StefanD2/Diplomarbeit_Hovercraft/README.md

# Diplomarbeit_Hovercraft
Diplomarbiet der HTBLuVA St. Pölten, Abteilung Elektrotechnik

## Schüler
* Stefan Deimel
* Philipp Eilmsteiner
* Julia Stöger
