StefanD2/Diplomarbeit_Hovercraft/Doku/Textparts/zusammenfassung.tex

\selectlanguage{naustrian}
\begin{abstract}
Das Ziel unserer Diplomarbeit ist es, aus einem Schlauchboot ein funktionstüchtiges elektrisches Luftkissenboot zu bauen, welches
sich sowohl am Land als auch über Wasser fortbewegen kann.\\
Mit einem von einem Elektromotor angetriebenen Propeller wird ein nach unten gerichteter Luftstrom erzeugt, auf welchem das Boot schwebt. Der zweite Propeller zeigt nach hinten und ist somit für den Vortrieb verantwortlich. Um das Boot lenkbar zu machen, sind drei servo-gesteuerte Fahnen zum Umlenken des Luftstroms am Heck montiert.\\
Der Fahrer ist in der Lage, das Luftkissenboot mit einem Lenker und zwei Daumengashebel zu steuern.
\end{abstract}
