StefanD2/Diplomarbeit_Hovercraft/Doku/Textparts/Kostenrechnung.tex

\section{Konstruktion}
\begin{table}[H]
    \centering
    \begin{tabular}{|l|r|}
        \hline
        \textbf{Beschreibung} & \textbf{Kosten}\\\hline
        diverse Kleinteile & 60\euro\\
        Fahrradlenker & 21\euro\\
        Holzlatten \&\ Staffel & 21\euro\\
        Holzschrauben & 15\euro\\
        Lochband & 14\euro\\
        metrische Schrauben \&\ Muttern & 60\euro\\
        Pappelsperrholz & 80\euro\\
        Pattex Kraftkleber & 18\euro\\
        PETG Filament & 22\euro\\
        Propeller & 276\euro\\
        Teichfolie & 22\euro\\
        Winkelverbinder & 50\euro\\
        \acs{xps} & 74\euro\\        
        \hline
        Zwischensumme & 733\euro\\\hline
    \end{tabular}
    \caption{Kostenrechnung -- Konstruktion}
\end{table}

\section{Leistungselektronik}
\begin{table}[H]
    \centering
    \begin{tabular}{|l|r|}
        \hline
        \textbf{Beschreibung} & \textbf{Kosten}\\\hline
        Akkus & 1\,672\euro\\
        Buck-Converter & 47\euro\\
        Hauptrelais & 162\euro\\
        Kupferschiene & 62\euro\\
        Ladegerät \&\ Schaltnetzteil & 520\euro\\
        Motoren & 2\,100\euro\\
        Motorregler \&\ Jeti-Box & 1\,079\euro\\
        Schmelzsicherungen & 15\euro\\
        Servos & 135\euro\\
        \hline
        Zwischensumme & 5\,792\euro\\\hline
    \end{tabular}
    \caption{Kostenrechnung -- Leistungselektronik}
\end{table}

\section{Boardelektronik}
\begin{table}[H]
    \centering
    \begin{tabular}{|l|r|}
        \hline
        \textbf{Beschreibung} & \textbf{Kosten}\\\hline
        4-poliges Kabel 100m & 30\euro\\
        Adafruit Servo-Modul & 13\euro\\
        Arduino-Nanos & 20\euro\\
        CAN-bus Module & 33\euro\\
        Daumengashebel & 28\euro\\
        diverse Kleinteile & 200\euro\\
        diverse Steckverbinder & 200\euro\\
        GPS-Modul & 13\euro\\
        Nextion-Display & 60\euro\\
        Not-Aus--Schalter & 68\euro\\        
        \hline
        Zwischensumme & 665\euro\\\hline
    \end{tabular}
    \caption{Kostenrechnung -- Leistungselektronik}
\end{table}

\section{Gesamtkosten}
\begin{table}[H]
    \centering
    \begin{tabular}{|l|r|}
        \hline
        \textbf{Beschreibung} & \textbf{Kosten}\\\hline
        Konstruktion & 733\euro\\
        Leistungselektronik & 5\,897\euro\\
        Boardelektronik & 665\euro\\
        \hline
        \textbf{Summe} & \textbf{7\,190\euro}\\\hline
    \end{tabular}
    \caption{Kostenrechnung -- Gesamtkosten}
\end{table}

\textbf{Anmerkung:}\\
Die hohen Gesamtkosten entstanden durch die hohe benötigte Motorleistung, welche den Preis der Motoren, der Motorregler und der Akkus begründet. Deshalb konnte diese Diplomarbeit nur durch die finanzielle Unterstützung unserer Sponsoren verwirklicht werden.
