StefanD2/Diplomarbeit_Hovercraft/Doku/Textparts/literatur.tex

%% start of file literatur.tex

%% Literaturverzeichnis:
\begin{Literatur}

    \bibitem[1]{YoutubeVideo}{\url{https://youtu.be/fBdnjvSfNkg}\\ Abgerufen am 17.3.2021} 
    \bibitem[2]{Inventor}{\url{https://www.autodesk.com/products/inventor/overview?term=1-YEAR&support=null}\\ Abgerufen am 16.3.2020} 
    \bibitem[3]{PlatformIO}{\url{https://platformio.org/platformio-ide}\\ Abgerufen am 19.3.2020} 
    \bibitem[4]{AnleitungJetiBox}{\url{http://www.jetimodel.com/en/show-file/47}\\ Abgerufen am 25.3.2020}
    \bibitem[5]{AnleitungMasterSpin}{\url{http://www.jetimodel.com/de/show-file/125}\\ Abgerufen am 25.03.2021}
    \bibitem[6]{ArduinoBibliothekCANBus}{\url{https://github.com/autowp/arduino-mcp2515}\\ Abgerufen am 31.03.2021}
    \bibitem[7]{ArduinoBibliothekServoPWM}{\url{https://github.com/adafruit/Adafruit-PWM-Servo-Driver-Library}\\ Abgerufen am 31.03.2021}
    \bibitem[8]{ArduinoBibliothekADS1115}{\url{https://github.com/adafruit/Adafruit_ADS1X15}\\ Abgerufen am 31.03.2021}
    \bibitem[9]{ArduinoBibliothekNextion}{\url{https://github.com/itead/ITEADLIB_Arduino_Nextion}\\ Abgerufen am 31.03.2021}
    \bibitem[10]{ArduinoBibliothekGPS}{\url{https://github.com/mikalhart/TinyGPSPlus}\\ Abgerufen am 31.03.2021}
    \bibitem[11]{JetiTelemtry}{\url{http://www.jetimodel.com/en/show-file/935/}\\ Abgerufen am 01.04.2021}
\end{Literatur}

%% end of file literatur.tex
