StefanD2/Diplomarbeit_Hovercraft/Doku/Textparts/danksagungen.tex

%% start of file danksagungen.tex

%% Danksagungen:
\begin{Danksagung}
    \responsible{Stefan Deimel, Philipp Eilmsteiner, Julia Stöger}
An dieser Stelle möchten wir uns bei all jenen bedanken, die uns bei unserer Diplomarbeit tatkräftig unterstützt und motiviert haben. \\

Zuerst bedanken wir uns recht herzlich bei Herrn Dipl.-Ing. Helge Frank, der uns während dieser Arbeit mit seinem Fachwissen unterstützt und weitergeholfen hat. 
Durch sein besonderes Interesse an dem Projekt gelang es ihm, sein Wissen sehr gut an uns zu übermitteln. \\

Weiters möchten wir uns bei Herrn Fachlehrer Meiseneder und bei Herrn Fachlehrer Binder für die großartige Unterstützung bei fehlendem Werkzeug und Fragen 
rund um das Thema Elektronik bedanken. Außerdem wollen wir auch allen anderen \\ Lehrerinnen und Lehrer danken, die uns mit ihrem Wissen weitergeholfen haben. \\

Spezieller Dank gilt auch unseren Familien, die uns stets motiviert haben und mental zur Seite gestanden sind. \\

Dank gebührt auch Herrn Ing. Andreas Bergen für seine tatkräftige Unterstützung und Ideen zu unserer Diplomarbeit. \\

Für die sehr gute Zusammenarbeit und die finanzielle Unterstützung bedanken wir uns bei all unseren Sponsoren: Schrack for Students, Schmied \&\ Fellmann, Kustec, EMC und Gottwald.\\
\end{Danksagung}
\newpage

%% end of file danksagungen.tex
