StefanD2/Diplomarbeit_Hovercraft/Doku/Textparts/abkuerzungen.tex

%% start of file abkuerzungen.tex

% Abkuerzungsverzeichnis
\addchap{
	\iflanguage{english}{Acronyms}{Abkürzungsverzeichnis}}
\begin{acronym}[ACRONYM]
%\acro{tikz}[TikZ]{\TikZ{} ist kein Zeichenprogramm}
\acro{spi}[SPI]{Serial Peripheral Interface}
\acro{i2c}[I$^2$C]{Inter-Integrated Circuit}
\acro{xps}[XPS]{Extrudiertes Polystyrol}
\acro{can}[CAN]{Controller Area Network}
\end{acronym}\newpage

%% end of file abkuerzungen.tex
