StefanD2/Diplomarbeit_Hovercraft/Doku/Textparts/Deimel/Leistungselektronik/Leistungselektronik.tex

\section{Schaltplan}
\begin{figure}[H]
    \input{Schaltplan.tex}
    \caption{Schaltplan Leistungselektronik\label{fig:schaltLeistung}}
\end{figure}
Für die Verbindung zwischen Board- und Leistungselektronik siehe \autoref{fig:SchaltplanBoardelektronik}.
Um die Lesbarkeit des Planes möglichst gut zu erhalten, wurde sowohl bei den PWM- als auch bei den Serial-Leitungen der beiden Motorregler auf das Einzeichnen separater +5V sowie GND Leitungen verzichtet und stattdessen mithilfe von doppelten Linien darauf aufmerksam gemacht.

\clearpage
\section{Verkabelung}
Da wir mit beiden Motoren einen Strom von 400A haben, verwenden wir Kupferschienen zur Verteilung dieses Stromes.\\
Die Akkus gehen jeweils mit beiden Anschlüssen über einen 10mm\textsuperscript{2}-Draht auf eine Kupferschiene. Die Motorregler sind ebenfalls mit jeweils zwei 10mm\textsuperscript{2}-Drähten angeschlossen, um bei diesen hohen Strömen möglichst wenig Spannungsabfall zu haben.\\
Das Hauptrelais ist über die Schmelzsicherungen direkt mit den Kupferschienen verschraubt.
\begin{figure}[H]
    
    \caption{Verkabelung Kupferschienen}
\end{figure}

\clearpage
