StefanD2/Diplomarbeit_Hovercraft/Doku/Textparts/Eilmsteiner/Boardelektronik/Platinen.tex

\clearpage
\section{Steuerungsplatinen}
\subsection{Schaltplan -- Übersicht}
\vspace{-0.2cm}
\begin{figure}[H]
    \centering
    \input{Uebersicht.tex}
    \caption{Schaltplan Boardelektronik\label{fig:SchaltplanBoardelektronik}}
\end{figure}
\vspace{-0.5cm}
{\small
Auf die Versorgung der LM35-Temperatursensoren, sowie der beiden Daumengase und dem Lenkpotenziometer mit +5V und GND wurde aus Platzgründen im obigen Plan verzichtet und stattdessen mit doppelten Linien aufmerksam gemacht. 
Siehe zudem \autoref{fig:schaltLeistung} für die Verbindung des Planes zur Leistungselektronik.
}

\newpage
\subsection{Motorregleransteuerung\label{sec:Motorregleransteuerung}}
\subsubsection{Aufgaben \& verwendete Bauteile}
Diese Platinen wandeln die entsprechenden vom CAN-Bus übertragenen Daten mithilfe ihres 16-bit Timers (Timer1 des ATMEGA328p) in ein für unseren Motorregler verständliches PWM-Muster um.
Gleichzeitig übermitteln sie die von den Motorreglern übertragenen Telemetriedaten an den Controller des Lenkers.

\begin{minipage}{8.5cm}
    \begin{tikzpicture}
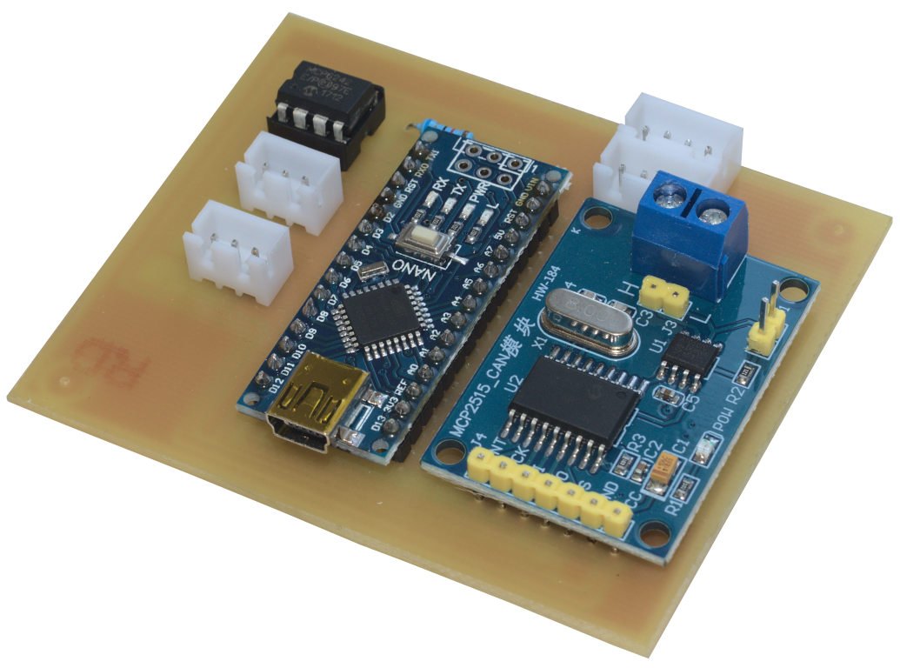
[picture p20: Doku/Fotos/Regler_Platine.png]
        \node[anchor=south west,inner sep=0] (image) at (0,0) {};
        \begin{scope}[x={(image.south east)},y={(image.north west)}]
            \draw[red,ultra thick,rounded corners,rotate around={-23:(0.68,0.68)}] (0.62,0.67) rectangle (0.8,0.9);
            \draw[blue,ultra thick,rounded corners,rotate around={-20:(0.3,0.68)}] (0.2,0.53) rectangle (0.35,0.7);
            \draw[orange,ultra thick,rounded corners,rotate around={-20:(0.35,0.78)}] (0.26,0.66) rectangle (0.41,0.8);
        \end{scope}
    \end{tikzpicture}
    \captionof{figure}{Platine zur Regleransteuerung}
\end{minipage}
\begin{minipage}{7cm}
    \textcolor{red}{CAN-Bus Anschlüsse}\\
    \textcolor{orange}{Serielle Verbindung zum Regler}\\
    \textcolor{blue}{PWM-Ausgang}\\

\end{minipage}

\subsubsection{Anmerkung:}
Durch die Verwendung der seriellen Schnittstelle des Arduinos muss zur Programmierung der Operationsverstärker entfernt werden.
\newpage

\subsubsection{Schaltplan}
\begin{figure}[h]
    \centering
        
    \caption{Schaltplan der Regler-Platine\label{fig:plat:regler}}
\end{figure}

\newpage

\subsubsection{PCB-Layout}
\begin{figure}[h]
    \centering
        
    \caption{PCB-Layout der Regler-Platine}
\end{figure}

\newpage
\subsubsection{Programmcode}
\lstinputlisting{../Programmierung/Regler_Controller/src/main.cpp}
\newpage
\subsection{Lenker\label{sec:Lenkerplatine}}
\subsubsection{Aufgaben \& verwendete Bauteile}
Neben seiner Hauptaufgabe, nämlich dem Einlesen und der Übertragung der beiden Daumengas- sowie Lenkerstellungen, ist dieser Mikrocontroller weiters für die Darstellung der von den verschiedenen Komponenten erhaltenen Telemetriedaten auf dem Bildschirm verantwortlich.
Dazu zählen neben den Informationen über die beiden Motoren vor allem auch die Temperaturen aller verbauten Akkus sowie die per GPS-Modul ermittelte derzeitige Geschwindigkeit.

\begin{minipage}{8.5cm}
    \begin{tikzpicture}
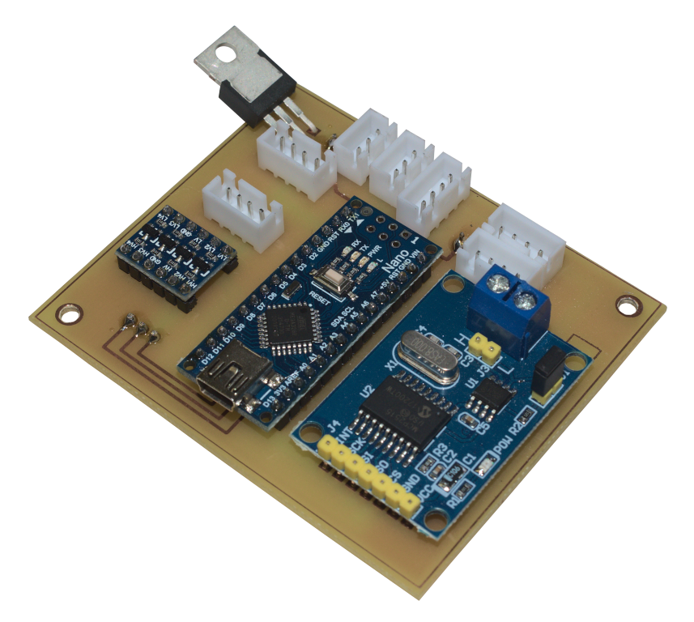
[picture p21: Doku/Fotos/Regler_Lenker.png]
        \node[anchor=south west,inner sep=0] (image) at (0,0) {};
        \begin{scope}[x={(image.south east)},y={(image.north west)}]
            \draw[red,ultra thick,rounded corners,rotate around={-30:(0.77,0.47)}] (0.6,0.47) rectangle (0.77,0.62);
            \draw[blue,ultra thick,rounded corners,rotate around={-30:(0.4,0.58)}] (0.25,0.58) rectangle (0.4,0.68);
            \draw[orange,ultra thick,rounded corners,rotate around={-30:(0.47,0.67)}] (0.33,0.67) rectangle (0.47,0.76);
            \draw[Green,ultra thick,rounded corners,rotate around={-34:(0.57,0.67)}] (0.45,0.67) rectangle (0.57,0.8);
            \draw[violet,ultra thick,rounded corners,rotate around={-34:(0.62,0.60)}] (0.54,0.60) rectangle (0.62,0.75);
        \end{scope}
    \end{tikzpicture}
    \captionof{figure}{Platine des Lenkers}
\end{minipage}
\begin{minipage}{7cm}
    \textcolor{red}{CAN-Bus Anschlüsse}\\
    \textcolor{blue}{Serielle Verbindung zum GPS-Modul}\\
    \textcolor{orange}{Serielle Verbindung zum Bildschirm}\\
    \textcolor{Green}{Daumengas Anschlüsse}\\
    \textcolor{violet}{Anschluss Lenkerpotenziometer}\\

\end{minipage}

\vspace{0.5cm}
\begin{minipage}{7.5cm}
    \centering
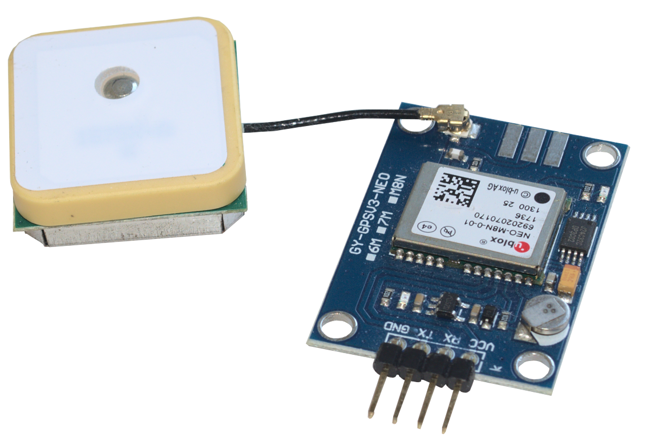
[picture p22: Doku/Fotos/GPS_Modul_2.png]
    
    \captionof{figure}{NEO-8M GPS-Modul}
\end{minipage}
\hspace{0.1cm}
\begin{minipage}{7.5cm}
    \centering
    
    \captionof{figure}{Daumengas}
\end{minipage}

\newpage

\subsubsection{Schaltplan}
\begin{figure}[h]
    \centering
        
    \caption{Schaltplan der Lenker-Platine\label{fig:plat:lenker}}
\end{figure}

\newpage

\subsubsection{PCB-Layout}
\begin{figure}[h]
    \centering
        
    \caption{PCB-Layout der Lenker-Platine}
\end{figure}

\newpage
\subsubsection{Programmcode}
\lstinputlisting{../Programmierung/Lenker_Controller/src/main.cpp}

\newpage

\subsection{Fahnenansteuerung \&\ Akkutemperaturen\label{sec:Servoplatine}}
\subsubsection{Fahnenansteuerung}
Die Ansteuerung der Servos erfolgt ebenfalls mit einem per CAN-Bus angeschlossenen Arduino. Um die für die Steuerung der drei Servos benötigten PWM-Signale, unabhängig von den durch den Arduino bereitgestellten Timer und den damit verbundenen GPIOs, zu erzeugen 
(Anbindung des CAN-Bus Moduls über SPI benötigt beispielsweise diese Pins und Timer), wurde dafür auf ein externes Board zurückgegriffen.

\begin{minipage}{8.5cm}
    \begin{tikzpicture}
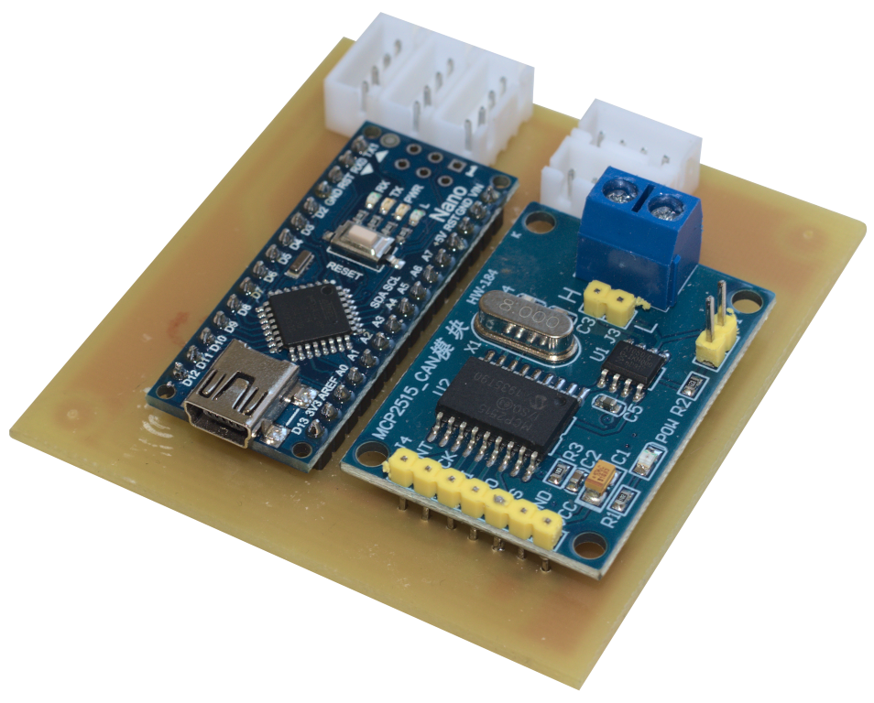
[picture p23: Doku/Fotos/Regler_Servos.png]
        \node[anchor=south west,inner sep=0] (image) at (0,0) {};
        \begin{scope}[x={(image.south east)},y={(image.north west)}]
            \draw[red,ultra thick,rounded corners,rotate around={-23:(0.64,0.68)}] (0.58,0.67) rectangle (0.78,0.9);
            \draw[blue,ultra thick,rounded corners,rotate around={-20:(0.5,0.9)}] (0.37,0.76) rectangle (0.63,0.99);
        \end{scope}
    \end{tikzpicture}
    \captionof{figure}{Platine zur Regleransteuerung}
\end{minipage}
\begin{minipage}{7cm}
    \textcolor{red}{CAN-Bus Anschlüsse}\\
    \textcolor{blue}{I2C Anschlüsse}\\
    
\end{minipage}\\

Konkret handelt es sich um das \textbf{16-Channel 12-bit PWM/Servo Driver Module} von Adafruit, welcher mittels I2C mit dem Mikrocontroller kommuniziert.\\
\begin{figure}[h]
    \centering
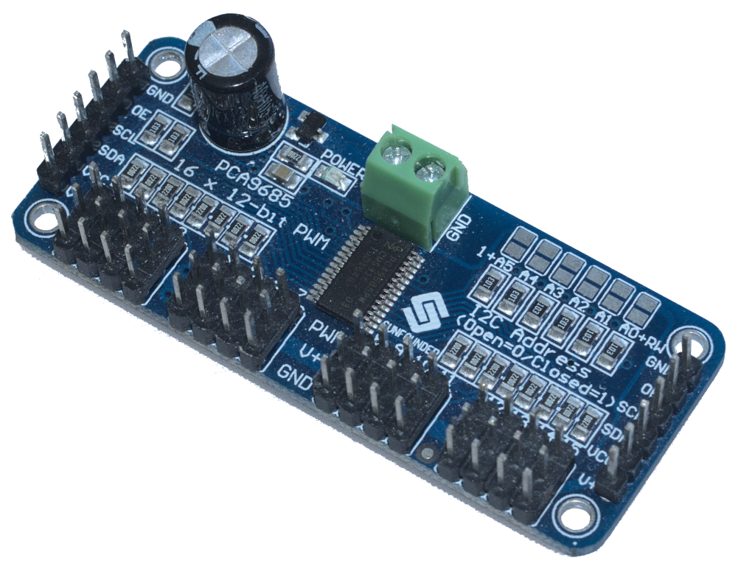
[picture p24: Doku/Fotos/Servo_Controller.png]
    
    \caption{Adafruit 16-Channel Servo Driver}
\end{figure}

\newpage
\subsubsection{Schaltplan}
\begin{figure}[h]
    \centering
        
    \caption{Schaltplan der Servoansteuerungs-Platine\label{fig:plat:servo}}
\end{figure}

\newpage
\subsubsection{PCB-Layout}
\begin{figure}[h]
    \centering
        
    \caption{PCB-Layout der Servoansteuerungs-Platine}
\end{figure}

\newpage
\subsubsection{Programmcode}
\lstinputlisting{../Programmierung/Servo_ADC_Controller/src/main.cpp}
\newpage

\subsubsection{Akkutemperaturen}
Die zweite Aufgabe dieses Controllers ist es, die Temperaturen aller acht im Boot verbauten Akkus zu überwachen, und diese zur Darstellung an den Controller des Lenkers zu übermitteln.
Dies geschieht mithilfe zweier (je einer pro Seite), ebenfalls über I2C verbundenen, \textbf{ADS1115} Analog-Digital-Wandler, welche wiederum von Adafruit stammen.\\
Zur Temperaturmessung selbst kommt je ein \textbf{LM35} Temperatursensor pro Akku zum Einsatz.\\

\begin{minipage}{8cm}
    \centering
    
    \captionof{figure}{ADS1115 Modul}    
\end{minipage}
\begin{minipage}{8cm}
    \centering
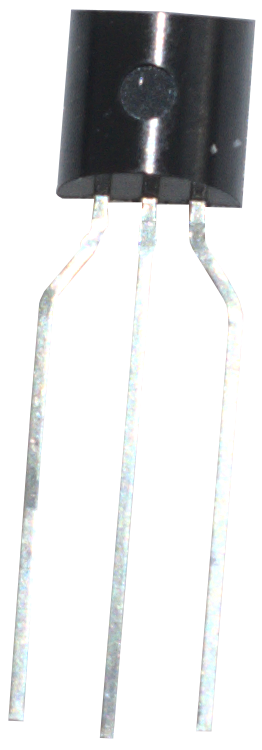
[picture p25: Doku/Fotos/LM35.png]
    
    \captionof{figure}{LM35}
\end{minipage}\\
\vspace{0.5cm}

\subsection{ADC-Platinen}
Um den Anschluss der Temperatursensoren an diesem ADC zu vereinfachen, wurde folgende Platine entworfen:\\ 
\begin{minipage}{9cm}
    \begin{tikzpicture}
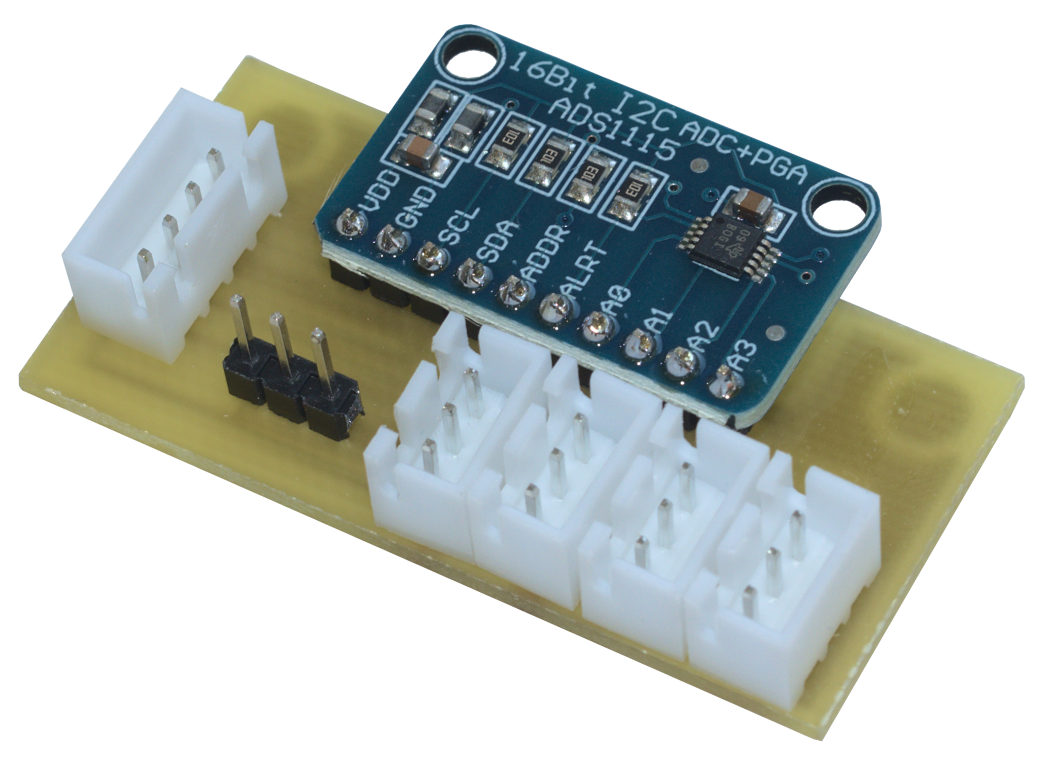
[picture p26: Doku/Fotos/ADC_Platine.png]
        \node[anchor=south west,inner sep=0] (image) at (0,0) {};
        \begin{scope}[x={(image.south east)},y={(image.north west)}]
            \draw[red,ultra thick,rounded corners,rotate around={-23:(0.78,0.0)}] (0.25,0.0) rectangle (0.78,0.4);
            \draw[blue,ultra thick,rounded corners,,rotate around={-30:(0.00,0.59)}] (0.00,0.59) rectangle (0.20,0.99);
            \draw[Green,ultra thick,rounded corners,,rotate around={-27:(0.3,0.4)}] (0.15,0.4) rectangle (0.34,0.57);
        \end{scope}
    \end{tikzpicture}
    \captionof{figure}{Platine Temperatursensoren}
\end{minipage}
\begin{minipage}{7cm}
    \textcolor{red}{Analogeingänge}\\
    \textcolor{blue}{I2C Anschluss}\\
    \textcolor{Green}{I2C Adressen-Jumper}\\
\end{minipage}\\

\newpage
\subsubsection{Schaltplan}
\begin{figure}[h]
    \centering
        
    \caption{Schaltplan der Temperatursensoren-Platine\label{fig:plat:temp}}
\end{figure}

\newpage

\subsubsection{PCB-Layout}
\begin{figure}[h]
    \centering
        
    \caption{PCB-Layout der Temperatursensoren-Platine}
\end{figure}

\newpage
\subsection{Precharge \& Relaisansteuerung\label{sec:precharge}}
Da sowohl die Motorregler als auch die Buck-Converter einen, bedingt durch die darin verbauten sehr großen Kondensatoren, sehr großen Einschaltstrom haben, 
müssen diese über einen Leistungswiderstand vorgeladen werden, bevor sie permanent mit Spannung versorgt werden können.\\
\begin{figure}[h]
    \centering
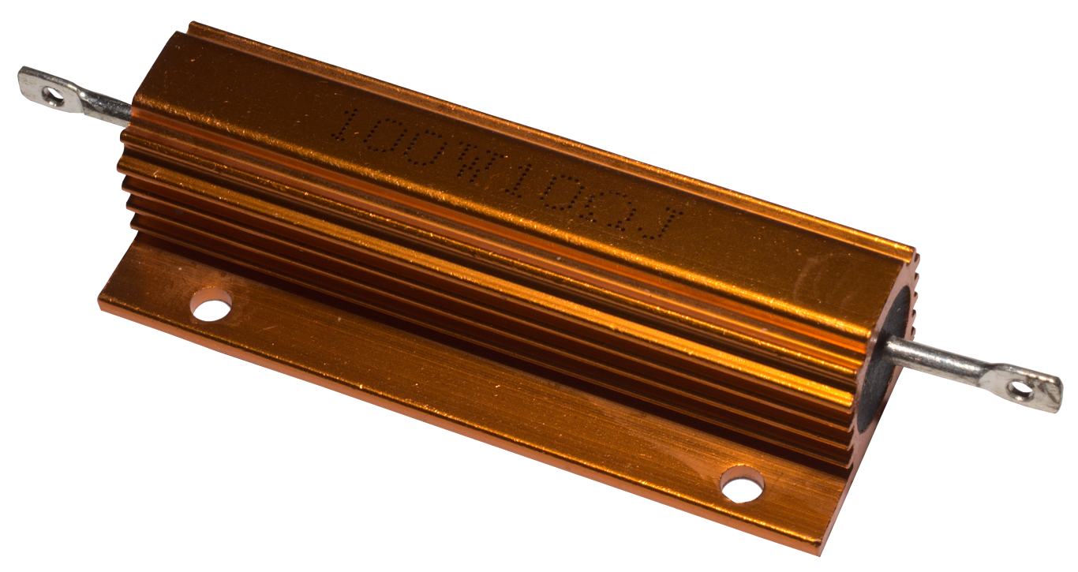
[picture p27: Doku/Fotos/Leistungswiderstand.png]
    
    \caption{Zur Vorladung verwendeter Leistungswiderstand}
\end{figure}

Um diese Umschaltung so einfach wie möglich zu gestalten, wurde dies mithilfe einer im Folgenden genauer erläuterten Platine realisiert. 

\begin{minipage}{9cm}
    \begin{tikzpicture}
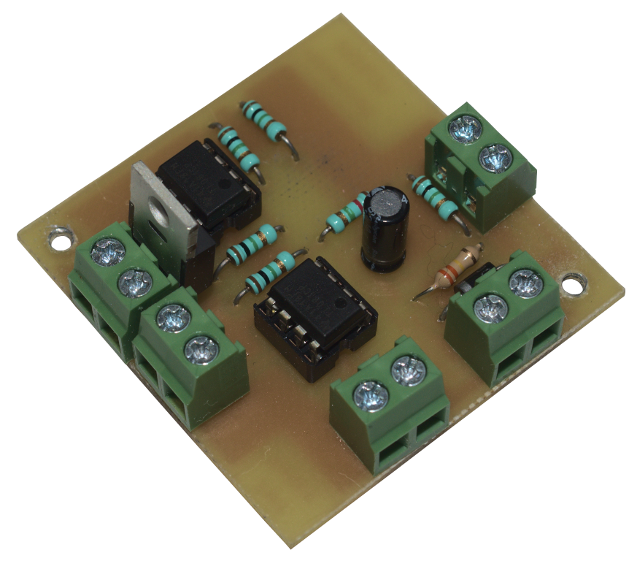
[picture p28: Doku/Fotos/Platine_Relaischaltung.png]
        \node[anchor=south west,inner sep=0] (image) at (0,0) {};
        \begin{scope}[x={(image.south east)},y={(image.north west)}]
            \draw[red,ultra thick,rounded corners,rotate around={30:(0.58,0.11)}] (0.58,0.11) rectangle (0.79,0.35);
            \draw[blue,ultra thick,rounded corners,rotate around={30:(0.77,0.28)}] (0.77,0.28) rectangle (0.97,0.51);
            \draw[orange,ultra thick,rounded corners,rotate around={37:(0.29,0.21)}] (0.29,0.21) rectangle (0.46,0.42);
            \draw[Green,ultra thick,rounded corners,rotate around={37:(0.16,0.38)}] (0.16,0.38) rectangle (0.34,0.55);
            \draw[violet,ultra thick,rounded corners,rotate around={40:(0.78,0.56)}] (0.78,0.56) rectangle (0.93,0.81);
        \end{scope}
    \end{tikzpicture}
    \captionof{figure}{Platine zur Relaisansteuerung}
\end{minipage}
\begin{minipage}{7.5cm}
    \textcolor{Green}{Hauptrelaisspule (A- \& GND) (J6)}\\
    \textcolor{blue}{Micro-Switches im Ladedeckel (J1)}\\
    \textcolor{orange}{Buck-Converter (nicht verwendet) (J2)}\\
    \textcolor{violet}{+30 V von geschalteter Relaisseite (J7)}\\
    \textcolor{red}{Konstante +30 V (J8)}\\
\end{minipage}\\

\textbf{Anmerkung:}\\
Die Relais der Buck-Converter werden nicht mehr, wie ursprünglich gedacht, über eine separate Zeitkonstante angesteuert, sondern verwenden nun den selben MOSFET wie das Hauptrelais. 

\newpage
\subsubsection{Funktionsweise}
Durch das Zusammenschalten der Akkus über den bereits zuvor gezeigten $10\,\mathrm{\Omega}$ Leistungswiderstand beginnen sich sowohl die Kondensatoren beider Motorregler und aller vier Buck-Converter, sowie jener des sich auf der Platine befindlichen RC-Gliedes aufzuladen.\\
Erreicht dieser eine bestimmte Schwellspannung, wird das Hauptrelais mithilfe eines MOSFETs durch den Operationsverstärker der Komperatorschaltung aktiviert.\\
Dies führt zu einer Selbsthaltung des Relais, welche nur durch Betätigung des Not-Aus--Schalters oder das Öffnen einer der beiden Mikroschalter unterbrochen werden kann.\\
Der genaue Anschluss an die Leistungselektronik kann \autoref{fig:schaltLeistung} entnommen werden.
\subsubsection{Schaltplan}
\begin{figure}[h]
    \centering
    
    \caption{Schaltplan der Platine zur Relaisansteuerung\label{fig:plat:relais}}
\end{figure}
\textbf{Anmerkung:}\\
Der OPV \textbf{U2} und die damit verbunde Klemme \textbf{J2} werden aufgrund einer nachträglichen Änderung im Schaltplan nicht mehr benötigt.
\newpage
\subsubsection{PCB-Layout}
\begin{figure}[h]
    \centering
    
    \caption{PCB-Layout der Platine zur Relaisansteuerung}
\end{figure}
\newpage

\subsection{Platzierung am Boot}
Die Abbildungen \ref{fig:Platinen:Aufbau_Rechts} \& \ref{fig:Platinen:Aufbau_Links} zeigen die Positionen aller verbauten Platinen am Boot.\\

\begin{minipage}{\textwidth}
    \centering
    \begin{tikzpicture}
        \node[anchor=south west,inner sep=0] (image) at (0,0) {};
        \begin{scope}[x={(image.south east)},y={(image.north west)}]
            \draw[blue,thick,->]  (0.66,0.85) -- (0.29,0.85) node [at start, above] {Temperatursensoren rechts} -- (0.22,0.40);
            \draw[black,thick,->]  (0.66,0.75) -- (0.29,0.75) node [at start, above] {Relaisansteuerung} -- (0.27,0.60);
            \draw[red,thick,->]  (0.66,0.65) -- (0.29,0.65) node [at start, above] {Regler-hinten Platine}  -- (0.27,0.51);
            \draw[black,thick,->]  (0.66,0.55) -- (0.5,0.55) node [at start, above] {Regler-unten Platine} -- (0.47,0.19);
            \draw[Green,thick,->]  (0.54,0.45) -- (0.78,0.45) node [midway, above] {Lenker Platine} -- (0.89,0.14);
        \end{scope}
    \end{tikzpicture}
    \captionof{figure}{Platinen auf der rechten Seite des Bootes}
    \label{fig:Platinen:Aufbau_Rechts}
\end{minipage}

\begin{minipage}{\textwidth}
    \centering
    \begin{tikzpicture}
        \node[anchor=south west,inner sep=0] (image) at (0,0) {};
        \begin{scope}[x={(image.south east)},y={(image.north west)}]
            \draw[red,thick,->]  (0.22,0.75) -- (0.5,0.75) node [midway, above] {Servo-ADC Platine}  -- (0.6,0.61);
            \draw[blue,thick,->]  (0.22,0.85) -- (0.5,0.85) node [midway, above] {Servo-Controller}  -- (0.61,0.81);
            \draw[black,thick,->]  (0.22,0.65) -- (0.49,0.65) node [near start, above] {Temperatursensoren links}  -- (0.545,0.42);
        \end{scope}
    \end{tikzpicture}
    \captionof{figure}{Platinen auf der linken Seite des Bootes}
    \label{fig:Platinen:Aufbau_Links}
\end{minipage}

\newpage
