StefanD2/Diplomarbeit_Hovercraft/Doku/Textparts/Deimel/Zeit/Zeit_Deimel.tex

14.02.2020 & 8 & Konstruktion in Inventor\\\hline
15.02.2020 & 4 & Konstruktion in Inventor\\\hline
28.02.2020 & 1 & Besprechung mit Betreungslehrer\\\hline
12.03.2020 & 1 & Besprechung mit Betreungslehrer\\\hline
13.03.2020 & 4 & Erstes Zusammenbauen des Hovercrafts\\\hline
14.05.2020 & 5 & Akkukabel gebaut, Motorregler \&\ Motorstecker montiert\\\hline
23.05.2020 & 5 & Propeller montiert, erste Tests am Hovercraft\\\hline
06.06.2020 & 7 & Jeti-Protokoll decodiert für Arduino\\\hline
18.06.2020 & 1 & Besprechung mit Betreuungslehrer, Bestellung vorbereitet\\\hline
27.07.2020 & 1 & Verbesserung der Konstruktion in Inventor\\\hline
29.07.2020 & 1 & Besprechung auf Teams, Festlegung von Meilensteinen\\\hline
03.08.2020 & 8 & Propeller zusammengebaut\\\hline
04.08.2020 & 3 & Tests am Hovercraft\\\hline
10.08.2020 & 8 & Bodenplatte/XPS gefertigt\\\hline
11.08.2020 & 7 & Bodenplatte/XPS + Holz gefertigt\\\hline
14.08.2020 & 5 & Motor montiert + Tests\\\hline
25.08.2020 & 7 & Transport des Luftkissenbootes in die Schule, Treffen mit SchrackForStudents\\\hline
17.09.2020 & 2 & Bestellliste für Elektronik erstellt, Bauteile ausgewählt\\\hline
20.09.2020 & 2 & Bestellliste für Elektronik erstellt, Bauteile ausgewählt\\\hline
25.09.2020 & 2 & Teichfolie geklebt\\\hline
21.10.2020 & 6 & Konstruktion in Inventor -- Aufbau hinten\\\hline
22.10.2020 & 2 & Konstruktion in Inventor -- Aufbau hinten, Fahnen + Halterung\\\hline
23.10.2020 & 1 & Logos von Kustec abgeholt\\\hline
23.10.2020 & 2 & Besprechung auf Teams, Obi-Einkauf \&\ nächste Schritte geplant\\\hline
24.10.2020 & 2 & Obi-Einkauf\\\hline
26.10.2020 & 1,5 & Programmierung JetiBox-Decode für Arduino verbessert (Buffer hinzugefügt)\\\hline
29.10.2020 & 6 & Verbesserung der Konstruktion in Inventor\\\hline
30.10.2020 & 6,5 & Verbesserung der Konstruktion in Inventor\\\hline
09.11.2020 & 4 & Konstruktion hinten am Boot befestigt\\\hline
10.11.2020 & 3 & Verstärkung des hinteren Aufbaues \\\hline
10.11.2020 & 1 & Besprechung mit Betreuungslehrer (Lenkung, derzeitiger Fortschritt)\\\hline
17.11.2020 & 2 & Test der Fahnensteuerung mit Servos\\\hline
21.11.2020 & 2 & Besprechung Teams: Elektronik und Lenkung, nächste Bestellung geplant\\\hline
21.11.2020 & 0,5 & Bauteile ausgewählt\\\hline
21.11.2020 & 1 & Lenkungsentwurf in Inventor gezeichnet\\\hline
25.11.2020 & 6 & hinteres Gitter montiert, Teichfolie geklebt\\\hline
28.11.2020 & 1 & RS-Bauteile ausgewählt\\\hline
29.11.2020 & 2 & Lenker in Inventor konstruiert\\\hline
30.11.2020 & 1 & Verbindungsteile für Lenkerstange in Inventor konstruiert\\\hline
16.12.2020 & 4 & Erste Versuche mit der fertigen Konstruktion\\\hline
15.12.2020 & 3 & Lasercutten\\\hline
27.12.2020 & 2 & Lasercutten und Inventor-Dateien vorbereitet\\\hline
28.12.2020 & 10,5 & Servos montiert, Lenkung getestet, CAN-Bus getestet\\\hline
28.12.2020 & 3 & Kupferschiene geschnitten (Gewinde), Schrauben zugeschnitten\\\hline
29.12.2020 & 7 & Kupferschienen und Bucks montiert\\\hline
01.01.2021 & 1 & M5 Schrauben geschnitten\\\hline
02.01.2021 & 12 & Kupferschiene und Temperatursensoren verkabelt, Reglerplatine gezeichnet\\\hline
03.01.2021 & 11 & Servos verkabelt, Lenkung moniert\\\hline
19.01.2021 & 5 & Platinen hergestellt, geätzt, gebohrt\\\hline
25.01.2021 & 8 & Taster, Not-Aus-Schalter montiert, HMI getestet, Balancer-Kabel gelötet\\\hline
26.01.2021 & 5 & weitere Platinen hergestellt, geätzt, gebohrt\\\hline
29.01.2021 & 9 & Platinen gebohrt, gelötet und im Hovercraft verbaut, Stecker an Kabel gelötet\\\hline
30.01.2021 & 11 & Erste Einschaltversuche durchgeführt\\\hline
02.02.2021 & 8 & Display getestet, Einschaltverzögerungsplatine getestet\\\hline
02.02.2021 & 1 & Proteus Platine Zeitverzögerung umgezeichnet\\\hline
07.02.2021 & 3 & Inventor-Modell in einzelnen Bauteile zerlegt, Doku weitergeschrieben\\\hline
13.02.2021 & 6 & Halbleiterrelais eingebaut - Defekt festgestellt, Platine gelötet, Zeichnungen in Inventor erstellt\\\hline
15.02.2021 & 4 & Boden geklebt\\\hline
16.02.2021 & 4 & Lochband fertiggestellt, Leiste fertiggestellt, fotografiert\\\hline
17.02.2021 & 11 & neues hinteres Gitter montiert,  Halbleiterrelais getestet - defekt\\\hline
02.03.2021 & 4 & Doku Konstruktion weitergeschrieben\\\hline
01.03.2021 & 5 & Strommessung am unteren Motor\\\hline
04.03.2021 & 4 & Probefahrt\\\hline
16.03.2021 & 5 & Doku weitergeschrieben\\\hline
17.03.2021 & 2 & Doku durchgelesen und verbessert\\\hline
18.03.2021 & 3 & Doku finalisiert\\\hline
