StefanD2/Diplomarbeit_Hovercraft/Doku/Textparts/Eilmsteiner/Leistungselektronik/Leistungselektronik.tex

\section{Motoren}
\begin{figure}[h]
    \centering
    
    \caption{Hacker A200 Elektromotor}
\end{figure}
\todo[]{Text und Bilder zu Motoren einfügen}
\newpage
\section{Motorregler}
Die Ansteuerung der Motoren übernimmt der dafür empfohlene \textbf{MasterSpin 220 Pro OPTO}.
\begin{figure}[h]
    \centering
    
    \caption{MasterSPIN 220 Pro OPTO}
\end{figure}
\subsection*{Parametrierung durch JetiBox}
Um den Regler auf unsere Bedürfnisse parametrieren zu können, wurde eine sogenannte "JetiBox" verwendet.
\begin{figure}[h]
    \centering
    
    \caption{Jetibox}
\end{figure}
\newpage
Um in das Konfigurationsmenü des Reglers zu gelangen, muss die JetiBox am kürzeren der beiden 3-poligen Kabeln des MasterSpin 220 PRO OPTO angeschlossenen werden (Jenes mit dem roten Stecker), 
während man das PWM-Kabel (länger \& schwarzer Stecker) abgeschlossen hat.\\

Konkret wurden folgende Einstellungen getroffen:\\
\begin{table}[h]
\centering
\begin{threeparttable}
    
    \begin{tabular}{|l|l|}
    \hline
     Menüpunkt & getroffene Einstellung \\\hline
     Temp. Protection & $90\,^\circ\,\textrm{C}$\\
     Brake & Hard 70/100/0,5s\\
     Operation Mode & Fast Response\\
     Autorotation & OFF\\
     Timing & $22^\circ$\\
     Frequency & 8 kHz\\
     Acceleration & 0-100\% 5,0 s\\
     Accumulator Type & Li-Ion/Pol/Fe\\
     Number of Cells & Li-XX 14\\
     Li-XX Cut OFF & V Per Cell 3.2\\
     Off Voltage Set & 44,75 V\\
     Cut OFF & Slow Down\\
     Initial Point & AUTO\\
     END Point & 2.05 ms / 2.15 ms \tnote{1}\\
     AutoInc.END Poin & OFF(FIX)\\
     Throttle Curve & Linear\\
     Rotation & Left \tnote{2}\\
     Start-up Power & Auto\\
     Setting th. R/C & OFF\\\hline
    \end{tabular}
    \begin{tablenotes}\footnotesize 
        \item[1] 2.15 ms zur Begrenzung der Motorleistung auf \\$\approx 90\%$
        \item[2] Abhängig von der Verkabelung des Motors 
        \end{tablenotes}
    \end{threeparttable}
    \caption{Durch JetiBox am Regler konfigurierte Parameter}
\end{table}

\newpage

\section{Hauptrelais}
Mit diesem Relais wird die Spannungsversorgung des gesamten Luftkissenbootes kontrolliert. Bedingt durch die Tatsache, dass das gewählte Ladegerät nur maximal 8S-Lipo Akkus laden kann und wir durch die Serienschaltung 2er 7S Akkus auf insgesamt 14S sind, 
wurde es zwischen den beiden Parallelschaltungen von jeweils 4 Akkus platziert. 
\begin{figure}[h]
    \centering
    
    \caption{TE Connectivity EV200 Kfz-Relais}
\end{figure}

\newpage
\section{Buck-Converter}
Die Versorgung der Bootelektronik und der Servos übernehmen Buck-Converter, von welchen jeweils einer für ein Servo und einer für die gesamte restliche Elektronilk verbaut sind.
\begin{figure}[h]
    \centering
    
    \caption{Buck Converter}
\end{figure}

Wichtig war bei der Auswahl dieser, auf die maximale Eingangsspannung von mindestens $60\,\mathrm{V}$ zu achten. Sehr viele der angebotenen Buck-Converter sind auf $40\,\mathrm{V}$ begrenzt und können daher nicht verwendet werden.
Auch ein Mindeststrom von $6\,\mathrm{A}$ sekundärseitig ist aufgrund des hohen Leistungsbedarfes der Servos von nöten. 
\newpage

\section{Akkus \label{sec:Akkus}}
Nach gründlicher Überlegung, welche Form von Energiespeicher für unser Boot die Beste wäre, fiel die Wahl auf die TopFuel LiPo 35C Power-X 7500mAh 7S.
Ursprüngliche Pläne den Akku selbst aus 18650-Zellen zusammenzubauen wurden verworfen, da er dadurch bei gleicher speicherbarer Energiemenge, deutlich schwerer und auch größer ausgefallen wäre.
\begin{figure}[h]
    \centering
    
    \caption{TopFuel Power-X 7500mAh 7S}
\end{figure}

Auf jeder Seite des Bootes sind, versteckt im hinteren Aufbau, jeweils vier von diesen Akkus verbaut. Mit einer Kapazität von $7500\,\textrm{mAh}$ und einer Nominalspannung von $25.9\,\mathrm{V}$ pro Akku ergibt sich somit eine Gesamtkapazität von zirka $1.55\,\mathrm{kWh}$.

\newpage
