StefanD2/Diplomarbeit_Hovercraft/Doku/diplomarbeit.tex

%% diplomarbeit.tex
%% Copyright 2015 Simon M. Laube
%
% This work may be distributed and/or modified under the
% conditions of the LaTeX Project Public License, either version 1.3
% of this license or (at your option) any later version.
% The latest version of this license is in
%   http://www.latex-project.org/lppl.txt
% and version 1.3 or later is part of all distributions of LaTeX
% version 2005/12/01 or later. 
%
% This work has the LPPL maintenance status `author maintained'.
% 
% The Current Maintainer of this work is S. M. Laube
%
% This work consists of the files listed in ./Help/files.txt
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
\usepackage[europeanresistors, europeaninductors, european, siunitx]{circuitikz}
% Nuetzliche TikZ Libraries
\usetikzlibrary{arrows,automata,positioning}
\usetikzlibrary{math}
\usetikzlibrary{fit}
% Mathematikpakete!
\usepackage{amsmath,amssymb}							
%\usepackage{mathtools}	
% PDF Einbindung (zB Datenblaetter)
\usepackage{pdfpages}
% Source Code Einbindung, Setup siehe:
% http://en.wikibooks.org/wiki/LaTeX/Source_Code_Listings									
\usepackage{listings,scrhack} %scrhack vermeidet Umschaltung auf KOMA Floats..

\usepackage{verbatim}
\usepackage{textcomp}
			
\usepackage{eurosym}
\usepackage{lscape}
% Diplomarbeitsspezifisches Package etdipa
\usepackage{etdipa}

%% Abkuerzungsverzeichnis
\usepackage[]{acronym}

%% Todos 
% --------------------------------------------------------------------------- TODONOTE PACKAGE ---------------------------------------------------------------------------%
%\usepackage[]{todonotes}

%% Ganttdiagramme
\usepackage{pgfgantt}

\usepackage{keyval}
\usepackage{caption}

%% Subfigures
\usepackage[lofdepth]{subfig}

%% HTL-Package (für HTL-Grün)
\usepackage{htlstp}

\usepackage{import}

\usepackage{array}
\usepackage{ragged2e}
\usepackage{csvsimple}

\usepackage{wasysym}
%\usepackage{afterpage}

%\usepackage{pdflscape}
\usepackage{lscape}

\usepackage{setspace}\usepackage{threeparttable}
\usepackage{graphbox} %loads graphicx package
\usepackage[most]{tcolorbox}
\usepackage{multirow}

\usepackage{longtable}

\usepackage{nameref}
\usepackage{arrayjob}
% folowing  must be in this order
\usepackage{varioref}
\usepackage[colorlinks=true,
			linkcolor=black,
			citecolor=green,
			bookmarks=true,
			urlcolor=blue,
			bookmarksopen=true]{hyperref}
\usepackage{cleveref}

\RedeclareSectionCommand[beforeskip=0pt]{chapter}

%------------------ DELETE THIS, JUST FOR SPEED -------------------%
% \pdfcompresslevel=0 
% \pdfobjcompresslevel=0
%------------------------------------------------------------------%

%%=== MY COMMANDS ====%%

\newcolumntype{M}[1]{>{\centering\arraybackslash}m{#1}}

\newcommand{\includeSkizze}[4]{
  \begin{figure}[H]
    \centering
    \resizebox{.95\textheight}{!}{
    
    }
    \caption{Zeichnung #2\label{#3}}
  \end{figure}
}

%%==== Definitionen fuer die Diplomarbeit ============%%
\dokumenttyp{DIPLOMARBEIT}
\title{Hovercraft}
\author{Stefan Deimel \and Philipp Eilmsteiner \and Julia Katharina Stöger}
\date{\today}
\place{St. P\"olten}
\schuljahr{2020/21}
\professor{Dipl.-Ing. Helge Frank}
\dipacolor{htlgruen}
%%====================================================%%

\lstset {
    language=C++,
    breaklines=true,
    postbreak=\mbox{\textcolor{red}{$\hookrightarrow$}\space},
    basicstyle=\scriptsize\ttfamily,
    keywordstyle=\color{red!60!blue}\ttfamily,
    stringstyle=\color{red}\ttfamily,
    commentstyle=\color{green!50!black}\ttfamily,
    numbers=left, numbersep=5pt,
    showspaces=false,
    showstringspaces=false,
    emph={
        uint16_t, uint32_t, size_t, string, std, override, private, public, class, int, double, float, char, long, bool, void, protected, virtual, static, volatile, __cplusplus, extern, ISR, true, false, this, namespace, if, else, for, while, return, sizeof, new, delete, unsigned, struct, typedef, nullptr, const 
    },emphstyle={\color{blue}\ttfamily},
    columns=fullflexible,keepspaces,
    literate=%
    {Ö}{{\"O}}1
    {Ä}{{\"A}}1
    {Ü}{{\"U}}1
    {ß}{{\ss}}1
    {ü}{{\"u}}1
    {ä}{{\"a}}1
    {ö}{{\"o}}1
    {~}{{\textasciitilde}}1
    {\# if}{{{{{\textcolor{red!60!blue}{\#if}}}}}}1
    {\# ifdef}{{{{{\textcolor{red!60!blue}{\#ifdef}}}}}}1
    {\# ifndef}{{{{{\textcolor{red!60!blue}{\#ifndef}}}}}}1,
}

%% ----------------- define für Leerseiten bei Doppelseitigem-Druck --------------- %%
% 1 akitv, nicht 1 inaktiv
%\def\emptyprintpages{1}
\def\emptyprintpages{0}

\def\blankpage{
      \clearpage
      \thispagestyle{empty}
      \addtocounter{page}{-1}
      \null
      \clearpage}

\begin{document}

\frontmatter

%%================ Titelseite ==========================%%
\maketitle
% Verantwortliche/Verfasser
\responsible{Stefan Deimel, Philipp Eilmsteiner, Julia Stöger}
%%======================================================%%

\if\emptyprintpages1
\blankpage
\fi

%%================ Eidesstattliche Erklaerung ==========%%
\begin{Eid}%Unterschrift der Diplomanden hinzufuegen!
\unterschrift{Stefan Deimel}
\unterschrift{Philipp Eilmsteiner}
\unterschrift{Julia Stöger}
\end{Eid}\newpage
%%======================================================%%
\def\chapterpagestyle{headings} 
\responsible{Stefan Deimel, Philipp Eilmsteiner, Julia Stöger}
\if\emptyprintpages1
\blankpage
\fi
\chapter*{Gendererklärung}
Aus Gründen der besseren Lesbarkeit wird in dieser Diplomarbeit die Sprachform des generischen Maskulinums angewendet. Es wird an dieser Stelle darauf hingewiesen, dass die ausschließliche Verwendung der männlichen Form geschlechtsunabhängig verstanden werden soll.
\newpage
\if\emptyprintpages1
\blankpage
\fi

%%================ Diplomandenvorstellung ==============%%
\input{Textparts/diplomanden.tex}
%%======================================================%%
\responsible{Stefan Deimel}
\if\emptyprintpages1
\blankpage
\fi

%%================ Danksagungen ========================%%
\input{Textparts/danksagungen.tex}
%%======================================================%%
\if\emptyprintpages1
\blankpage
\fi
%% Kurzfassungen
\includepdf[pages={1-2}, scale=1]{Kurzfassungen/De.pdf}
\includepdf[pages={1-2}, scale=1]{Kurzfassungen/En.pdf}

%%================ Abstract /Zusammenfass. =============%%
\input{Textparts/abstract.tex}
\input{Textparts/zusammenfassung.tex}
%%======================================================%%

%%================ Inhaltsverzeichnis ==================%%
\def\chapterpagestyle{headings} 
\responsible{Stefan Deimel, Philipp Eilmsteiner, Julia Stöger}
\if\emptyprintpages1
\blankpage
\fi
\tableofcontents
%%======================================================%%

\if\emptyprintpages1
\blankpage
\fi
%Ab hier Hauptteil
\mainmatter
\chapter{Themenvorstellung}
\subimport{Textparts/Stoeger/Einfuehrung/}{Einfuehrung.tex}

\if\emptyprintpages1
\blankpage
\fi
\chapter{Funktionsprinzip}
\responsible{Julia Stöger}
\subimport{Textparts/Stoeger/Einfuehrung/}{Funktionsprinzip.tex}

\if\emptyprintpages1
\blankpage
\fi
\chapter{Erster Prototyp}
\responsible{Stefan Deimel}
\subimport{Textparts/Deimel/ErsterPrototyp/}{ErsterPrototyp.tex}

\if\emptyprintpages1
\blankpage
\fi
\chapter{Konstruktion}
\responsible{Stefan Deimel}
\subimport{Textparts/Deimel/Konstruktion/}{Konstruktion.tex}

\if\emptyprintpages1
\blankpage
\fi
\chapter{Leistungselektronik}
\responsible{Philipp Eilmsteiner}
\subimport{Textparts/Eilmsteiner/Leistungselektronik}{LE_Motoren.tex}
\responsible{Stefan Deimel}
\subimport{Textparts/Deimel/Leistungselektronik}{Leistungselektronik.tex}
\responsible{Philipp Eilmsteiner}
\subimport{Textparts/Eilmsteiner/Leistungselektronik}{LE_Relais_Bucks_Akkus.tex}
\responsible{Julia Stöger}
\subimport{Textparts/Stoeger/Batteriemanagement/}{Batteriemanagement.tex}
\responsible{Philipp Eilmsteiner}
\subimport{Textparts/Eilmsteiner/Leistungselektronik}{Leistungselektronik_Stueckliste.tex}

\if\emptyprintpages1
\blankpage
\fi
\chapter{Boardelektronik\label{sec:Boardelektronik}}
\responsible{Philipp Eilmsteiner}
\subimport{Textparts/Eilmsteiner/Boardelektronik}{Einfuehrung.tex}
\subimport{Textparts/Eilmsteiner/Boardelektronik}{Installation_Software.tex}
\subimport{Textparts/Eilmsteiner/Boardelektronik}{Platinen.tex}
\subimport{Textparts/Eilmsteiner/Boardelektronik}{HMI.tex}
\subimport{Textparts/Eilmsteiner/Boardelektronik/}{Boardelektronik_Stueckliste.tex}

\chapter{Sicherheitskonzept}
\responsible{Julia Stöger}
\subimport{Textparts/Stoeger/Sicherheitskonzept}{Sicherheitskonzept.tex}

\if\emptyprintpages1
\blankpage
\fi
\chapter{Kostenrechnung}
\responsible{Stefan Deimel, Julia Stöger}
\subimport{Textparts/}{Kostenrechnung.tex}

\chapter{Anleitungen}
\section{Betriebsanleitung}
\responsible{Julia Stöger}
\subimport{Textparts/Stoeger/Anleitung/}{Anleitung.tex}
\subimport{Textparts/Stoeger/Anleitung/}{Anleitung_Laden.tex}

\chapter{Besprechungsprotokolle \&\ Meilensteine}
\responsible{Julia Stöger}
\section{Besprechungsprotokolle}
\subimport{Textparts/Stoeger/Meilensteine/}{Besprechungsprotokoll.tex}
\section{Meilensteine}
\subimport{Textparts/Stoeger/Meilensteine/}{Meilensteine.tex}

\chapter{Zeitaufzeichnung}
\responsible{Stefan Deimel}
\subimport{Textparts/Deimel/Zeit/}{Zeit.tex}

\chapter{Anhang}
\responsible{Philipp Eilmsteiner}
\subimport{Textparts/Eilmsteiner/Anhang/}{arduino_bibliotheken.tex}
\subimport{Textparts/Eilmsteiner/Anhang/}{Datenblaetter.tex}

\clearpage
\appendix
%\def\chapterpagestyle{empty} 

\responsible{Stefan Deimel, Philipp Eilmsteiner, Julia Stöger}
\if\emptyprintpages1
\blankpage
\fi
%%================ Abkuerzungsverzeichnis ==============%%
\input{Textparts/abkuerzungen.tex}
%%======================================================%%

\if\emptyprintpages1
\blankpage
\fi
%%================ Abbildungsverzeichnis ===============%%
\setcounter{lofdepth}{2}
\dipalistoffigures
%%======================================================%%

%%================ Tabellenverzeichnis  ================%%
\setcounter{lotdepth}{2}
\dipalistoftables
%%======================================================%%

\if\emptyprintpages1
\blankpage
\fi
%%================ Literaturverzeichnis ================%%
\newpage
\input{Textparts/literatur.tex}

%%======================================================%%
\end{document}
