StefanD2/Diplomarbeit_Hovercraft/Doku/Textparts/Eilmsteiner/Boardelektronik/HMI.tex

\section{Bildschirm}
Bei dem verwendeten Bildschirm handelt es sich um einen 5 Zoll großen Touchscreen aus dem Hause Nextion.
Dieser bietet den großen Vorteil, die graphische Darstellung bequem über das verfügbare Gratis-Tool (\textbf{Nextion Editor}) designen zu können, während der Arduino den Bildschirm nur mit den nötigen Daten über eine serielle Verbindung versorgen muss. 

\begin{figure}[h]
    \centering
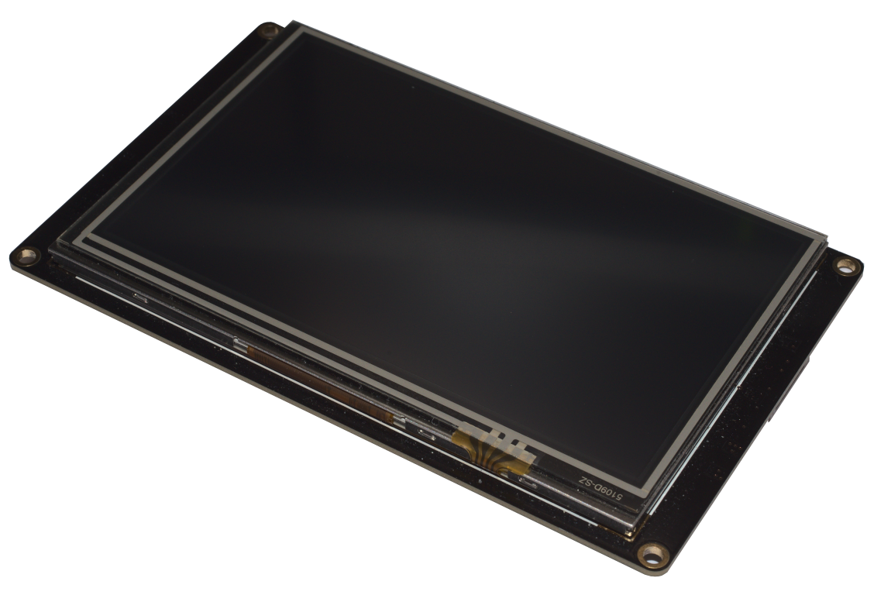
[picture p39: Doku/Fotos/Nextion_Display.png]
    
    \caption{Nextion-Display}
\end{figure}

\newpage
\subsection{Installation des Nextion-Editors}
\href{https://nextion.tech/nextion-editor/}{Nextion Editor Webseite}\\
Das Programm kann entweder per heruntergeladener \textit{.exe}-Datei installiert werden oder nach dem Entpacken der ebenfalls vorhandenen \textit{zip}-Datei direkt ausgeführt werden.
\begin{figure}[h]
    \centering
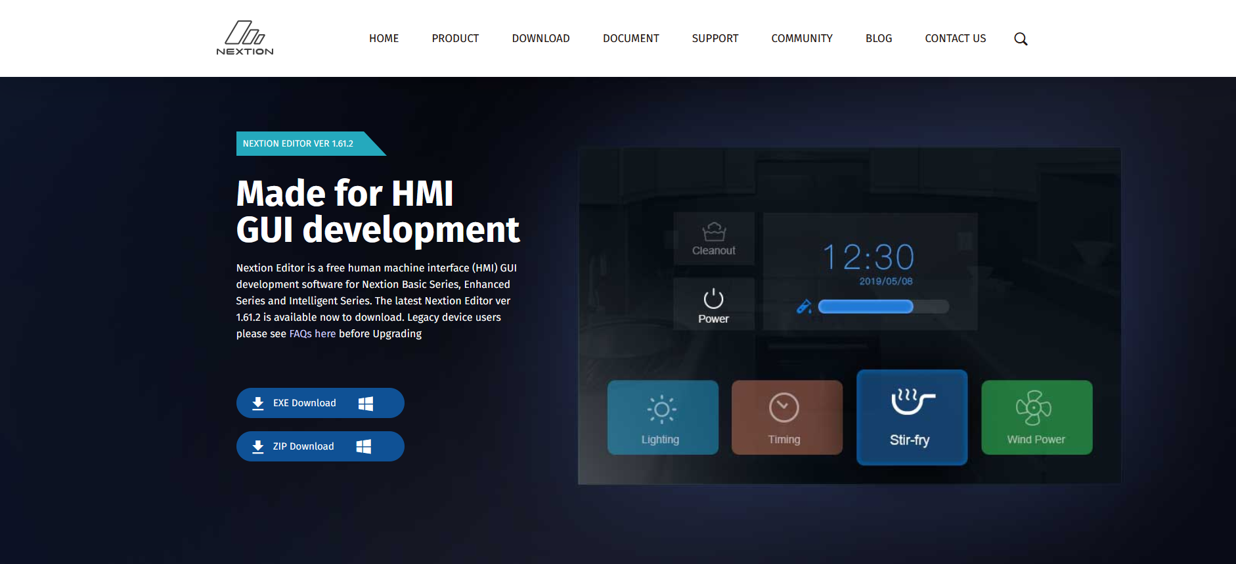
[picture p40: Doku/Textparts/Eilmsteiner/Boardelektronik/bilder/Nextion_Webseite.png]
    
    \caption{Webseite des Nextion Editors}
\end{figure}

\newpage
\subsection{Auswahl des richtigen Bildschirmes}
\begin{figure}[h]
    \centering
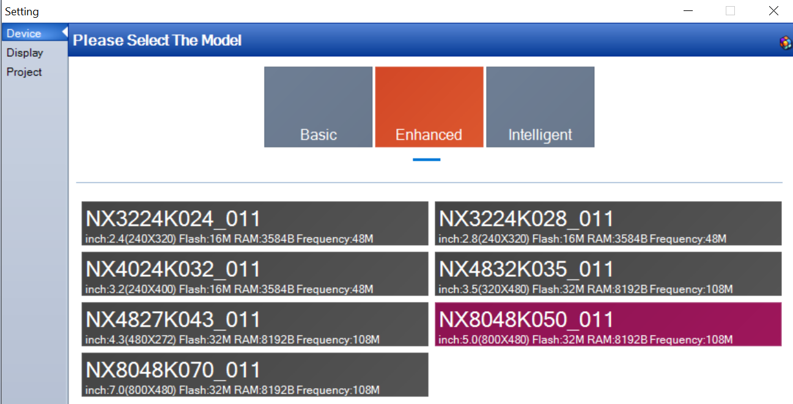
[picture p41: Doku/Textparts/Eilmsteiner/Boardelektronik/bilder/nextion_editor/Settings_Device.png]
    
    \caption{Auswahl des richtigen Bildschirmes im Nextion Editor}
\end{figure}

\begin{figure}[h]
    \centering
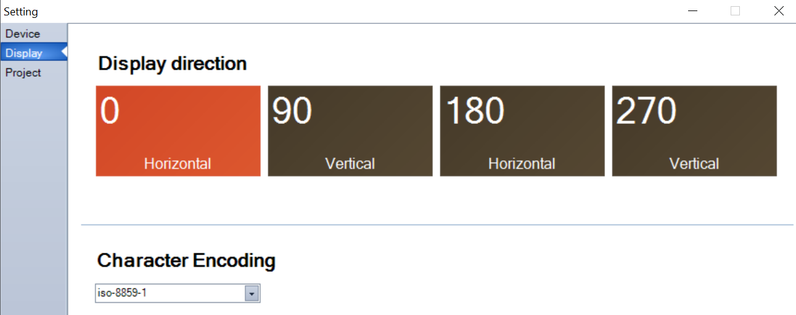
[picture p42: Doku/Textparts/Eilmsteiner/Boardelektronik/bilder/nextion_editor/Settings_Display.png]
    
    \caption{Auswahl der richtigen Bildschirmausrichtung im Nextion Editor}
\end{figure}

\newpage
\subsection{Entworfene Oberfläche}
\subsubsection{Hauptseite}
Diese Seite zeigt die Telemetriedaten der beiden Regler, sowie die derzeitige vom GPS berechnete Geschwindigkeit an.
\begin{figure}[h]
    \centering
    %\includegraphics[width=\textwidth]{bilder/nextion_editor/main_screen.png}
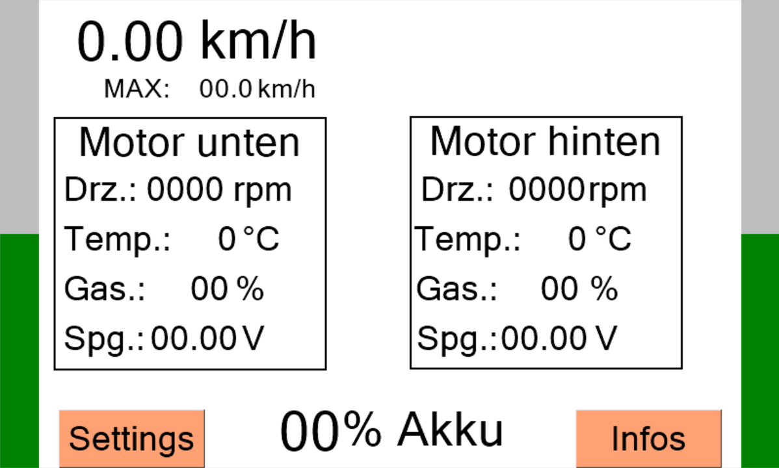
[picture p43: Doku/Textparts/Eilmsteiner/Boardelektronik/bilder/nextion_editor/main_screen.png]
    \tcbox{}
    \caption{Hauptseite der Bedienoberfläche}
\end{figure}
\newpage

\subsubsection{Einstellungen}
Während man mit dem ersten Slider auf dieser Seite den Nullpunkt der Lenkung einstellen kann, 
dienen die beiden unteren Schieberegler zur Begrenzung der maximal verfügbaren Leistung der beiden Motoren.
\begin{figure}[h]
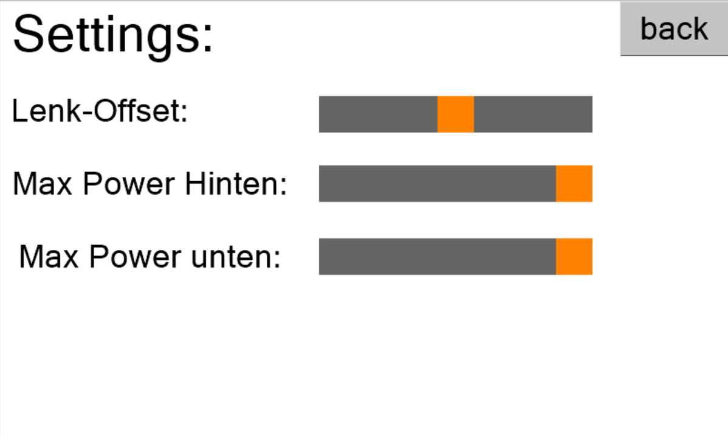
[picture p44: Doku/Textparts/Eilmsteiner/Boardelektronik/bilder/nextion_editor/settings_screen.png]
    \tcbox{}
    \caption{Einstellungsseite der Bedienoberfläche}
\end{figure}
\newpage

\subsubsection{Informationen}
Diese Seite zeigt sowohl die Akkutemperaturen als auch einige wichtige Informationen über das GPS-Modul an.
\begin{figure}[h]
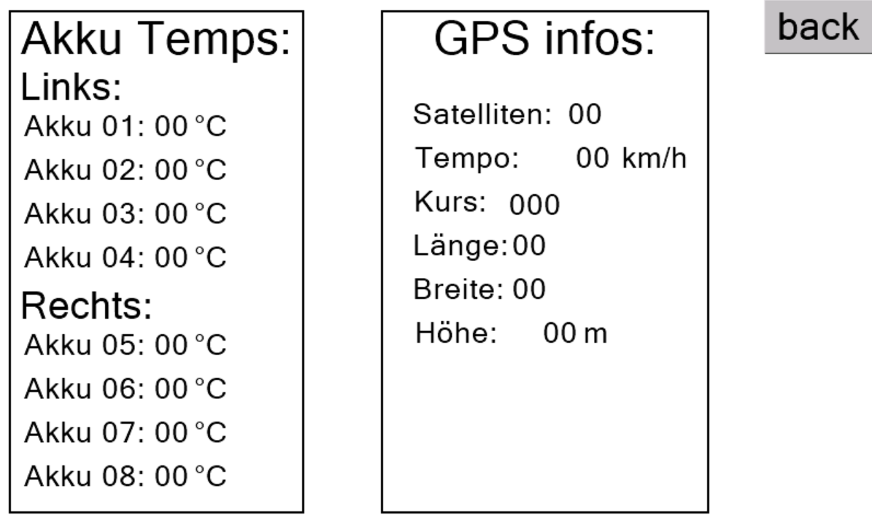
[picture p45: Doku/Textparts/Eilmsteiner/Boardelektronik/bilder/nextion_editor/infos_screen.png]
    \tcbox{}
    \caption{Infoseite der Bedienoberfläche}
\end{figure}
\newpage
