StefanD2/Diplomarbeit_Hovercraft/Doku/Textparts/Stoeger/Meilensteine/Besprechungsprotokoll.tex

\begin{tabular}[h]{|M{.25\textwidth}|M{.16\textwidth}|c|M{.37\textwidth}|}
    \hline
    \textbf{Anwesende Schüler} & \textbf{Anwesender Betreuer} & \textbf{Datum}  & \textbf{Inhalt} \\
    \hline
    Deimel, Eilmsteiner, Stöger & Prof. Frank & 28.02.2020 & Organisation der Diplomarbeit \\
    \hline
    Deimel, Eilmsteiner, Stöger & Prof. Frank & 12.03.2020 & Besprechung betreffend Sponsoring \\
    \hline
    Deimel, Eilmsteiner, Stöger & Prof. Frank & 18.06.2020 & Besprechung der Leistungselektronik \\
    \hline
    Deimel, Eilmsteiner, Stöger & Prof. Frank & 29.07.2020 & Festlegung der Meilensteine \\
    \hline
    Deimel, Eilmsteiner, Stöger & Prof. Frank & 23.10.2020 & Planung der Konstruktion \\
    \hline
    Deimel, Eilmsteiner, Stöger & Prof. Frank & 10.11.2020 & Planung der Lenkung \\
    \hline 
    Deimel, Eilmsteiner, Stöger & Prof. Frank & 21.11.2020 & Planung der Elektronik \\
    \hline
\end{tabular}
