StefanD2/Diplomarbeit_Hovercraft/Doku/Textparts/Stoeger/Einfuehrung/Einfuehrung.tex

\section{Ausgangslage}
Inspiriert von einem YouTube-Video\textsuperscript{\cite{YoutubeVideo}} soll ein voll funktionstüchtiges Luftkissenboot entwickelt werden, das in der Lage ist, eine erwachsene Person einige Minuten lang zu befördern. Als Antriebe sollen zwei Elektromotoren eingesetzt werden. Der Aufbau ist als Leichtbaukonstruktion über einem Schlauchboot zu realisieren.

\section{Zielsetzung}
Das Ziel der Diplomarbeit ist es, ein Schlauchboot zu einem Luftkissenboot umzubauen. Das Hovercraft soll mit zwei 10\,kW Elektromotoren mit dazugehörigen Propellern konstruiert werden.\\
Das fertige Luftkissenboot soll in der Lage sein, eine erwachsene Person über Land sowie über Wasser zu transportieren.

\section{Individuelle Themenstellung}
\begin{itemize}
    \item \textbf{Stefan Deimel:}
    \begin{itemize}
      \item Konstruktion
      \item Motorregelung
    \end{itemize}
    \item \textbf{Philipp Eilmsteiner:}
    \begin{itemize}
      \item Steuerelektronik
      \item HMI
    \end{itemize}
    \item \textbf{Julia Stöger:}
    \begin{itemize}
      \item Sicherheitskonzept
      \item Ladeelektronik
    \end{itemize}
\end{itemize}
