StefanD2/Diplomarbeit_Hovercraft/Umschlag_Vorlage.docx

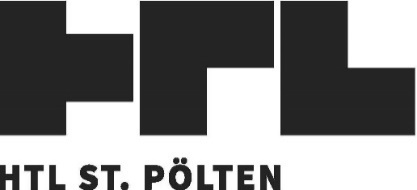
[picture p46: figure]

DIPLOMARBEIT

Elektrotechnik

Stefan Deimel

Philipp Eilmsteiner

Julia Stöger

Vorname Nachname

HOVERCRAFT

5BHET 2020/21
