StefanD2/Diplomarbeit_Hovercraft/Doku/Fotos/Bodenschutz.jpg

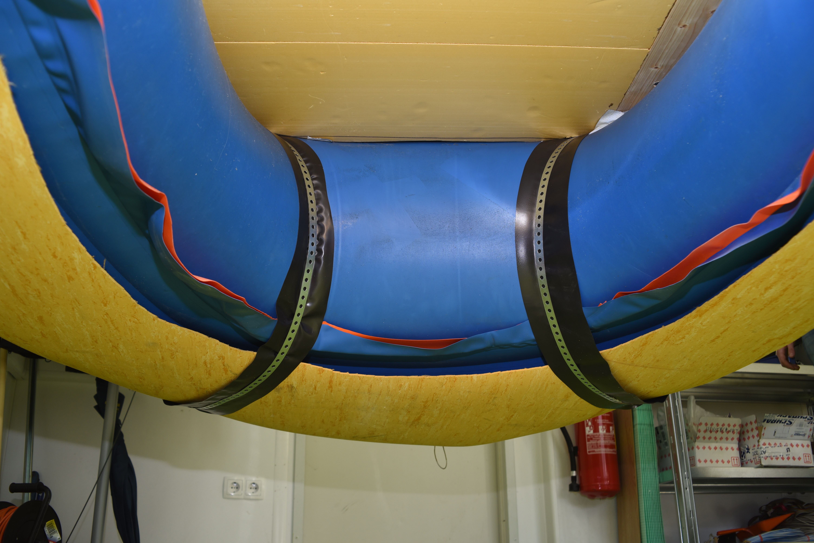
Doku/Fotos/Bodenschutz.jpg
