StefanD2/Diplomarbeit_Hovercraft/Doku/Fotos/Konstruktion/gesamt_1.png

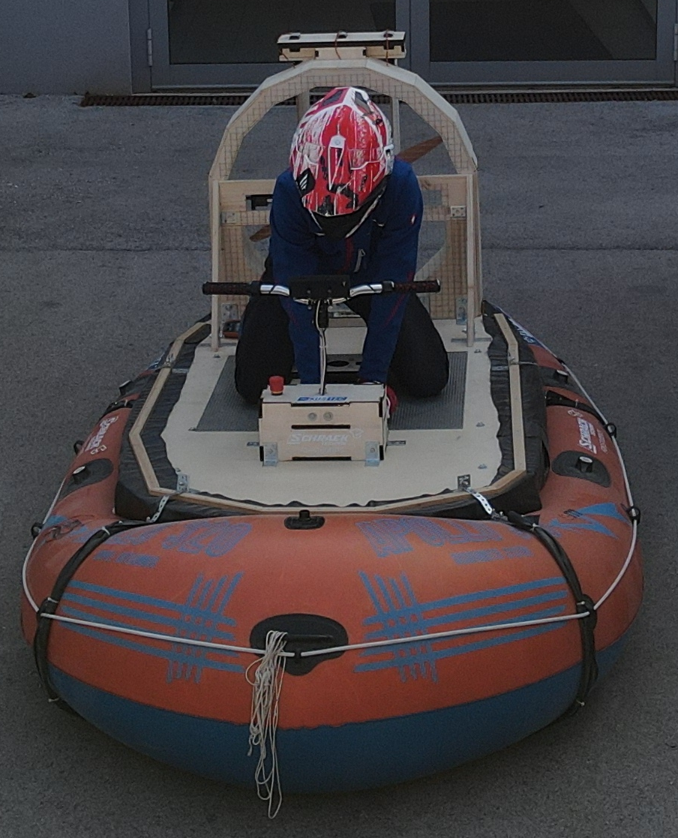
Doku/Fotos/Konstruktion/gesamt_1.png
