StefanD2/Diplomarbeit_Hovercraft/Doku/Fotos/Konstruktion/gesamt_2.png

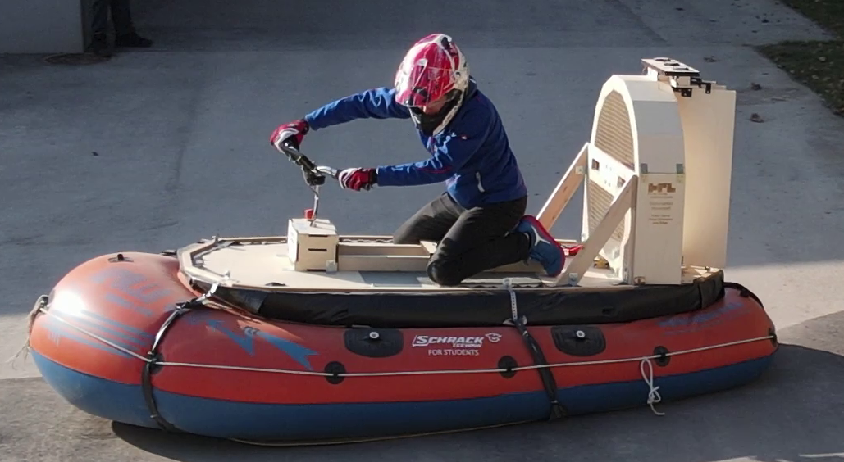
Doku/Fotos/Konstruktion/gesamt_2.png
