StefanD2/Diplomarbeit_Hovercraft/Doku/Fotos/MasterSpin.png

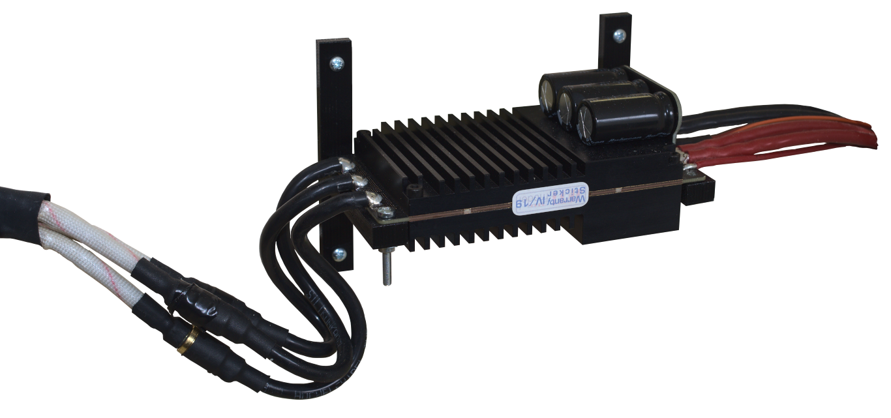
Doku/Fotos/MasterSpin.png
