StefanD2/Diplomarbeit_Hovercraft/Doku/Fotos/SSR.png

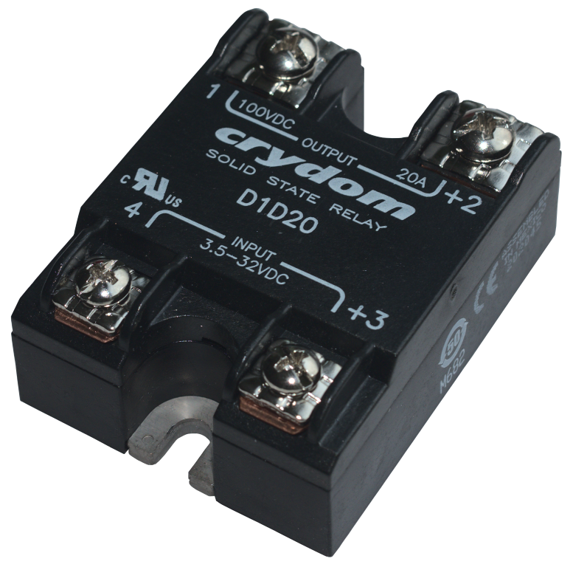
Doku/Fotos/SSR.png
