StefanD2/Diplomarbeit_Hovercraft/Doku/Images/Julia_Stoeger_Bild.jpg

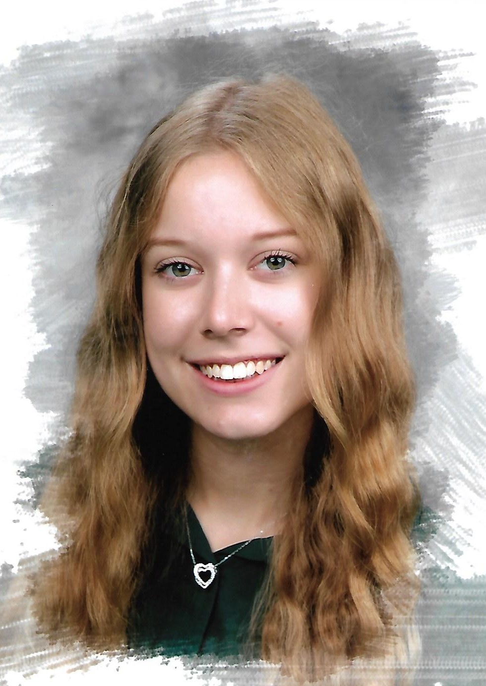
Doku/Images/Julia_Stoeger_Bild.jpg
