StefanD2/Diplomarbeit_Hovercraft/Inventor/Bodenplatte/png/Bodenplatte_Praesentation_Hauptansicht.png

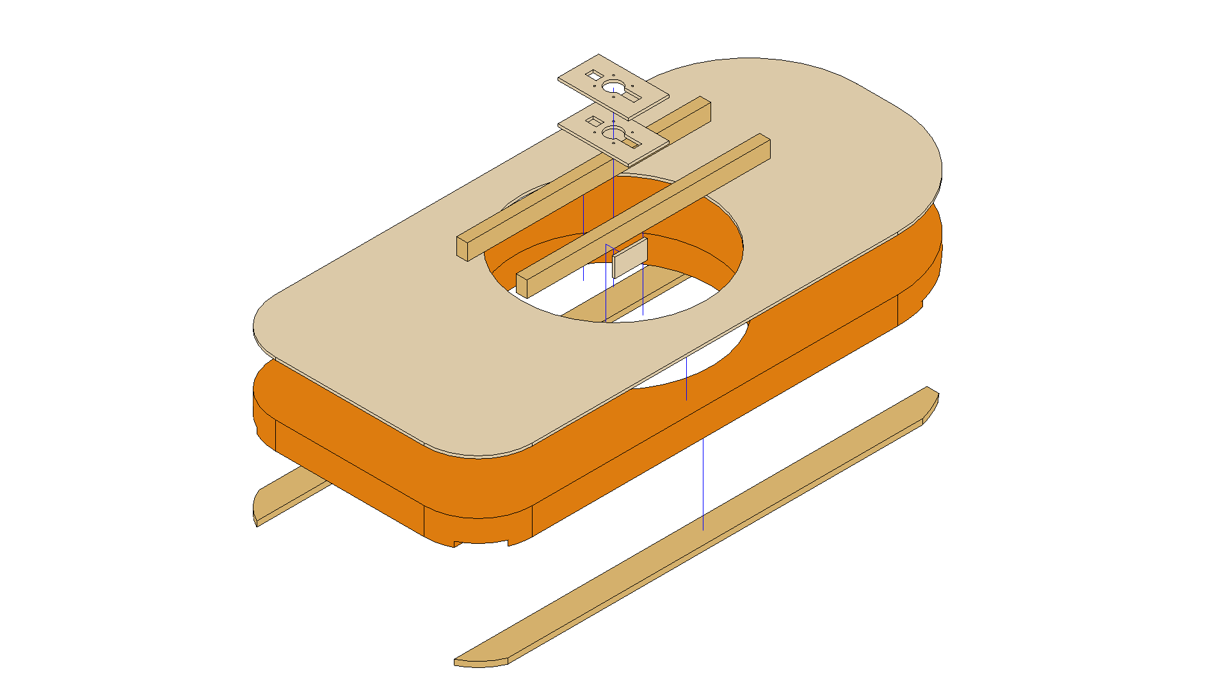
Inventor/Bodenplatte/png/Bodenplatte_Praesentation_Hauptansicht.png
