StefanD2/Diplomarbeit_Hovercraft/Inventor/Bodenplatte/png/Bodenplatte_Praesentation_SeitlichUnten.png

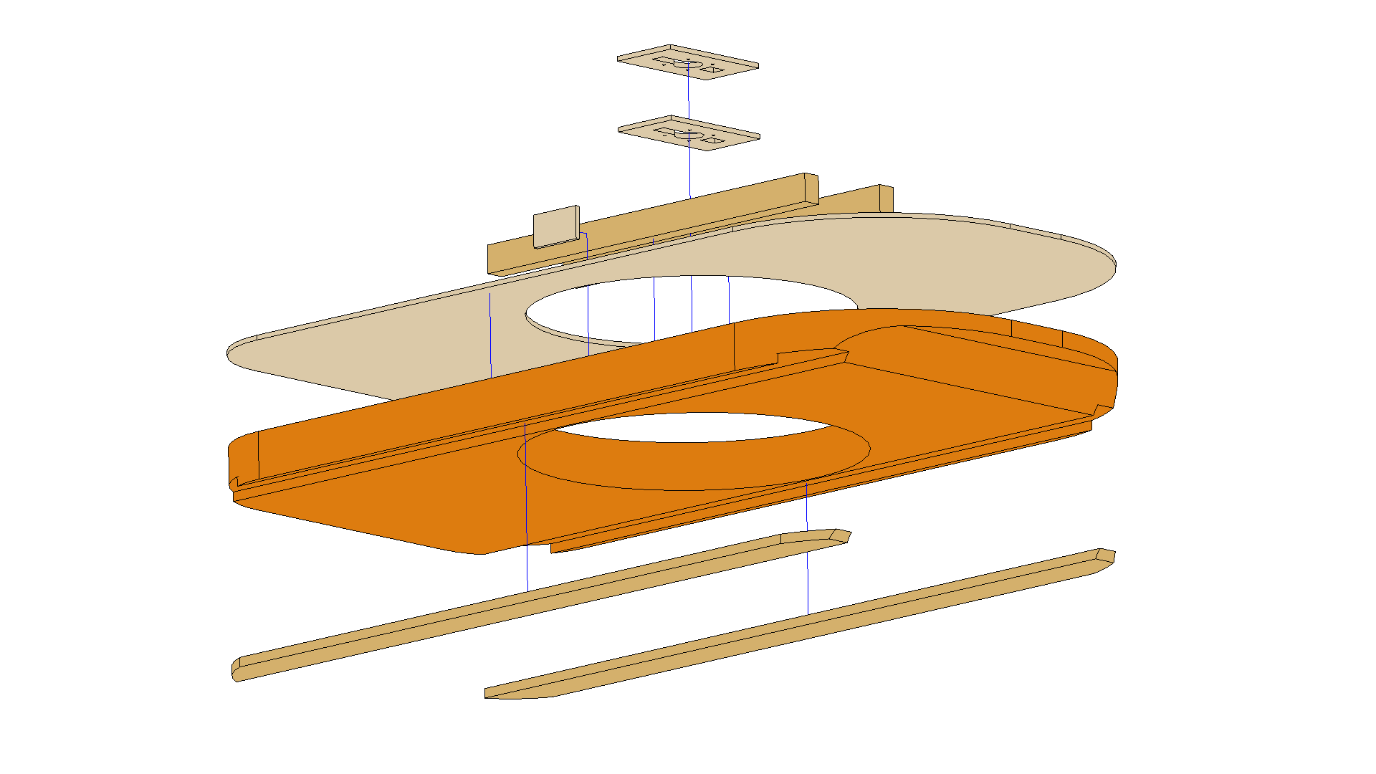
Inventor/Bodenplatte/png/Bodenplatte_Praesentation_SeitlichUnten.png
