StefanD2/Diplomarbeit_Hovercraft/Inventor/Bodenplatte/png/Bodenplatte_seitlich.png

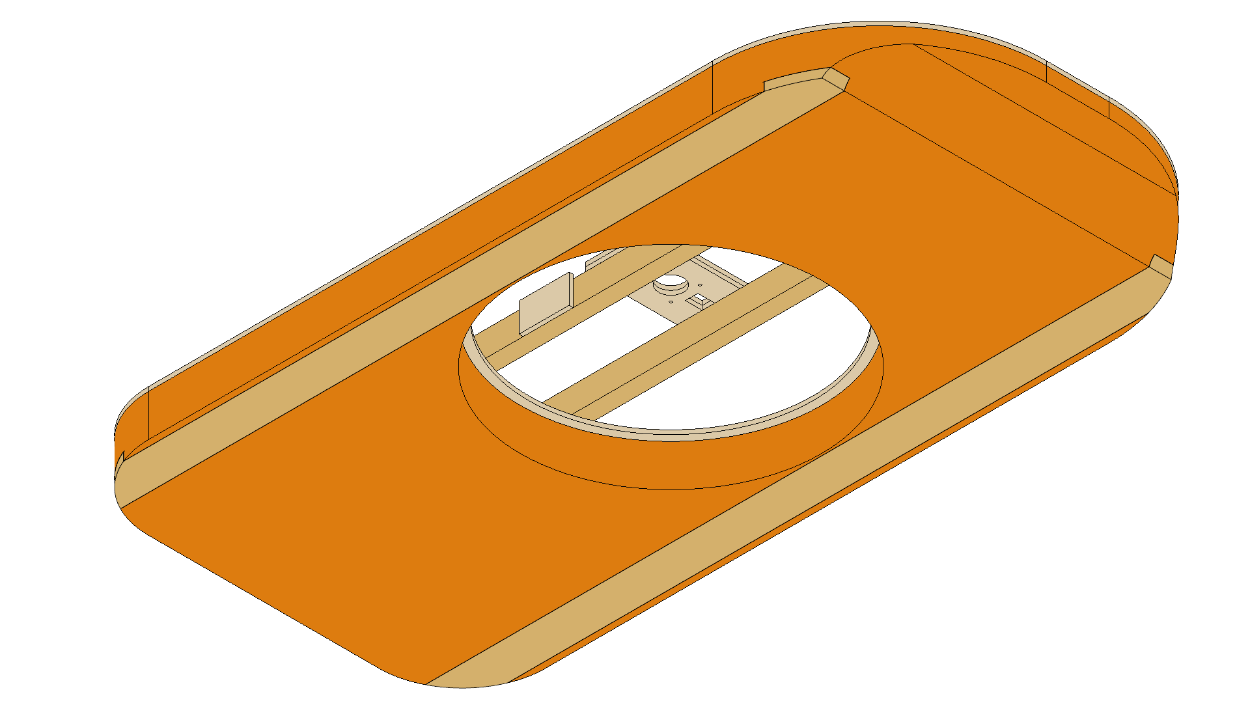
Inventor/Bodenplatte/png/Bodenplatte_seitlich.png
