StefanD2/Diplomarbeit_Hovercraft/Inventor/Bodenplatte/png/Bodenplatte_unten.png

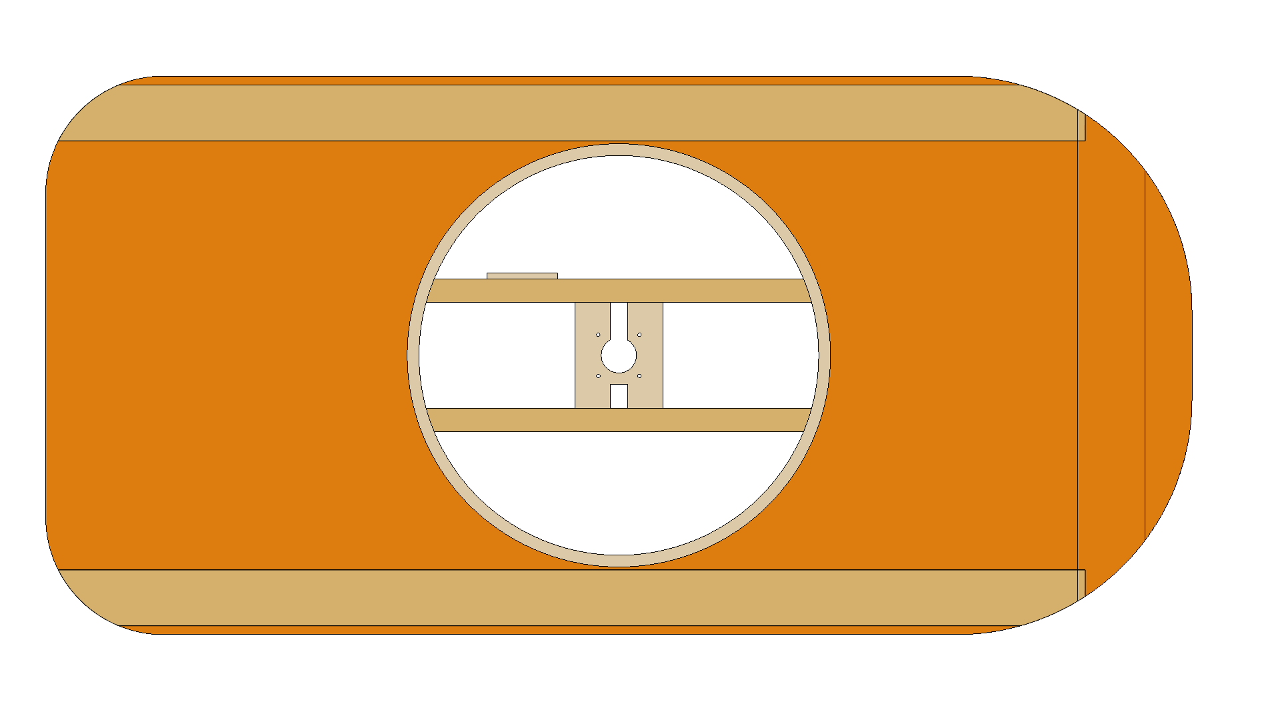
Inventor/Bodenplatte/png/Bodenplatte_unten.png
