StefanD2/Diplomarbeit_Hovercraft/Inventor/Bodenplatte/png/BodenplatteAnsichtUnten.png

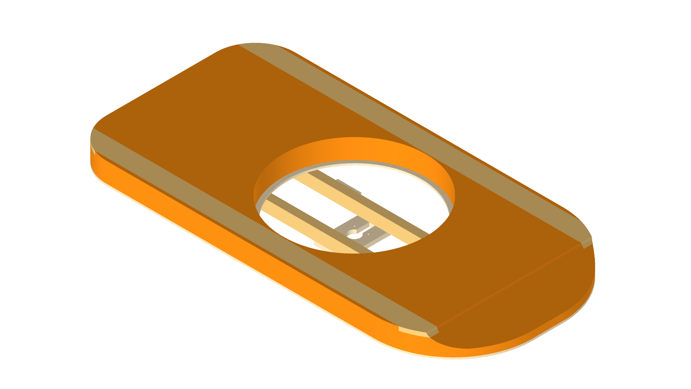
Inventor/Bodenplatte/png/BodenplatteAnsichtUnten.png
