StefanD2/Diplomarbeit_Hovercraft/Inventor/Bodenplatte/png/BodenplatteHauptansicht.png

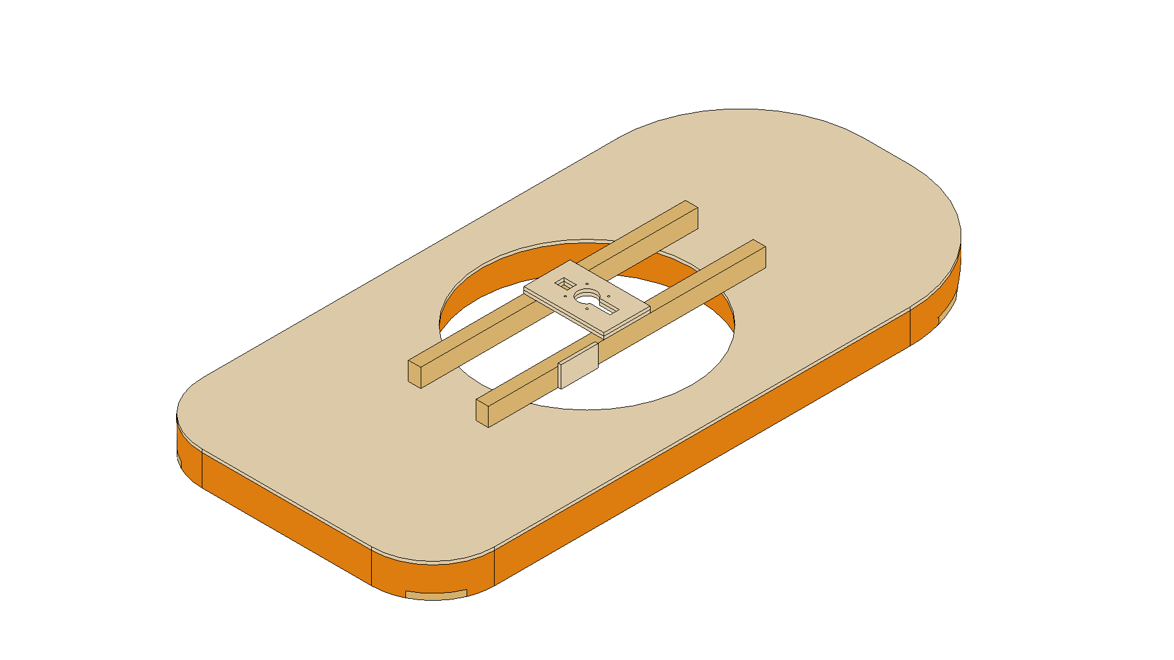
Inventor/Bodenplatte/png/BodenplatteHauptansicht.png
