StefanD2/Diplomarbeit_Hovercraft/Inventor/Bodenplatte/png/Einzelteile/40x60Staffel.png

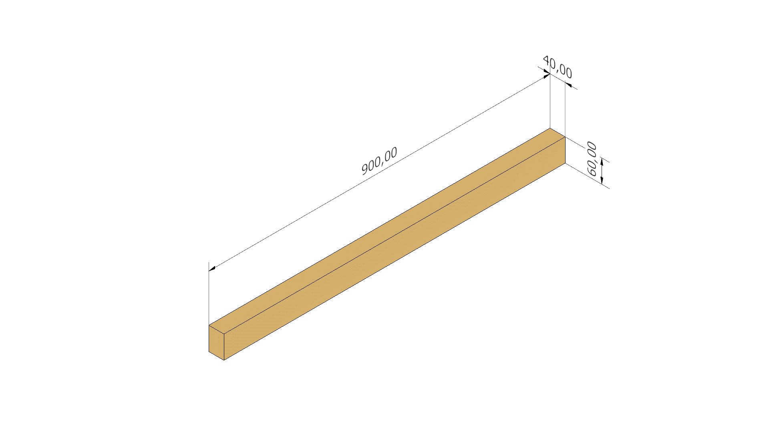
Inventor/Bodenplatte/png/Einzelteile/40x60Staffel.png
