StefanD2/Diplomarbeit_Hovercraft/Inventor/Bodenplatte/png/Einzelteile/Bodenplatte-Holz.png

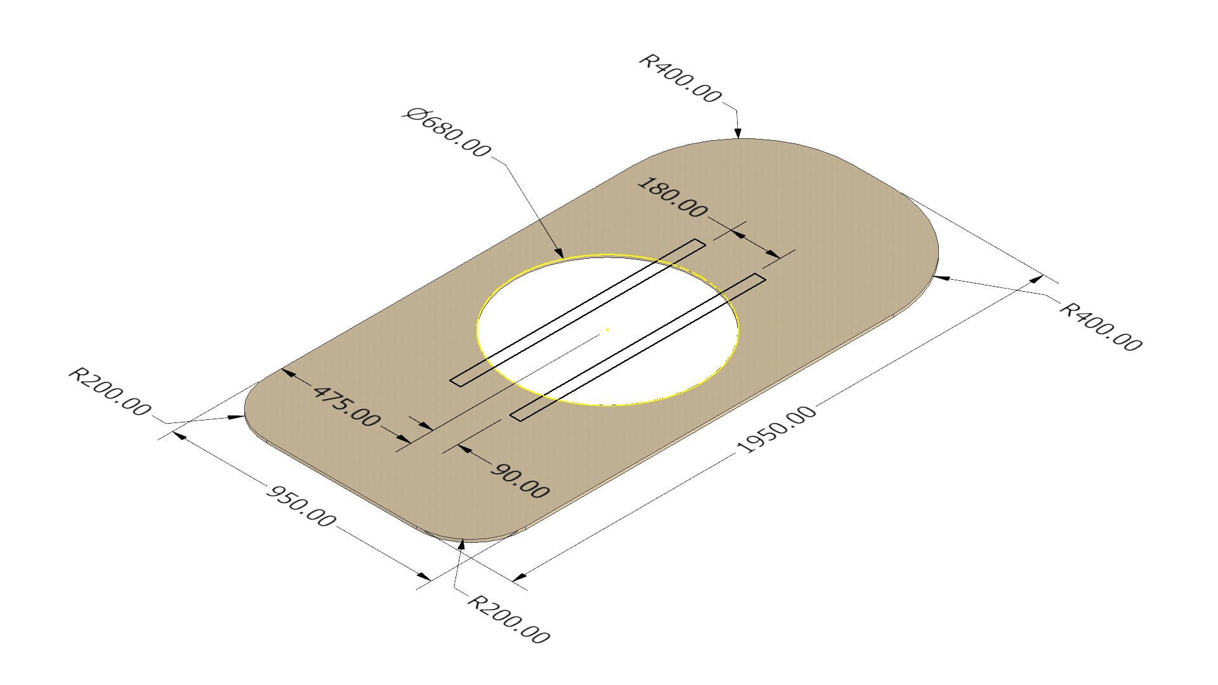
Inventor/Bodenplatte/png/Einzelteile/Bodenplatte-Holz.png
