StefanD2/Diplomarbeit_Hovercraft/Inventor/Bodenplatte/png/Einzelteile/HolzLatteLinks.png

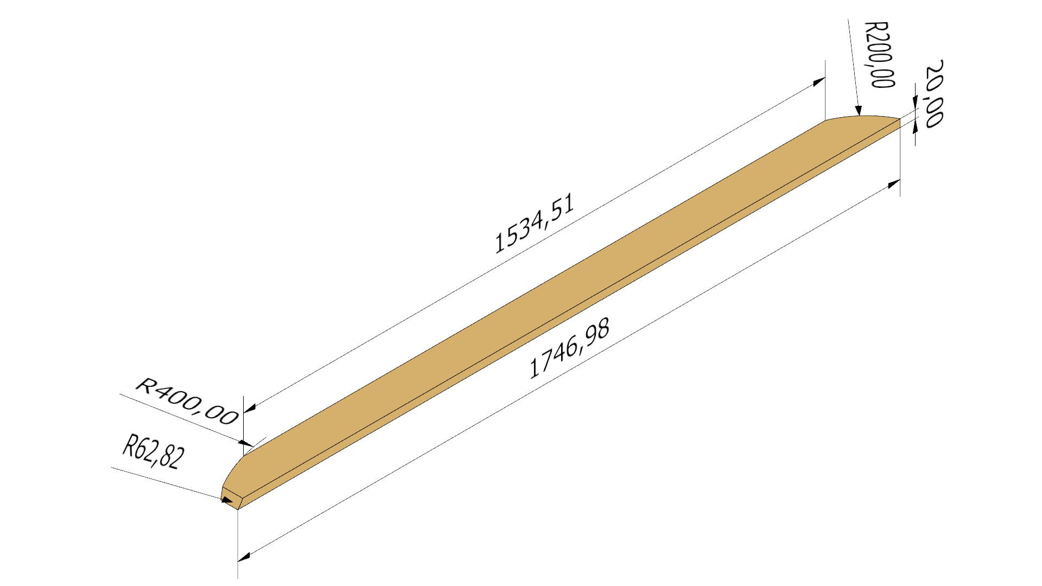
Inventor/Bodenplatte/png/Einzelteile/HolzLatteLinks.png
