StefanD2/Diplomarbeit_Hovercraft/Inventor/Bodenplatte/png/Einzelteile/HolzPlatterechts.png

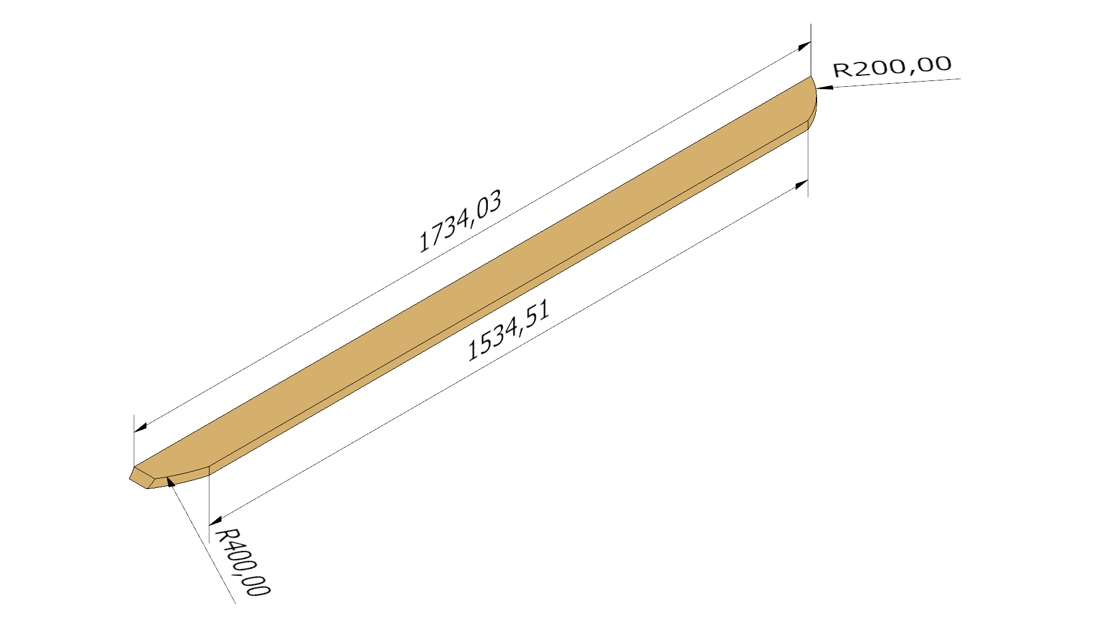
Inventor/Bodenplatte/png/Einzelteile/HolzPlatterechts.png
