StefanD2/Diplomarbeit_Hovercraft/Inventor/Bodenplatte/png/Einzelteile/MotorHalterung.png

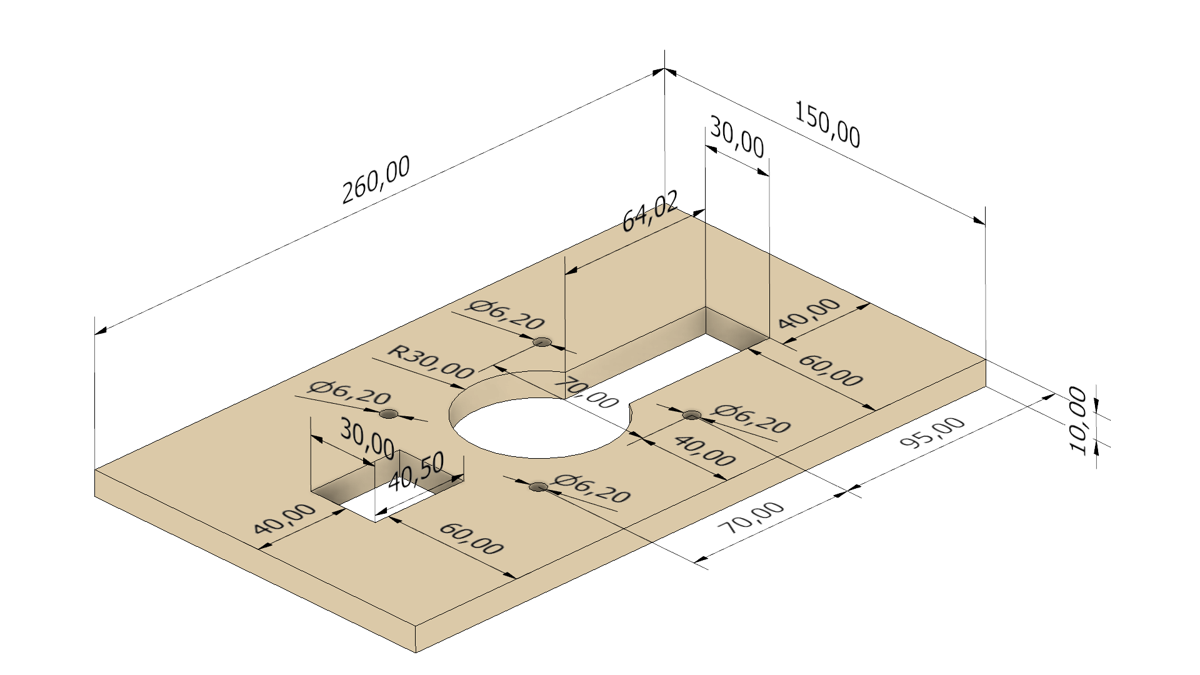
Inventor/Bodenplatte/png/Einzelteile/MotorHalterung.png
