StefanD2/Diplomarbeit_Hovercraft/Inventor/Bodenplatte/png/Einzelteile/XPS_1.png

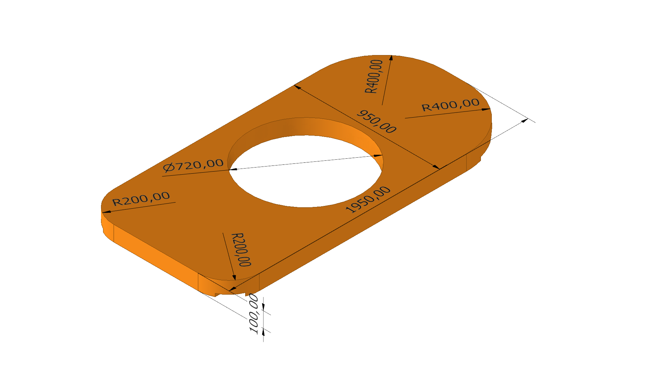
Inventor/Bodenplatte/png/Einzelteile/XPS_1.png
