StefanD2/Diplomarbeit_Hovercraft/Inventor/Bodenplatte/png/Einzelteile/XPS_2.png

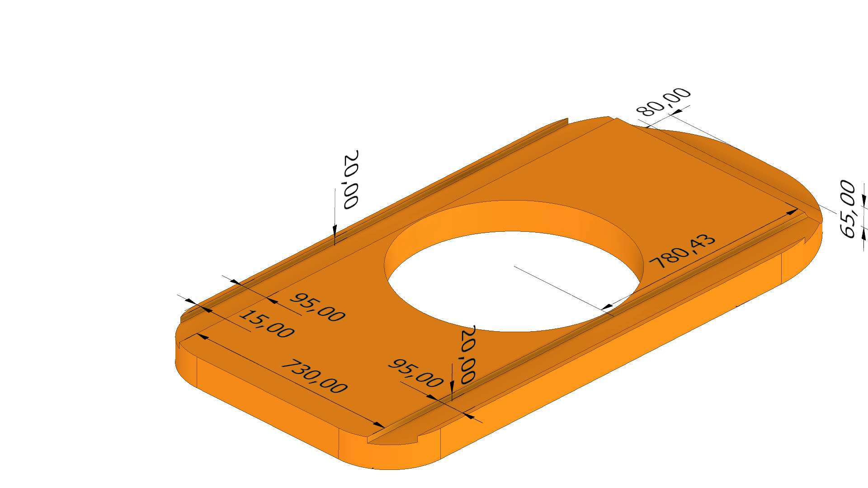
Inventor/Bodenplatte/png/Einzelteile/XPS_2.png
