StefanD2/Diplomarbeit_Hovercraft/Inventor/Lenker/png/Lenkung_Display.png

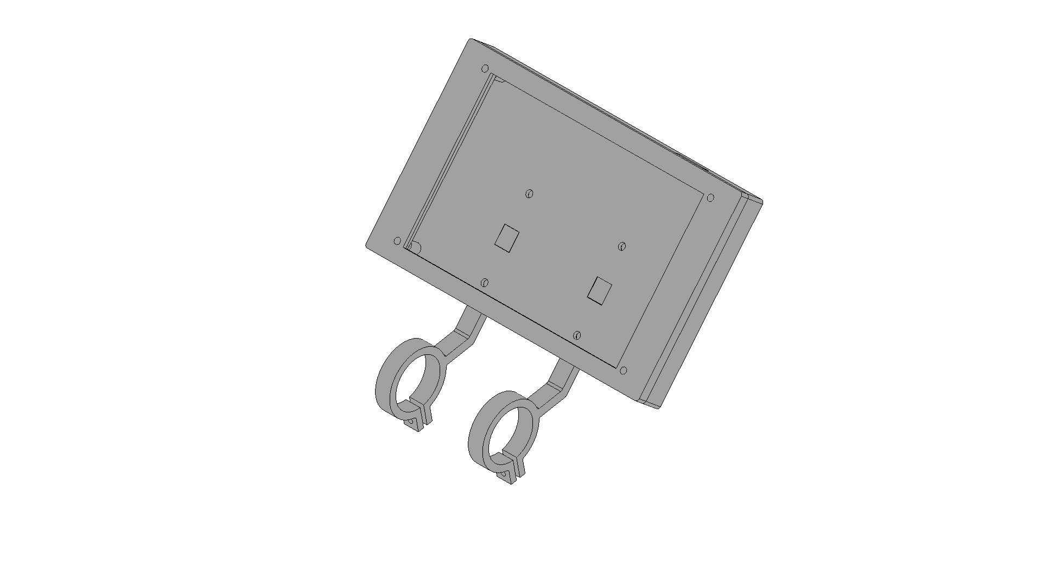
Inventor/Lenker/png/Lenkung_Display.png
