StefanD2/Diplomarbeit_Hovercraft/Inventor/Lenker/png/Lenkung_Hauptansicht.png

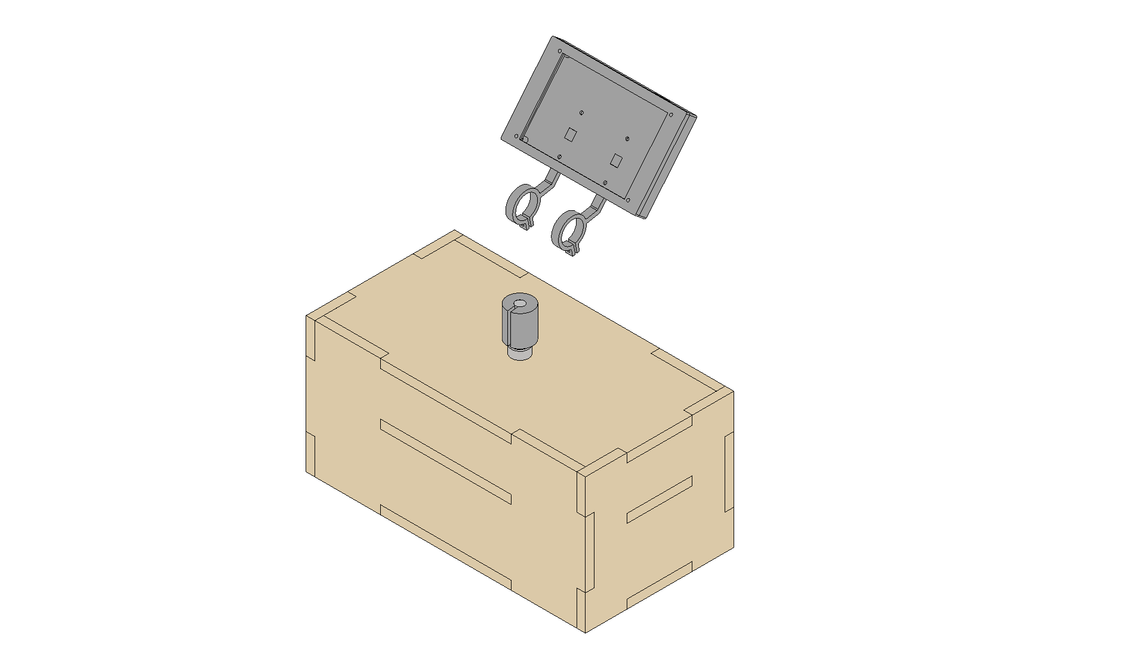
Inventor/Lenker/png/Lenkung_Hauptansicht.png
