StefanD2/Diplomarbeit_Hovercraft/Inventor/Lenker/png/Lenkung_offen.png

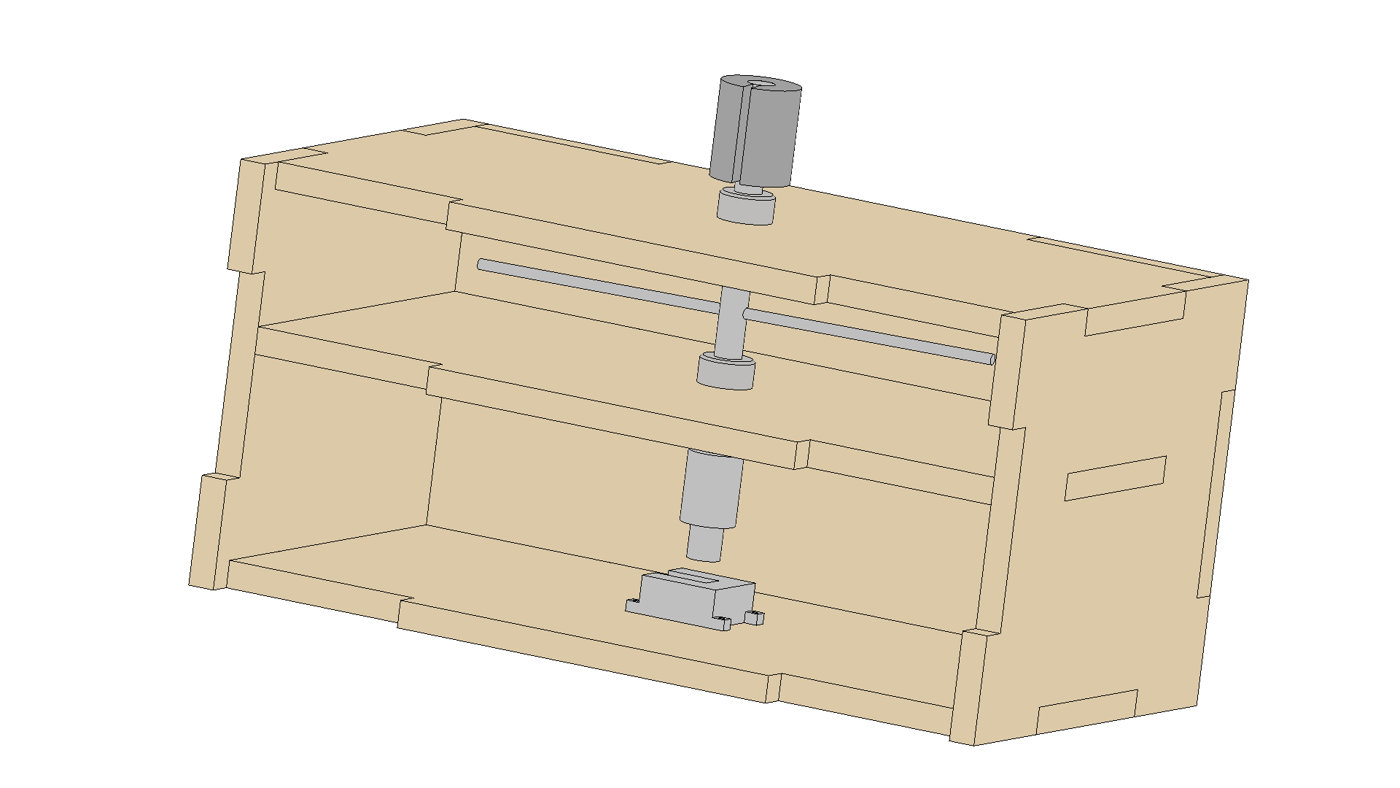
Inventor/Lenker/png/Lenkung_offen.png
