StefanD2/Diplomarbeit_Hovercraft/Inventor/Luftkissenboot.png

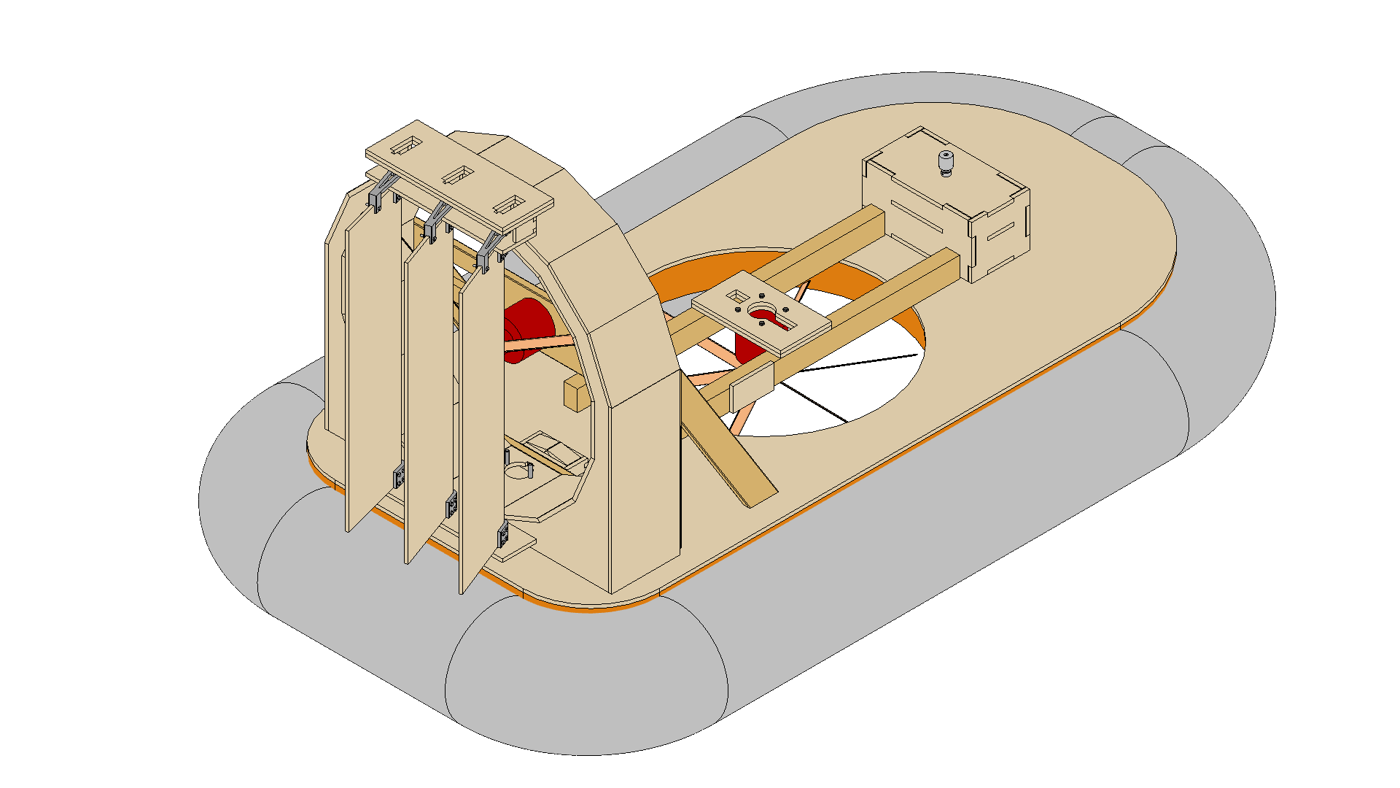
Inventor/Luftkissenboot.png
