StefanD2/Diplomarbeit_Hovercraft/Inventor/PlatinenBilder/Lenkung2.png

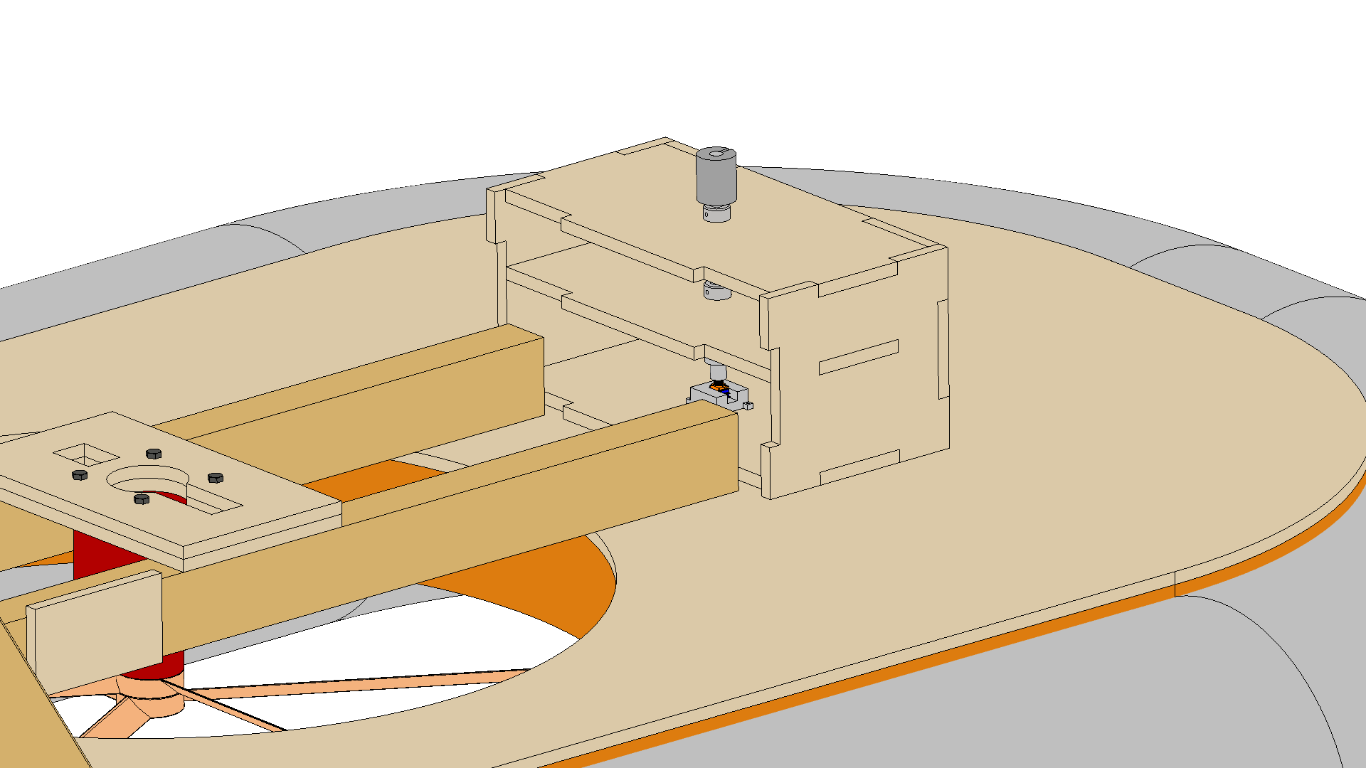
Inventor/PlatinenBilder/Lenkung2.png
