StefanD2/Diplomarbeit_Hovercraft/Inventor/PlatinenBilder/Lenkung.png

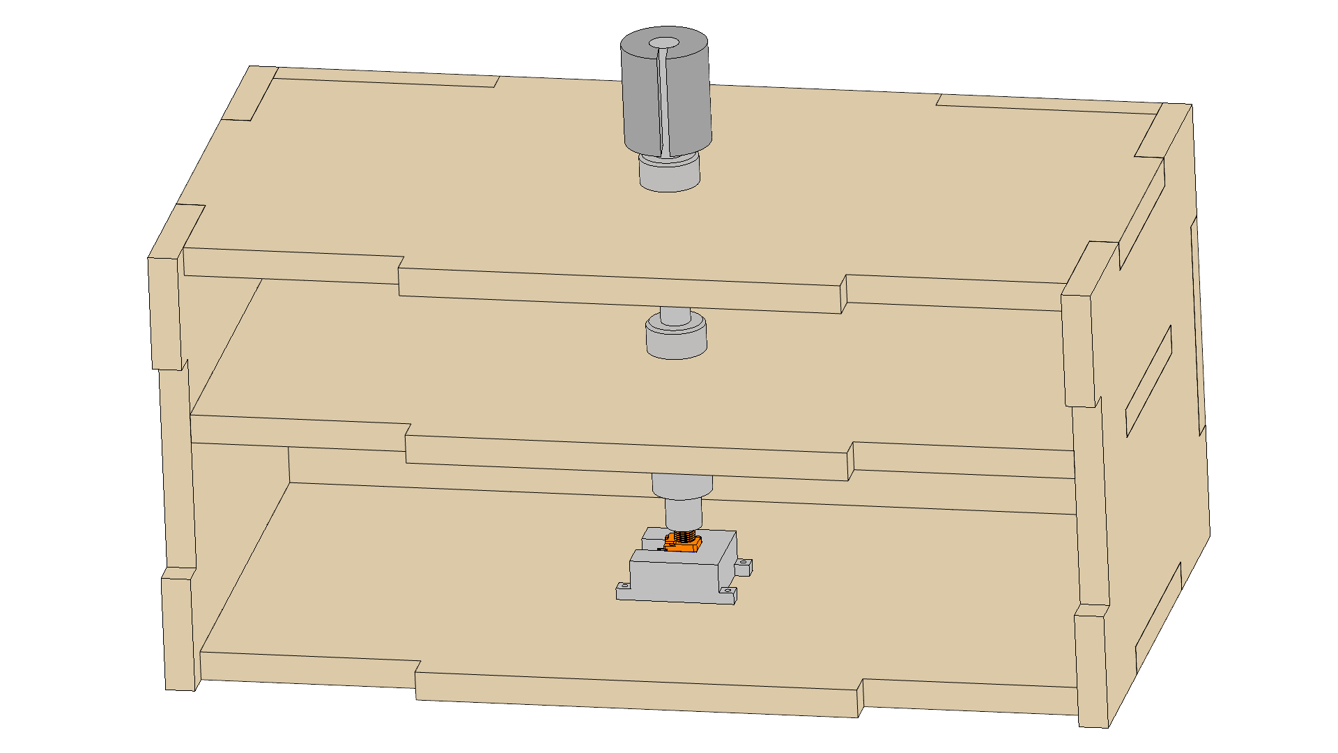
Inventor/PlatinenBilder/Lenkung.png
