StefanD2/Diplomarbeit_Hovercraft/Inventor/PlatinenBilder/ReglerHinten.png

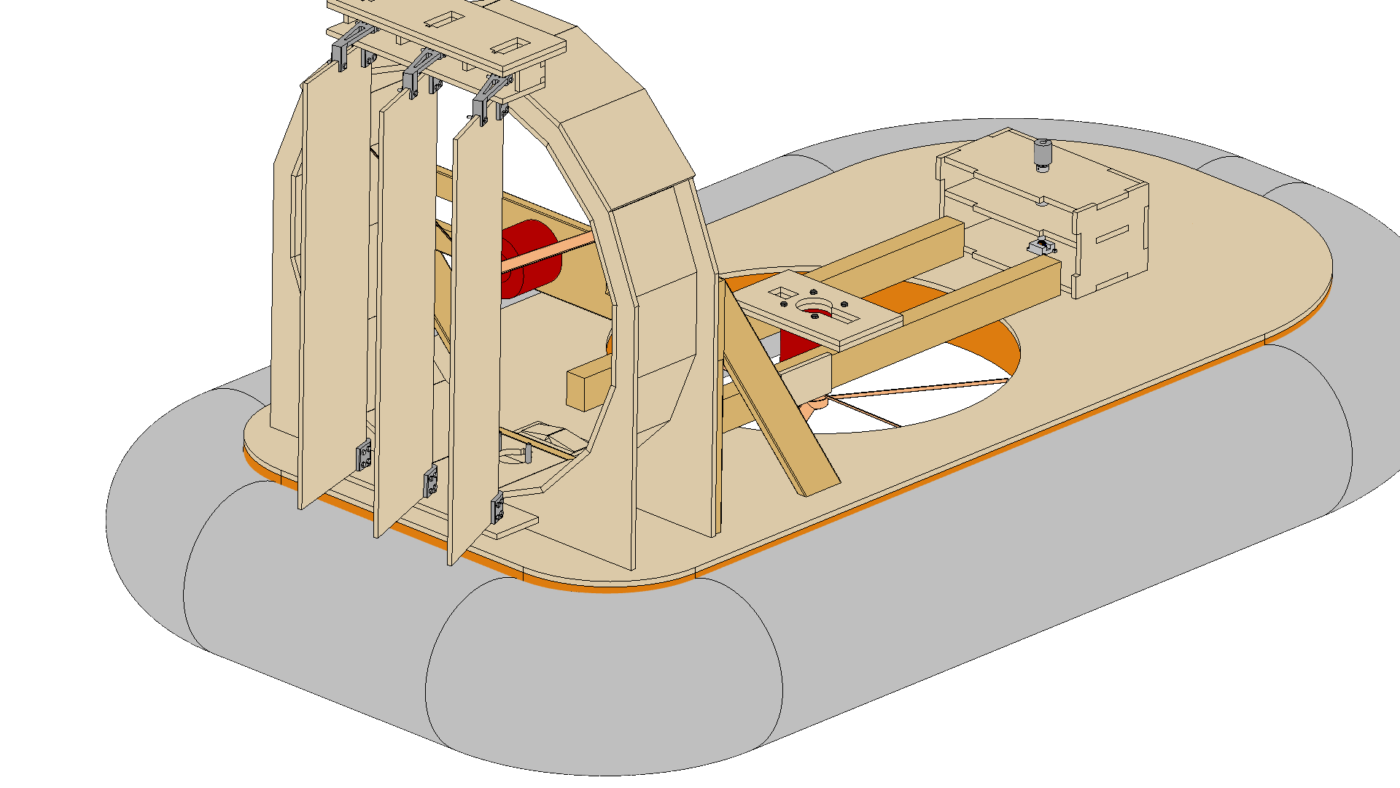
Inventor/PlatinenBilder/ReglerHinten.png
