StefanD2/Diplomarbeit_Hovercraft/Inventor/PlatinenBilder/Seite1.png

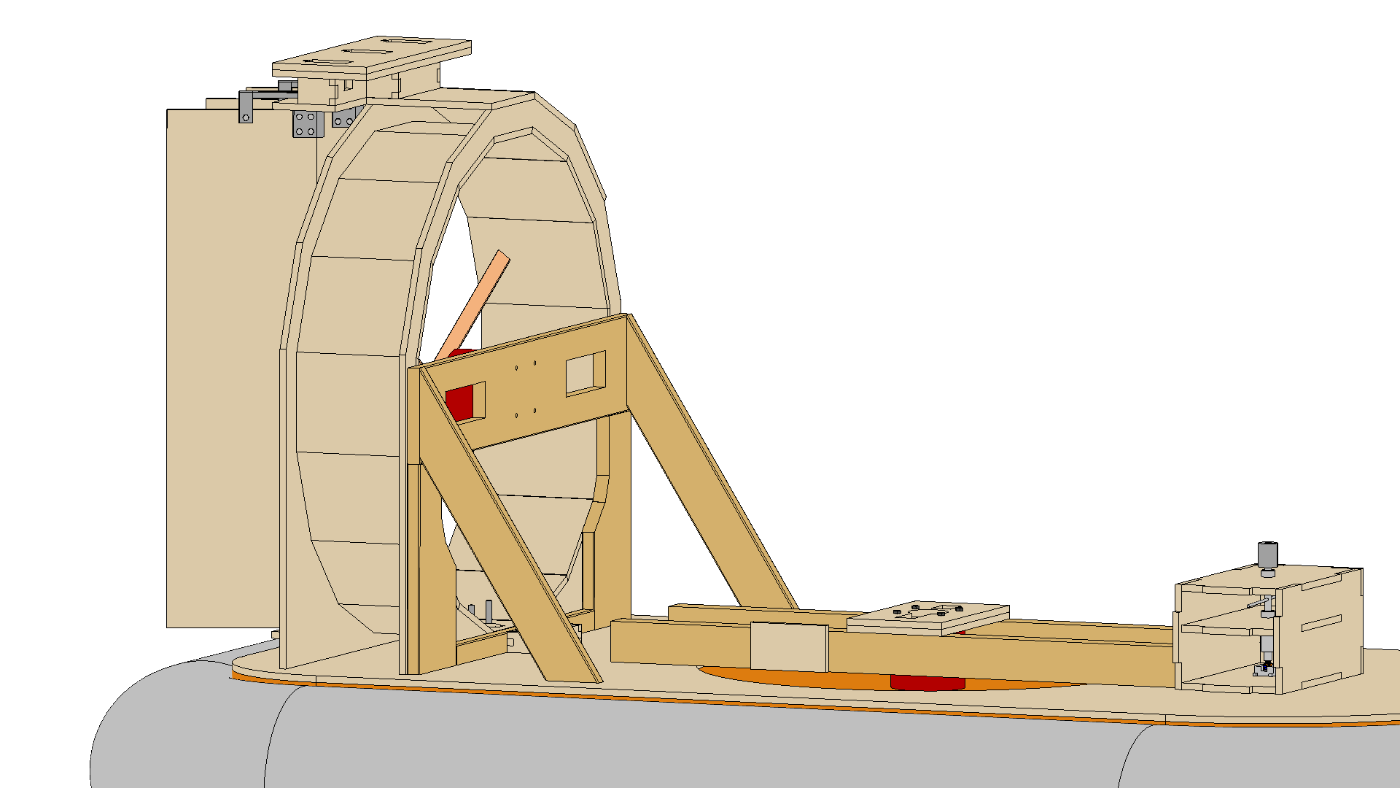
Inventor/PlatinenBilder/Seite1.png
