StefanD2/Diplomarbeit_Hovercraft/Inventor/PlatinenBilder/Seite2.png

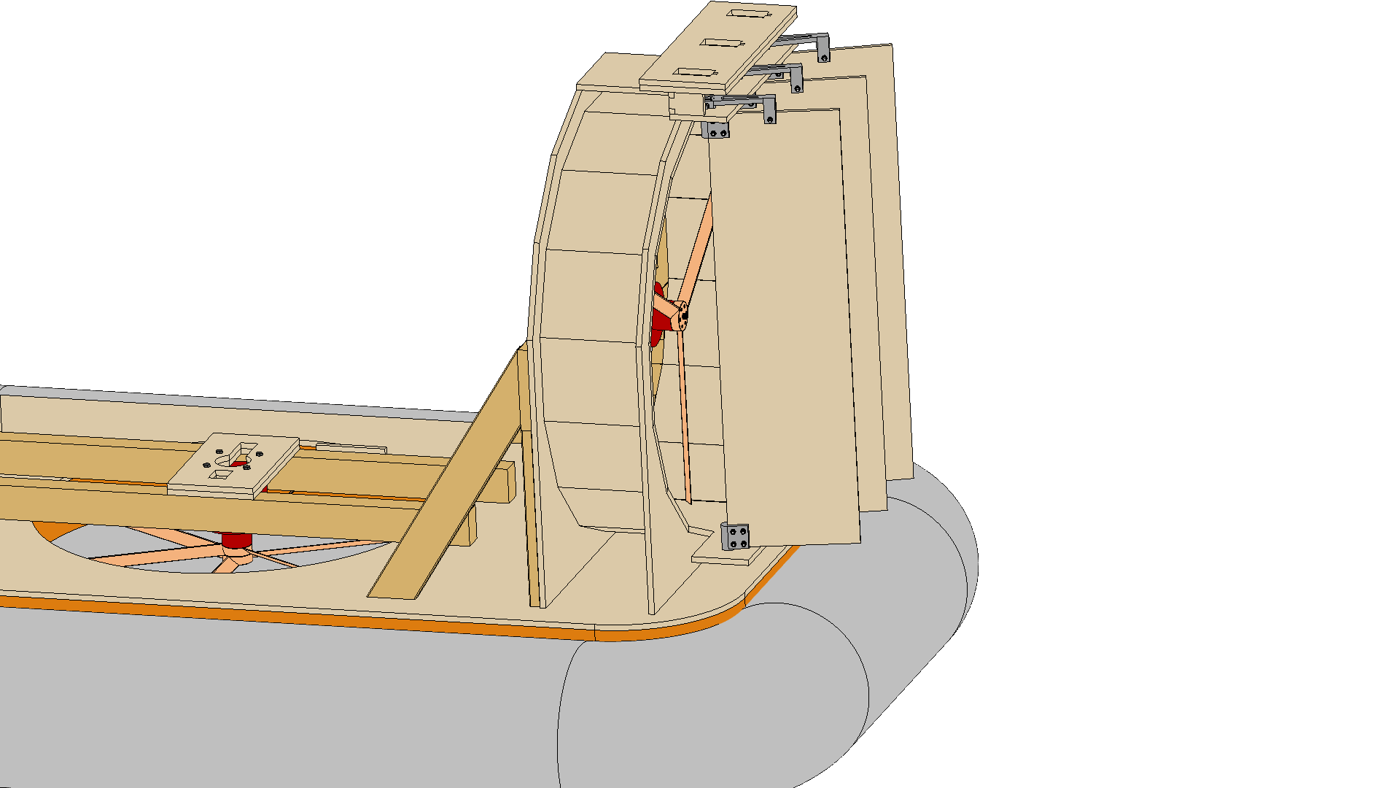
Inventor/PlatinenBilder/Seite2.png
