StefanD2/Diplomarbeit_Hovercraft/Inventor/PlatinenBilder/Seite2_2.png

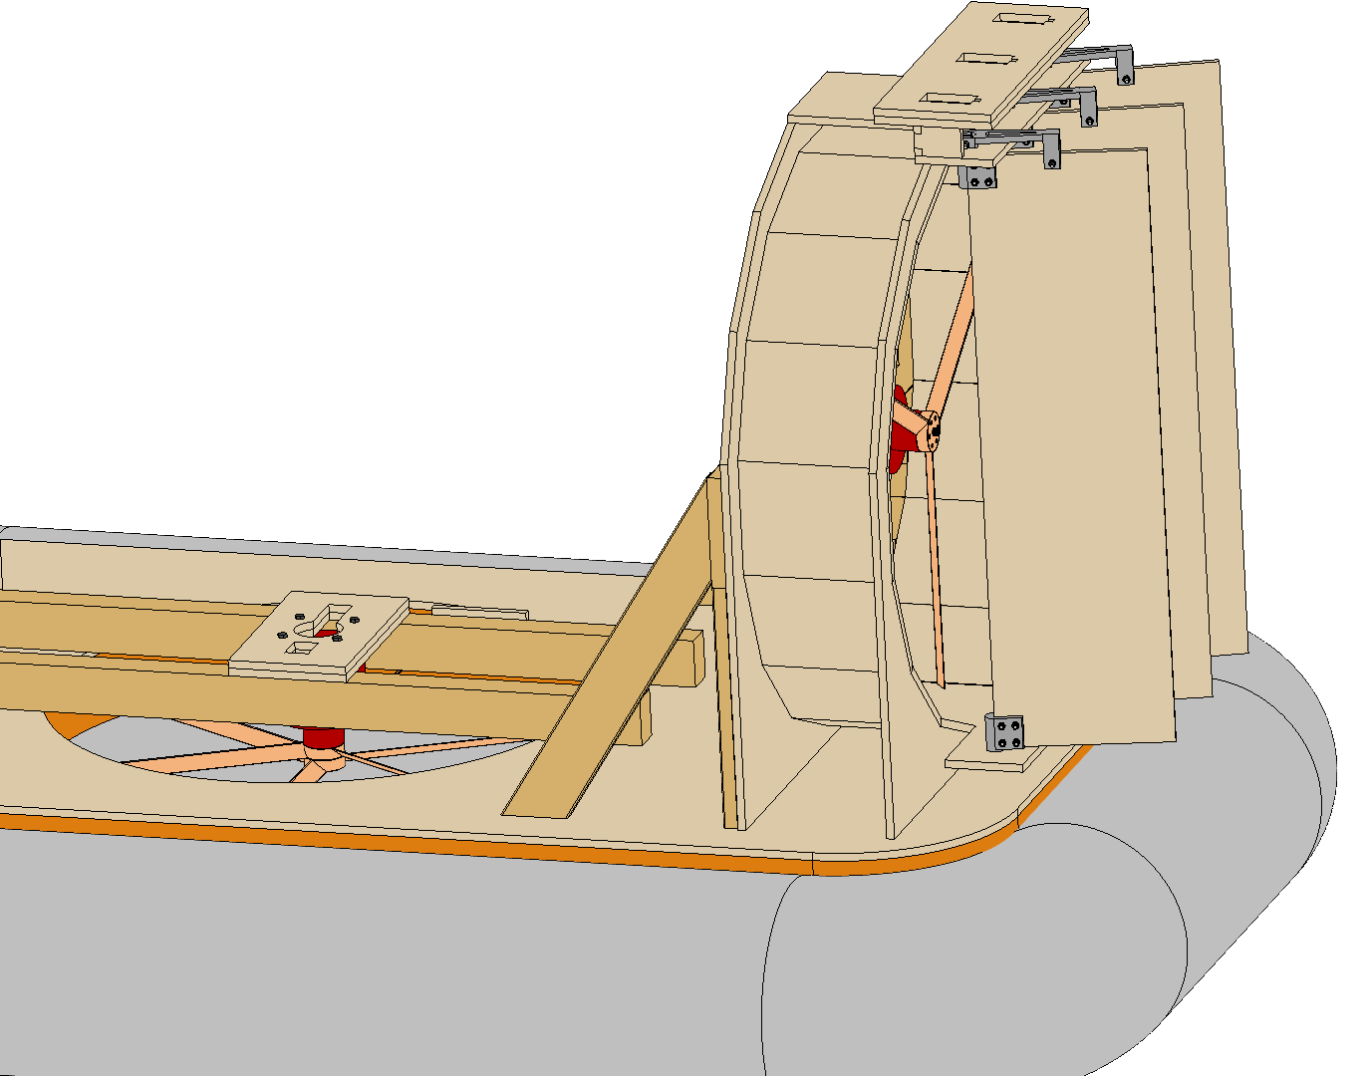
Inventor/PlatinenBilder/Seite2_2.png
