StefanD2/Diplomarbeit_Hovercraft/Inventor/PlatinenBilder/servos.png

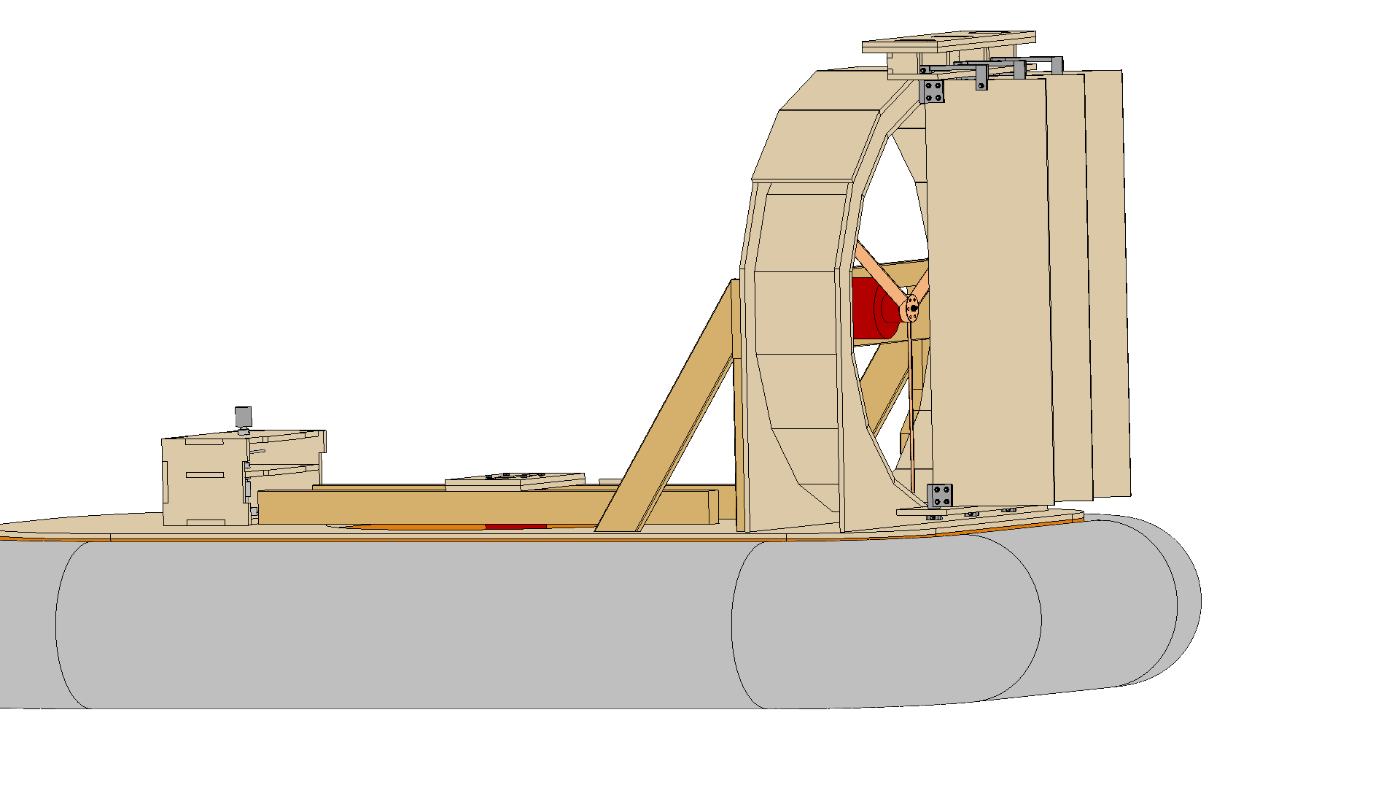
Inventor/PlatinenBilder/servos.png
