StefanD2/Diplomarbeit_Hovercraft/Proteus/Exports/Lenker-Platine.png

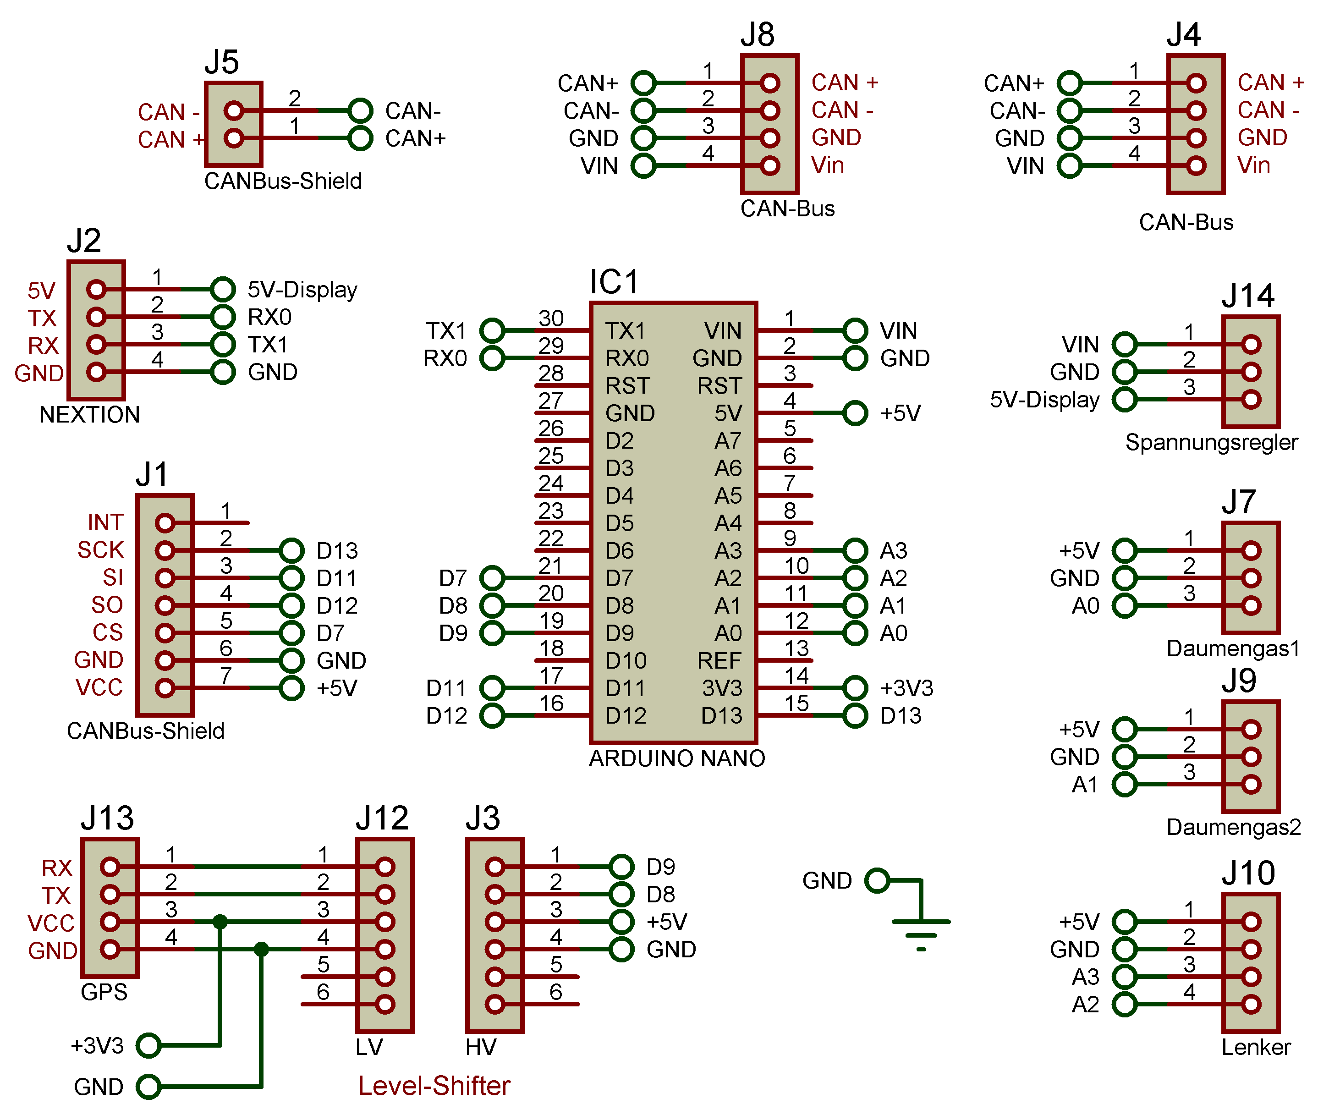
Proteus/Exports/Lenker-Platine.png
