StefanD2/Diplomarbeit_Hovercraft/Proteus/Exports/Lenker_Platine_PCB.png

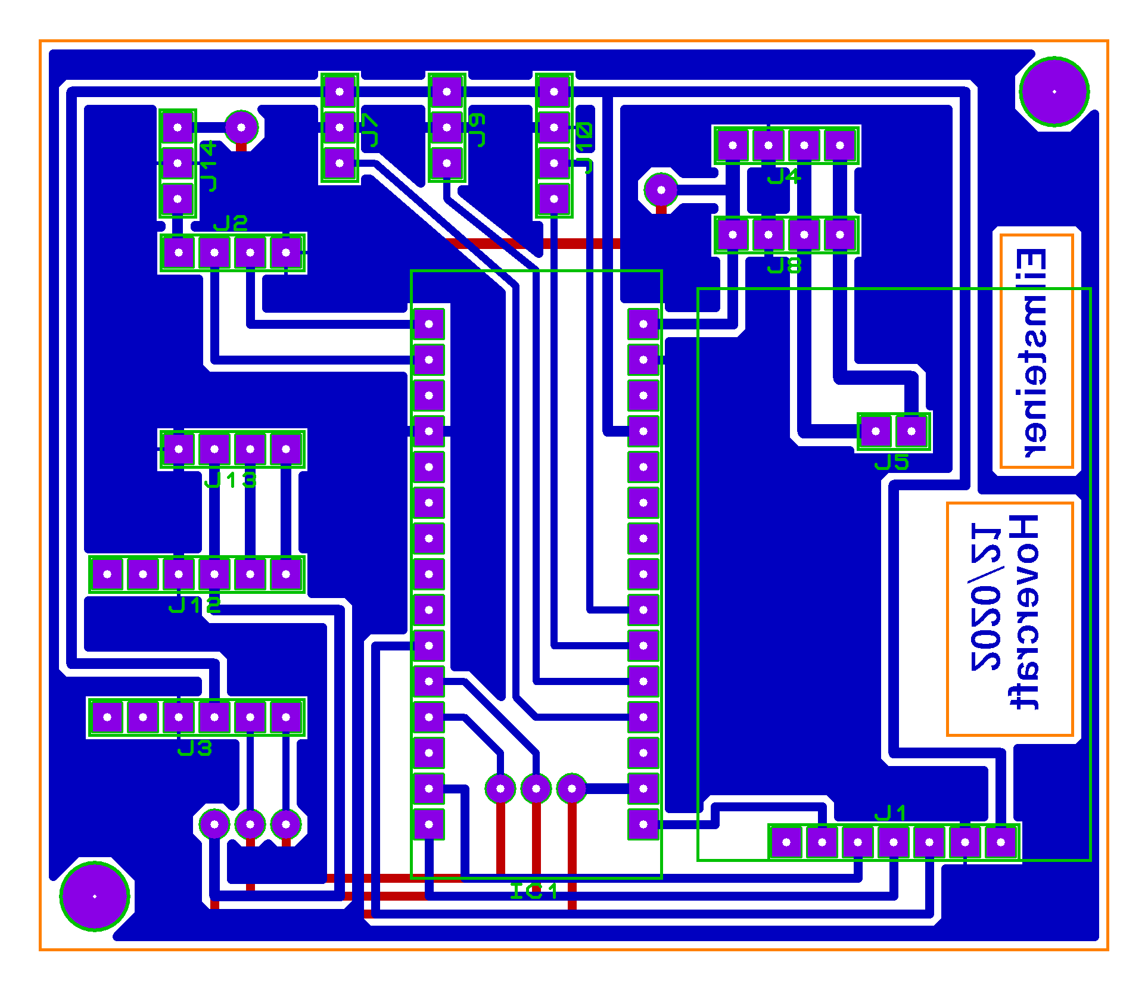
Proteus/Exports/Lenker_Platine_PCB.png
