StefanD2/Diplomarbeit_Hovercraft/Proteus/Exports/Regler-Platine.png

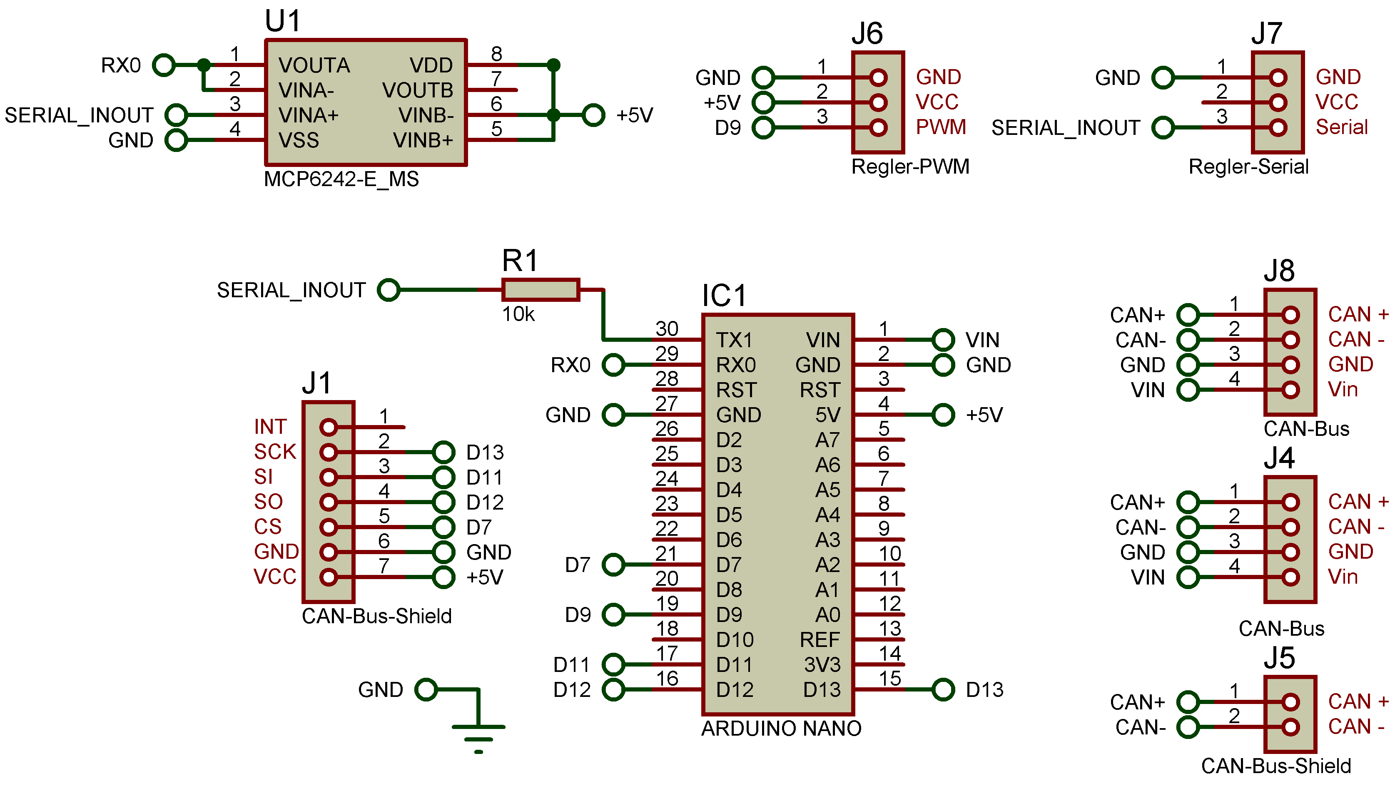
Proteus/Exports/Regler-Platine.png
