StefanD2/Diplomarbeit_Hovercraft/Proteus/Exports/Regler_Platine_PCB.png

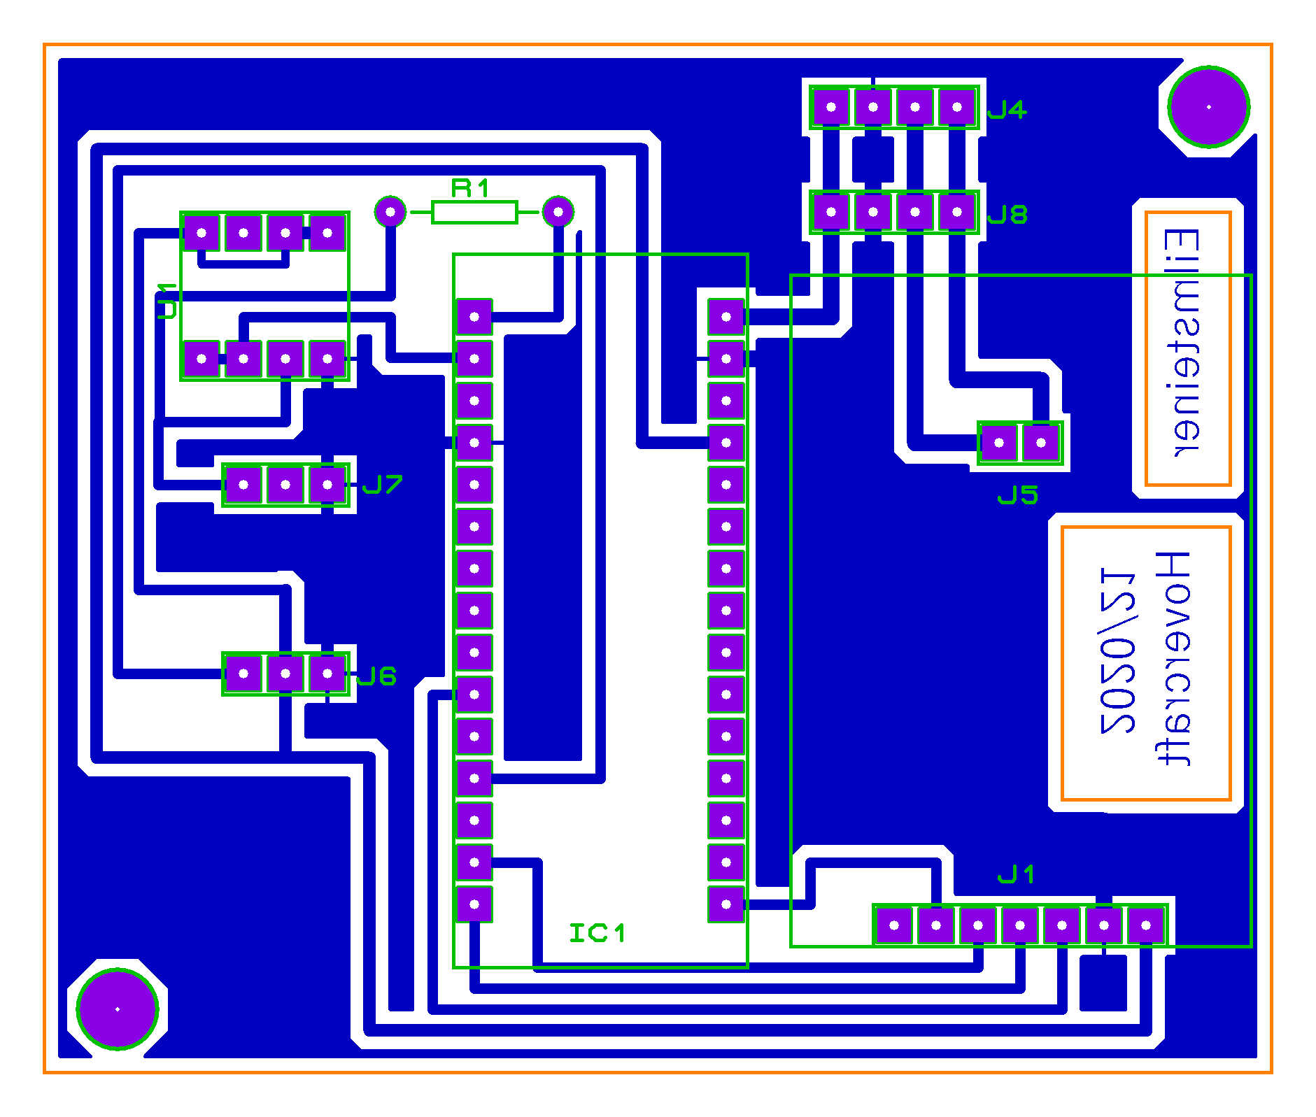
Proteus/Exports/Regler_Platine_PCB.png
