StefanD2/Diplomarbeit_Hovercraft/Proteus/Exports/Relaisansteuerung.png

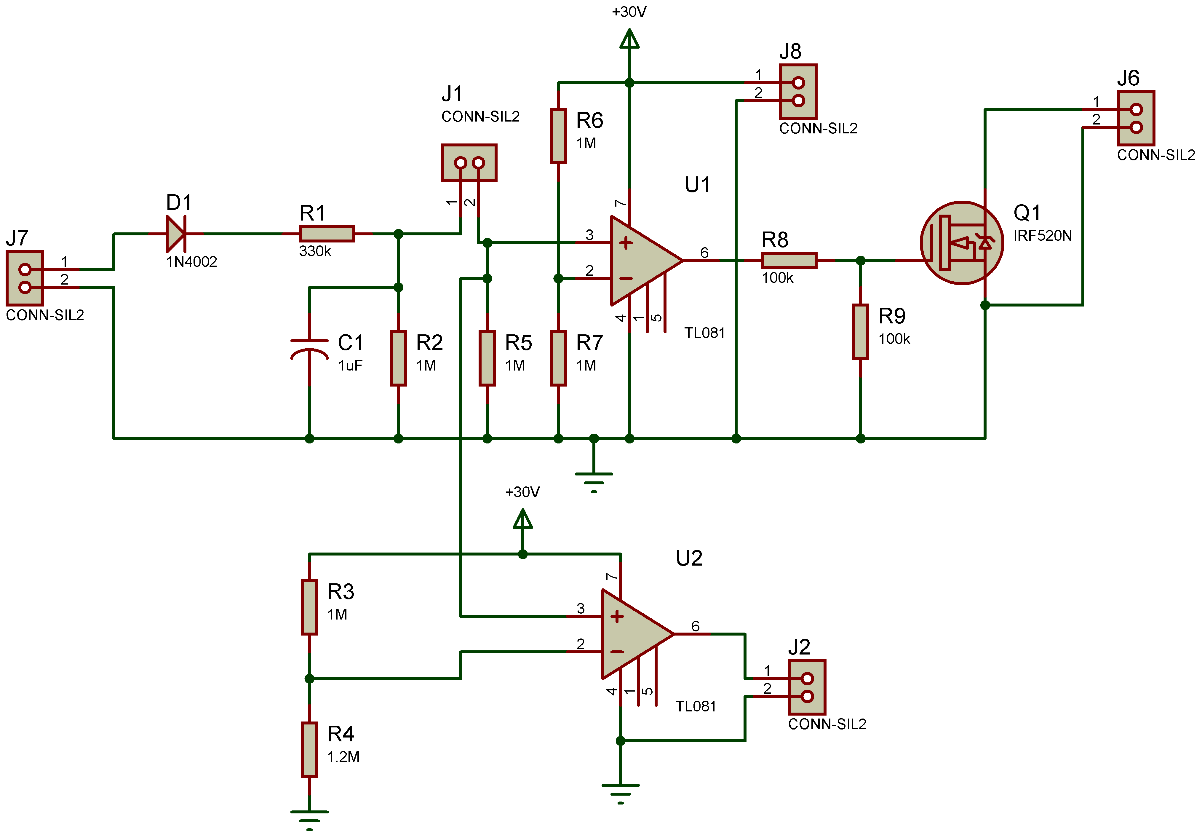
Proteus/Exports/Relaisansteuerung.png
