StefanD2/Diplomarbeit_Hovercraft/Proteus/Exports/Relaisansteuerung_PCB.png

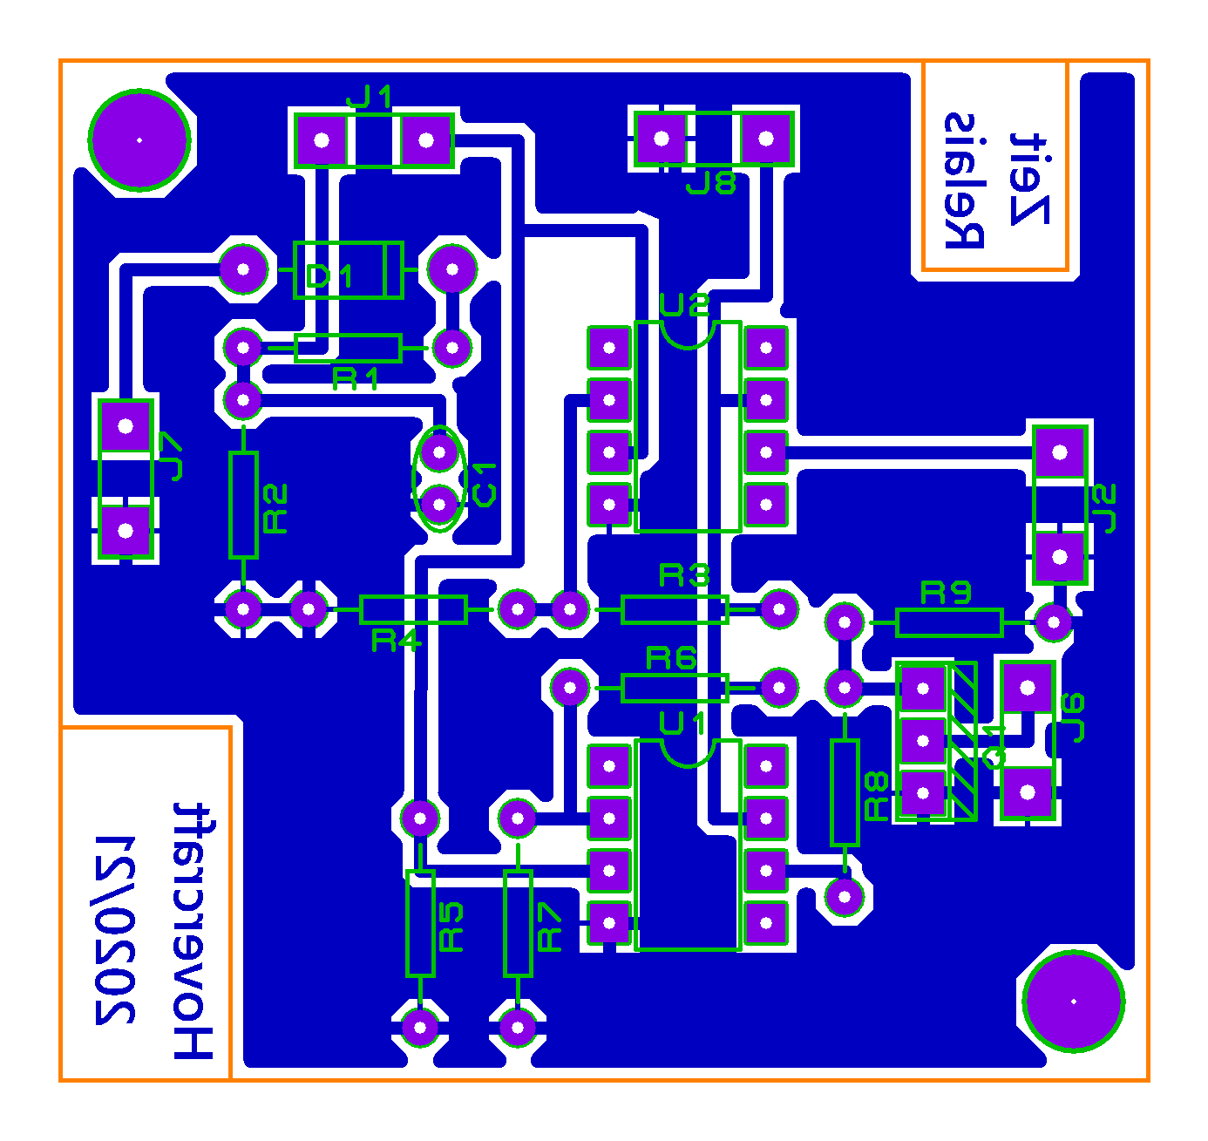
Proteus/Exports/Relaisansteuerung_PCB.png
