StefanD2/Diplomarbeit_Hovercraft/Proteus/Exports/Servos-Platine-PCB.png

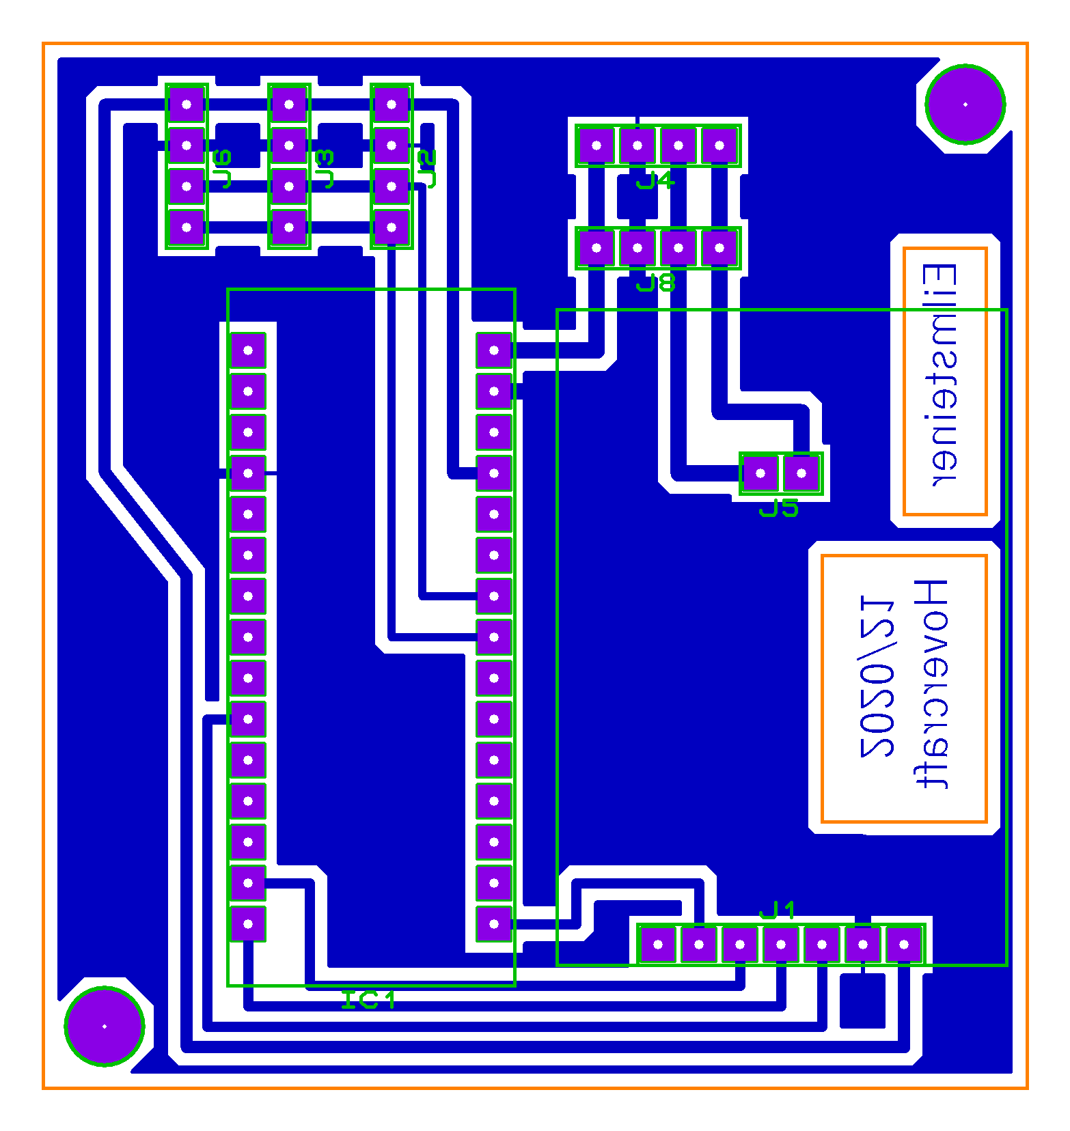
Proteus/Exports/Servos-Platine-PCB.png
