StefanD2/Diplomarbeit_Hovercraft/Proteus/Exports/Servos-Platine.png

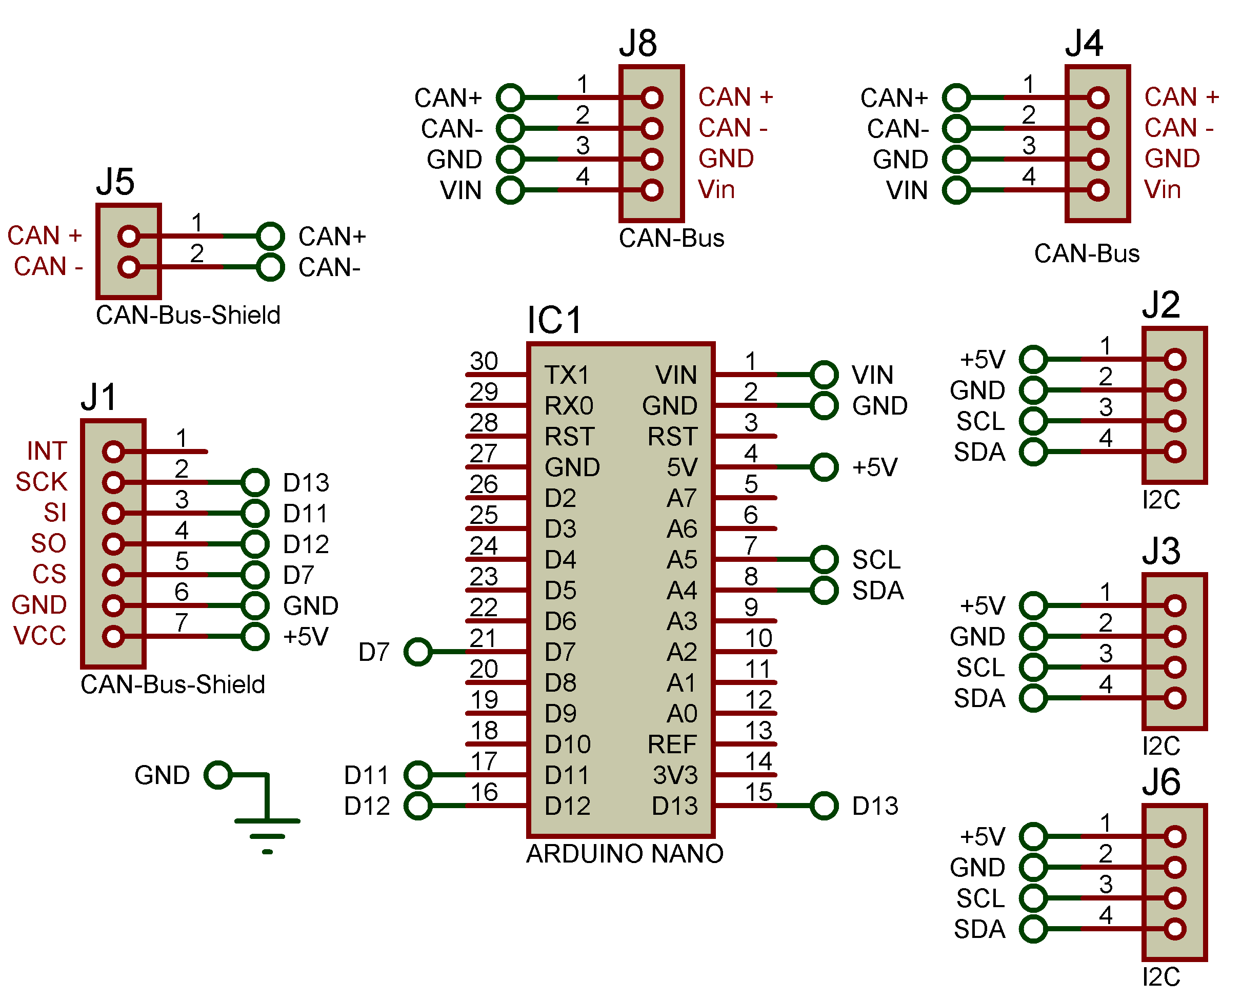
Proteus/Exports/Servos-Platine.png
