StefanD2/Diplomarbeit_Hovercraft/Proteus/Exports/Temperatursensoren-Platine-PCB.png

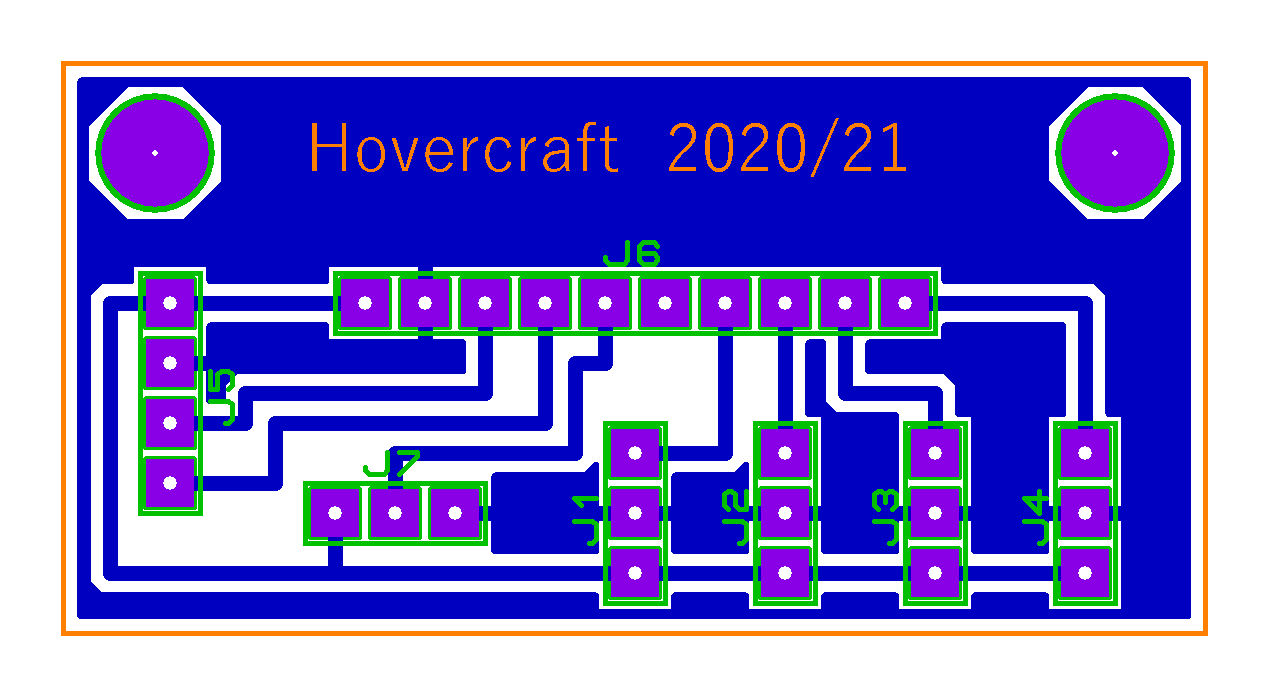
Proteus/Exports/Temperatursensoren-Platine-PCB.png
