StefanD2/Diplomarbeit_Hovercraft/Proteus/Exports/Temperatursensoren-Platine.png

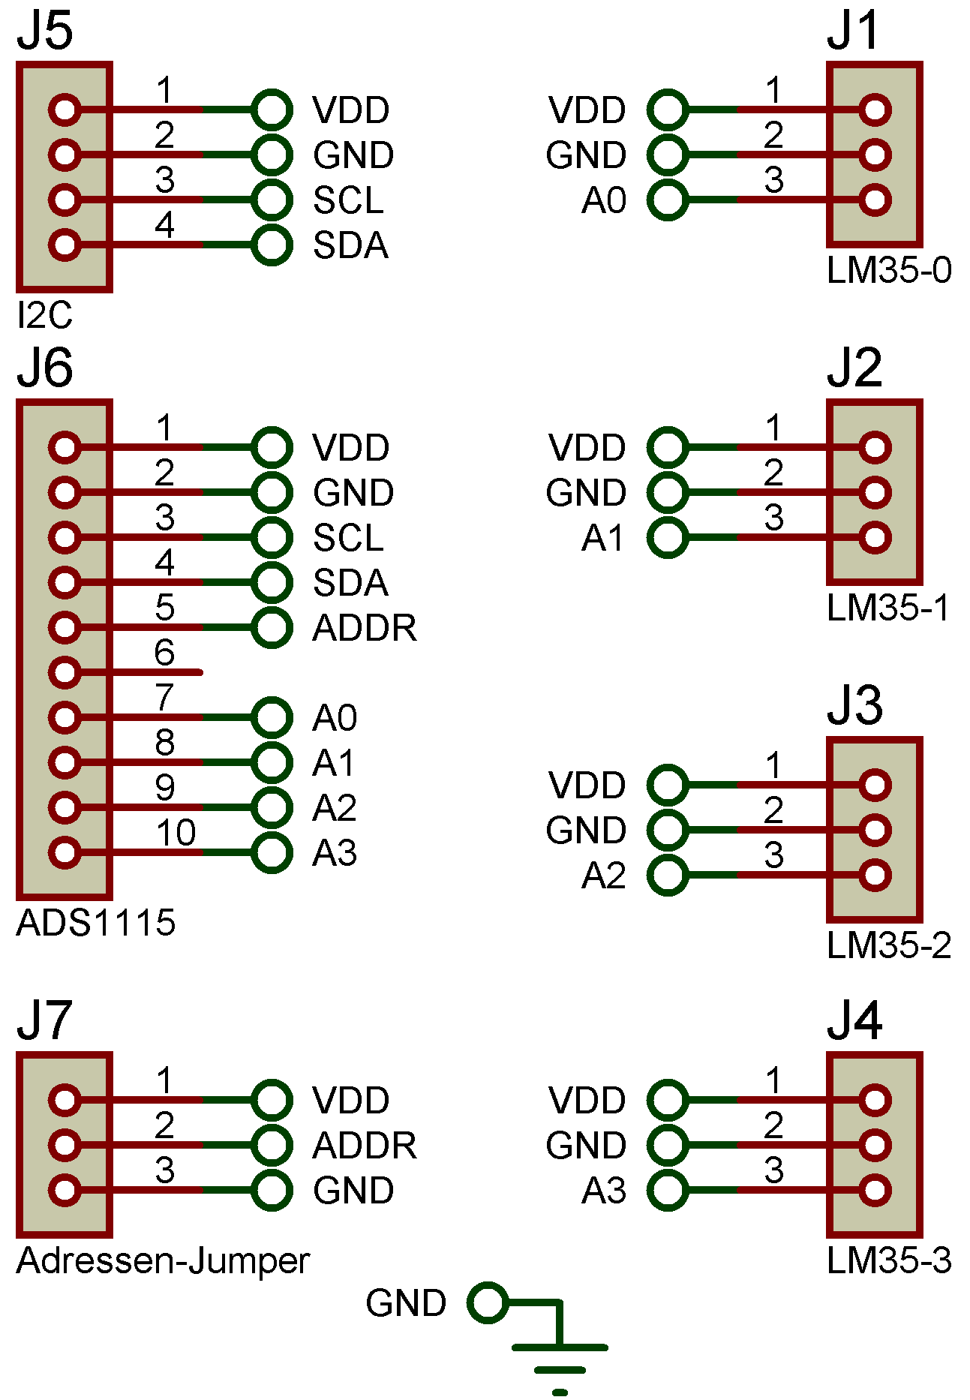
Proteus/Exports/Temperatursensoren-Platine.png
