StefanD2/Diplomarbeit_Hovercraft/Doku/Textparts/Eilmsteiner/Boardelektronik/Boardelektronik_Stueckliste.tex

\section{Stückliste}
\begin{table}[h]
    \centering
    \begin{threeparttable}
    \begin{tabular}{|l|c|M{3cm}|l|}
        \hline
    Name                         & Stück & Händler & Artikel Nr. \\\hline
    Leistungswiderstand $10\,\mathrm{\Omega}$ & 1 & Amazon & \href{https://www.amazon.de/-/en/sourcing-Aluminum-Housing-Mounted-Resistor/dp/B07H25VYM4/}{Link}\\
    JST-XHP Verbinder Set& 1 & Amazon & \href{https://www.amazon.de/dp/B07Q171W48/ref=cm_sw_r_cp_awdb_imm_t1_POHzFbSN8KAB1}{Link}\\ 
    MCP2515 CAN Bus Shield & 4 & Amazon & \href{https://www.amazon.de/-/en/AZDelivery-MCP2515-Shield-compatible-Arduino/dp/B086V3HLQ4}{Link}\\
    Arduino Nano           & 4 & Amazon & \href{https://www.amazon.de/gp/product/B078SBBST6}{Link}\\
    NEO-8M GPS Modul & 1 & Amazon & \href{https://www.amazon.de/-/en/gp/product/B07SQJ7Q6X}{Link}\\
    ADS 1115 ADC Modul & 2 & Amazon & \href{https://www.amazon.de/AZDelivery-ADS1115-Channels-Arduino-Raspberry/dp/B07QHWLTTS}{Link}\\
    16 Channel Servo Driver & 1 & Amazon & \href{https://www.amazon.de/Allrounder-PCA9685-Sunflower-16-Channel-Arduino-Raspberry/dp/B014KTSMLA}{Link}\\\hline
    Nextion Enhanced Display & 1 &  itead.cc & \href{https://www.itead.cc/nextion-nx8048k050.html}{IM160511007}\\
    Daumengas & 2 & Amazon &\href{https://www.amazon.de/gp/product/B07MV75QV7/}{Link}\\\hline
    Omrom Mikroschalter & 2 & RS-Components & \href{https://at.rs-online.com/web/p/detektorschalter/6822314/}{682-2314}\\
    $10\,\mathrm{k\Omega}$ Widerstand & 2 & RS-Components &\href{https://at.rs-online.com/web/p/widerstande-durchsteckmontage/7078906/}{707-8906}\\
    $100\,\mathrm{k\Omega}$ Widerstand & 2 & RS-Components &\href{https://at.rs-online.com/web/p/widerstande-durchsteckmontage/7078388/}{707-8388}\\
    $330\,\mathrm{k\Omega}$ Widerstand & 1 & RS-Components &\href{https://at.rs-online.com/web/p/widerstande-durchsteckmontage/7078962/}{707-8962}\\
    $1\,\mathrm{M\Omega}$ Widerstand & 5 & RS-Components &\href{https://at.rs-online.com/web/p/widerstande-durchsteckmontage/7077903/}{707-7903}\\
    $1.2\,\mathrm{M\Omega}$ Widerstand & 1 & RS-Components &\href{https://at.rs-online.com/web/p/widerstande-durchsteckmontage/4846311/}{484-6311}\\
    1N4007 Diode & 1 & RS-Components & \href{https://at.rs-online.com/web/p/schottky-dioden-und-gleichrichter/7003665/}{700-3665}\\
    Elko $1\,\mathrm{\mu F}$ & 1 & RS-Components & \href{https://at.rs-online.com/web/p/aluminium-elektrolytkondensatoren/7111671/}{711-1671}\\
    MCP6242 $5\,\mathrm{V}$ OPVs & 2 & RS-Components & \href{https://at.rs-online.com/web/p/operationsverstarker/0403165/}{403-165}\\
    LM7805CT Spannungsregler & 1 & RS-Components & \href{https://at.rs-online.com/web/p/spannungsregler/7968060/}{796-8060}\\
    LM35 Temperatursensor & 8 & RS-Components & \href{https://at.rs-online.com/web/p/temperatur-und-luftfeuchtigkeit-sensoren/8115595/}{811-5595}\\
    N-Kanal MOSFET & 1 & RS-Components & \href{https://at.rs-online.com/web/p/mosfet/5411180/}{541-1180}\\
    TL081CP OPV & 2 & RS-Components & \href{https://at.rs-online.com/web/p/operationsverstarker/0304223/}{304-223}\\
    Leiterplattenklemmen & 10 & RS-Components & \href{https://at.rs-online.com/web/p/leiterplatten-printklemmen/7901064/}{790-1064}\\
    Potenziometer & 1 & RS-Components & \href{https://at.rs-online.com/web/p/potentiometer/7293492/}{729-3492}\\
    Druckschalter Tastend & 1 & RS-Components & \href{https://at.rs-online.com/web/p/drucktaster-schalter/8118480/}{811-8480}\\\hline
    Not-Aus Schlüsseltaster & 1 & Schrack & \href{https://www.schrack.at/shop/steuer-regeltechnik-relais-schalter-schuetze-zaehler-netzgeraete/befehls-und-meldegeraete/befehls-und-meldegeraete-serie-mm/serie-mm-befe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}{MM216514--}\\
    \hline
    \end{tabular}
%    \begin{tablenotes}\footnotesize 
%    \end{tablenotes}
\end{threeparttable}
    \caption{Stückliste der Boardelektronik\label{tab:stuecklsiteboardelektronik}}
\end{table}

\newpage
