StefanD2/Diplomarbeit_Hovercraft/Doku/Textparts/Eilmsteiner/Leistungselektronik/Leistungselektronik_Stueckliste.tex

\section{Stückliste}

\begin{table}[h]
    \begin{threeparttable}
    \centering
    \begin{tabular}{|l|c|M{3cm}|l|}
        \hline
    Name                         & Stück & Händler & Bestell Nr. \\\hline
    Hacker A200-6                & 2      & Conrad  & \href{https://www.conrad.at/de/p/hacker-a200-6-flugmodell-brushless-elektromotor-kv-u-min-pro-volt-151-255083.html}{255083 - AW} \\
    Jeti MasterSPIN 220 Pro OPTO & 2      & Conrad  & \href{https://www.conrad.at/de/p/jeti-masterspin-220-pro-opto-flugmodell-brushless-flugregler-275457.html}{275457 - AW} \\
    Jeti Programmierbox          & 1      & Conrad  & \href{https://www.conrad.at/de/p/jeti-programmierbox-passend-fuer-masterbasic-regler-serie-masterspin-regler-serie-jeti-spin-regler-serie-jeti-duplex-208809.html}{208809 - AW} \\
    XOAR Elektro Flugzeug-Propeller & 1 & Conrad & \href{https://www.conrad.at/de/p/xoar-elektro-flugzeug-propeller-28-x-12-zoll-71-1-x-30-5-cm-35280120-321841.html}{321841 - AW} \\
    XOAR Elektro Flugzeug-Propeller\tnote{1} & 2 & Conrad & \href{https://www.conrad.de/de/p/xoar-elektro-flugzeug-propeller-28-x-10-zoll-71-1-x-25-4-cm-36280120-322012.html}{322012 - AW}\\\hline
    TopFuel LiPo 35C Power-X 7500mAh 7S & 8 & Hacker & \href{https://www.hacker-motor-shop.com/Akkus-und-Akkuzubehoer/Akkusuche/TF-Power-X-7500-7S-MTAG.htm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}{97500761} \\\hline
    ISDT P30 Smart Charger & 1 & modell- & \href{https://www.modell-hubschrauber.at/Ladegeraete-Netzteile-Ladekabel-und-Zubehoer/Ladegeraete/Ladegeraete-12Volt/iSDT-SMART-Dup-Ladegeraet-P30-1500W-30A-8S-Lipo::43075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}{34549}\\
    ISDT SP3060 Smart Power Supply & 1 &hubschrauber.at& \href{https://www.modell-hubschrauber.at/Ladegeraete-Netzteile-Ladekabel-und-Zubehoer/Netzteile/iSDT-SP3060-SMART-POWER-Schaltnetzteil-21-29Volt-60Ampere-1800Watt::40657.h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}{32324}\\\hline
    Omron G2R Monostabiles Relais & 4 & RS-Components & \href{https://at.rs-online.com/web/p/monostabile-relais/7948139/}{794-8139}\\
    Sockel Omron P2R-057P & 4 & RS-Components & \href{https://at.rs-online.com/web/p/einbaumessgerate-zubehor/2604446/}{260-4446}\\
    TE Connectivity Kfz-Relais & 1 & RS-Components & \href{https://at.rs-online.com/web/p/monostabile-relais/6900814}{690-0814} \\
    Automotive Kfz Sicherung & 2 & RS-Components & \href{https://at.rs-online.com/web/p/kfz-sicherungen/1611829/}{161-1829}\\\hline
    Kupfer-Sammelschiene & 1 & Schrack & \href{https://www.schrack.at/shop/verteilereinbau-ls-fi-ueberspannungsableiter-d0-und-nh/schmelzsicherungs-und-sammelschienensysteme/sammelschienensysteme/sammelschienen/k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}{IS505069}\\
    Presskabelschuh & 40 & Schrack & \href{https://www.schrack.at/shop/kabel-leitungen/presskabelschuh-kabelzubehoer/din-presskabelschuhe/presskabelschuh-10mm2-m8-xcz102r8.html}{XCZ102R8}\\\hline
    Servo & 4 & Amazon & \href{https://www.amazon.de/-/en/gp/product/B07T6DNLV4/}{Link}\\
    Buck Converter\tnote{1} & 4 & Amazon & \href{https://www.amazon.de/gp/product/B085DSMFQM/ref=ppx_yo_dt_b_asin_image_o03_s00?ie=UTF8&psc=1}{Link} \\\hline 
    \end{tabular}
    \begin{tablenotes}\footnotesize 
        \item[1] zum Zeitpunkt des Schreibens der Dokumentation nicht mehr verfügbar 
    \end{tablenotes}
\end{threeparttable}
    \caption{Stückliste der Leistungselektronik}
\end{table}

\newpage
