StefanD2/Diplomarbeit_Hovercraft/Inventor/SkizzenExportLightBurn/SerovHalterMainPlatte.dxf

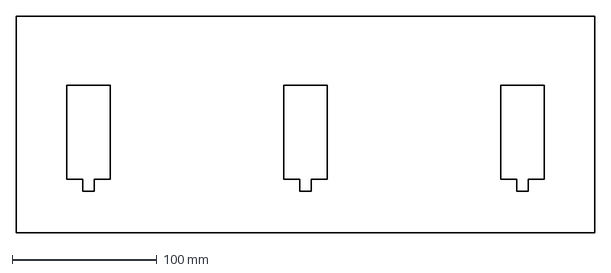
[picture p87: CAD file, 2021-01-02]
Inventor/SkizzenExportLightBurn/SerovHalterMainPlatte.dxf
400.0 x 150.0 mm
