StefanD2/Diplomarbeit_Hovercraft/Inventor/FahnenhalterTeiloben.stl

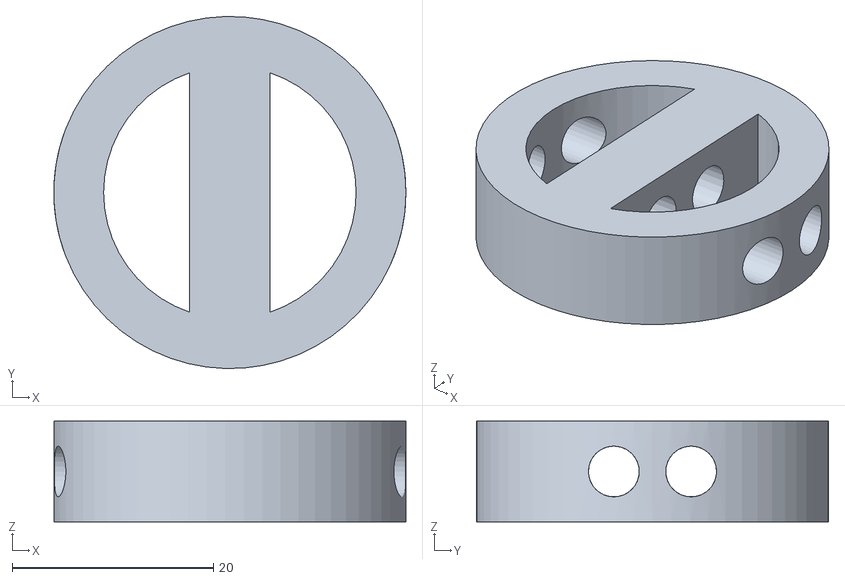
[picture p88: CAD file, 2021-01-02]
Inventor/FahnenhalterTeiloben.stl
35.0 x 35.0 x 10.0
