StefanD2/Diplomarbeit_Hovercraft/Inventor/hintererAufbau/LBR-KabelBox/KaelBoxDeckel.dxf

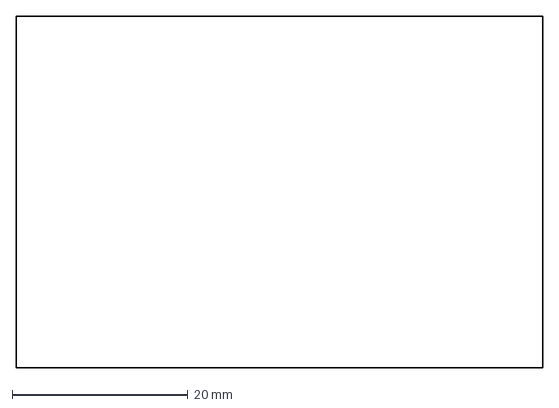
[picture p89: CAD file, 2021-02-17]
Inventor/hintererAufbau/LBR-KabelBox/KaelBoxDeckel.dxf
60.0 x 40.0 mm
