StefanD2/Diplomarbeit_Hovercraft/Inventor/Lenker/Skizzen/PlatteSeite_1-2stk.dxf

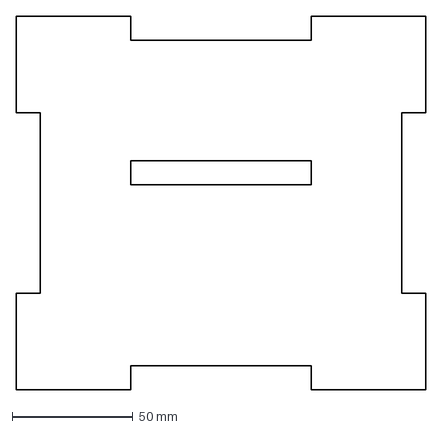
[picture p90: CAD file, 2021-01-02]
Inventor/Lenker/Skizzen/PlatteSeite_1-2stk.dxf
170.0 x 155.0 mm
