StefanD2/Diplomarbeit_Hovercraft/Inventor/Lenker/SkizzePlatte.dxf

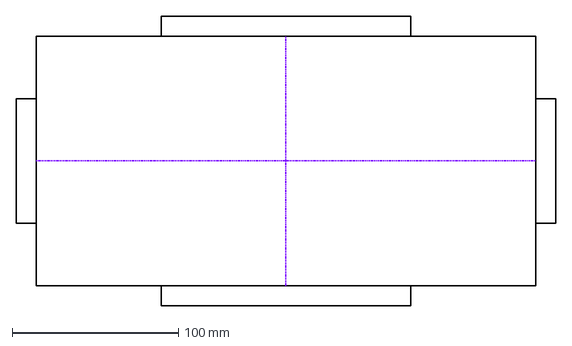
[picture p91: CAD file, 2021-01-02]
Inventor/Lenker/SkizzePlatte.dxf
324.0 x 174.0 mm
