StefanD2/Diplomarbeit_Hovercraft/Inventor/Lenker/stl/StangePotiAdapter1.stl

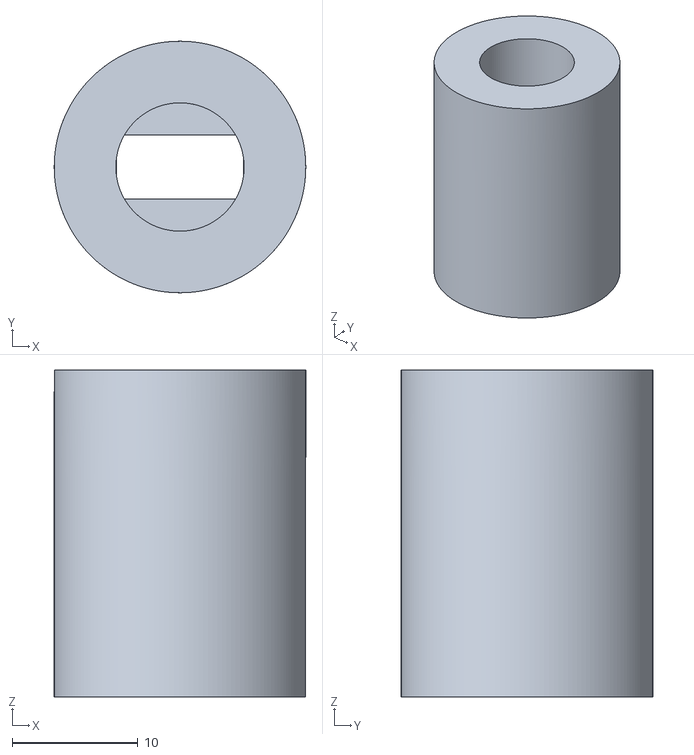
[picture p92: CAD file, 2021-01-02]
Inventor/Lenker/stl/StangePotiAdapter1.stl
20.0 x 20.0 x 26.0
