StefanD2/Diplomarbeit_Hovercraft/Inventor/MotorhalterungLightBurn/MotorhalterungV2.dxf

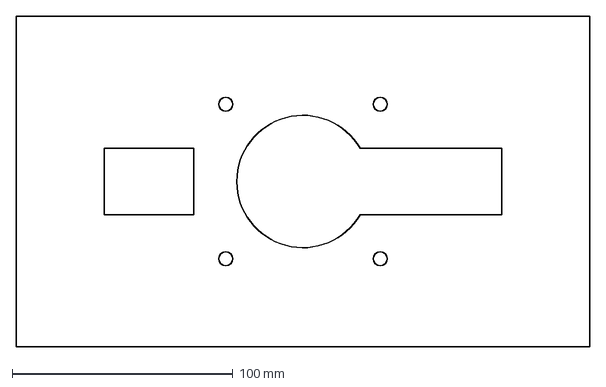
[picture p93: CAD file, 2021-01-02]
Inventor/MotorhalterungLightBurn/MotorhalterungV2.dxf
260.0 x 150.0 mm
