StefanD2/Diplomarbeit_Hovercraft/Inventor/PropellerBohrungenVorlageLightBurn/PropellerBohrungen.dxf

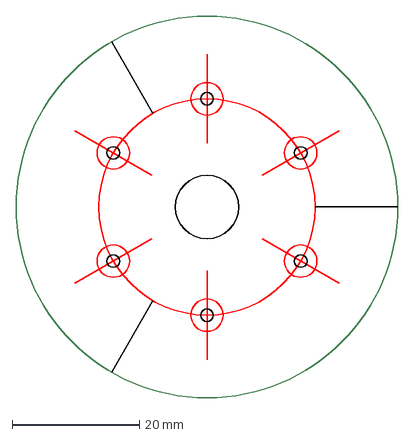
[picture p94: CAD file, 2021-01-02]
Inventor/PropellerBohrungenVorlageLightBurn/PropellerBohrungen.dxf
60.0 x 60.0 mm
