StefanD2/Diplomarbeit_Hovercraft/Inventor/SkizzenExportLightBurn/HalterungSerosHochSeitlich.dxf

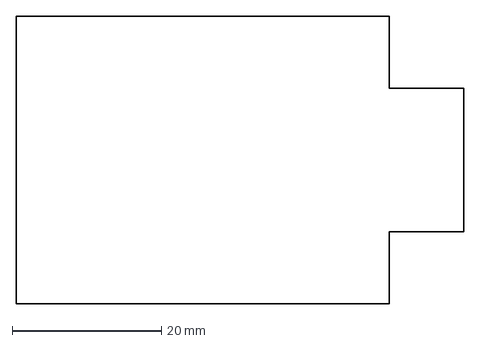
[picture p95: CAD file, 2021-01-02]
Inventor/SkizzenExportLightBurn/HalterungSerosHochSeitlich.dxf
60.0 x 38.5 mm
