StefanD2/Diplomarbeit_Hovercraft/Inventor/Fahnenhalter.stl

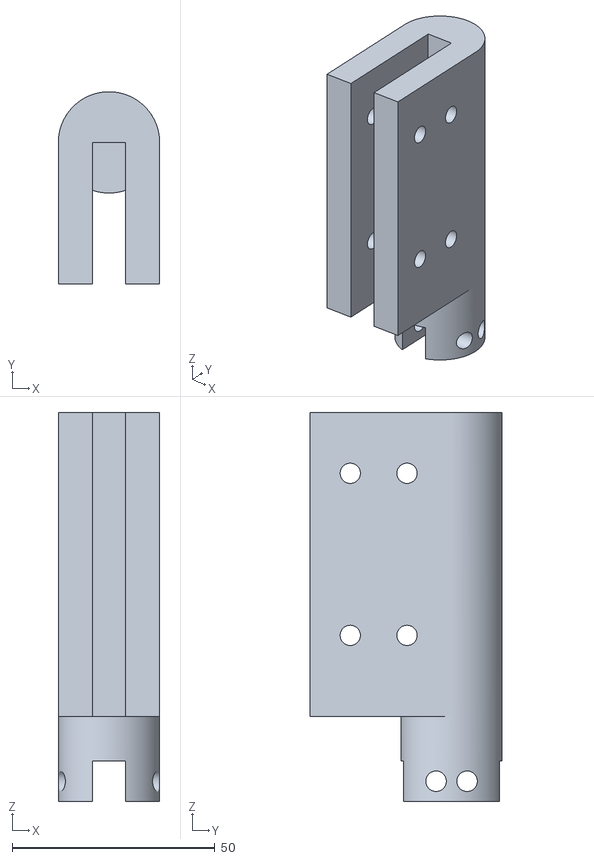
[picture p96: CAD file, 2021-01-02]
Inventor/Fahnenhalter.stl
25.0 x 47.5 x 96.0
