StefanD2/Diplomarbeit_Hovercraft/Inventor/hintererAufbau/LBR-KabelBox/KabelBoxSeitelang.dxf

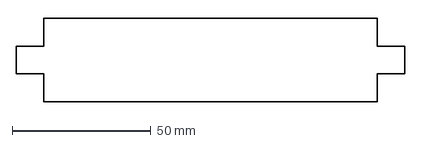
[picture p97: CAD file, 2021-02-17]
Inventor/hintererAufbau/LBR-KabelBox/KabelBoxSeitelang.dxf
140.0 x 30.0 mm
