StefanD2/Diplomarbeit_Hovercraft/Inventor/hintererAufbau/SkizzenTemp/platteUnten.dxf

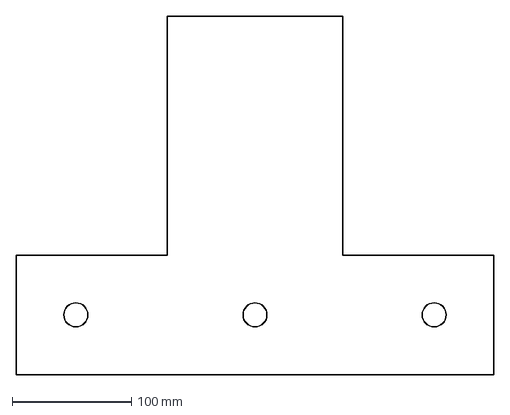
[picture p98: CAD file, 2021-02-12]
Inventor/hintererAufbau/SkizzenTemp/platteUnten.dxf
400.0 x 300.0 mm
