StefanD2/Diplomarbeit_Hovercraft/Inventor/Lenker/Poti-RK09712_0-L15.STEP

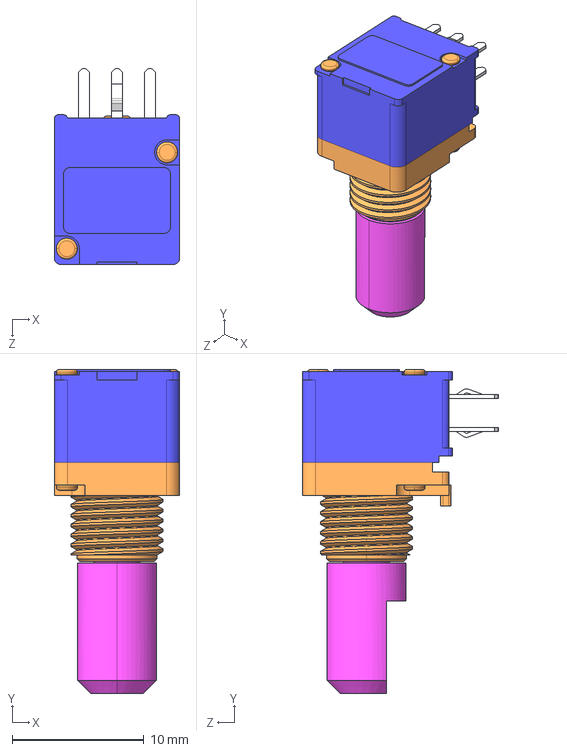
[picture p99: CAD file, 2021-01-02]
Inventor/Lenker/Poti-RK09712_0-L15.STEP
9.50 x 24.6 x 14.8 mm
