StefanD2/Diplomarbeit_Hovercraft/Inventor/Lenker/Skizzen/PlatteUnten_1-1stk.dxf

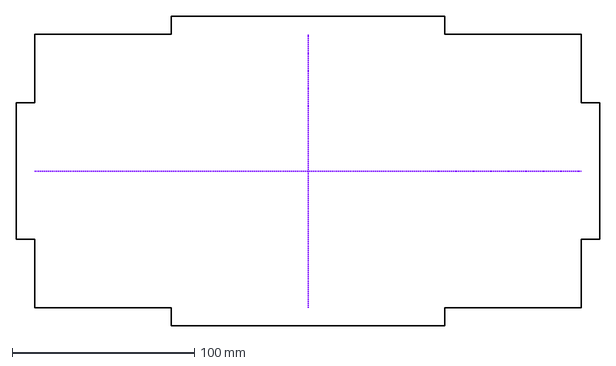
[picture p100: CAD file, 2021-01-02]
Inventor/Lenker/Skizzen/PlatteUnten_1-1stk.dxf
320.0 x 170.0 mm
