StefanD2/Diplomarbeit_Hovercraft/Inventor/Lenker/stl/AdapterPoti2.stl

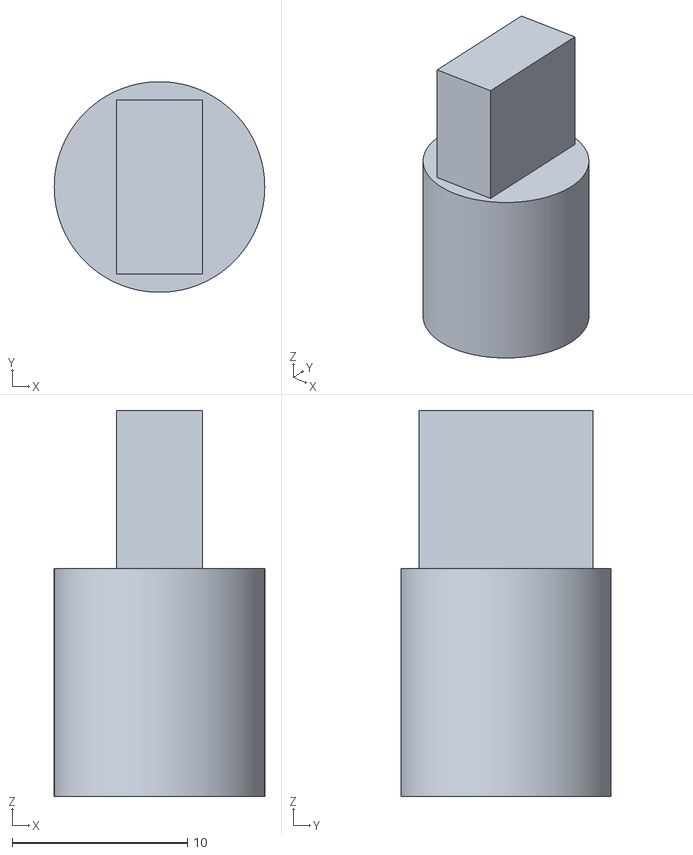
[picture p101: CAD file, 2021-01-02]
Inventor/Lenker/stl/AdapterPoti2.stl
12.0 x 12.0 x 22.0
