StefanD2/Diplomarbeit_Hovercraft/Inventor/hintererAufbau/LBR-KabelBox/KabelBoxSeite.dxf

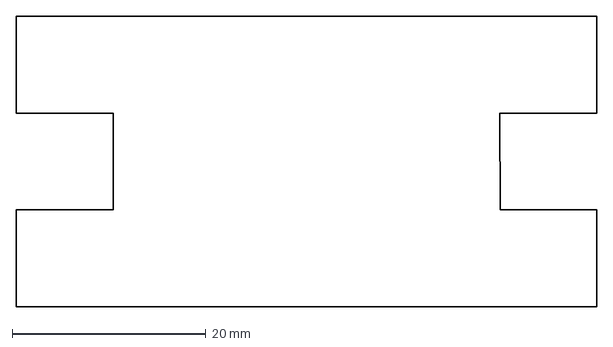
[picture p102: CAD file, 2021-02-17]
Inventor/hintererAufbau/LBR-KabelBox/KabelBoxSeite.dxf
60.0 x 30.0 mm
