StefanD2/Diplomarbeit_Hovercraft/Inventor/hintererAufbau/SkizzenTemp/platteOben.dxf

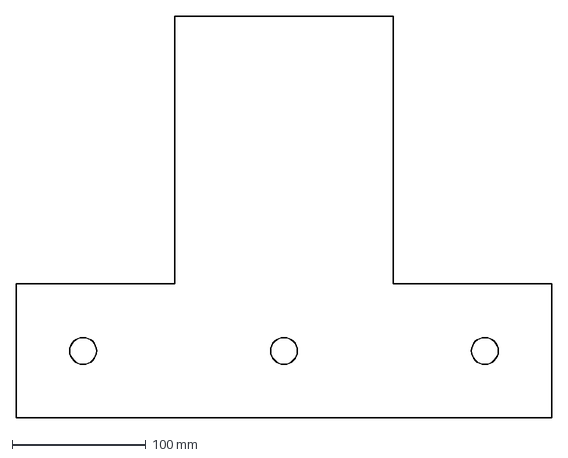
[picture p103: CAD file, 2021-02-12]
Inventor/hintererAufbau/SkizzenTemp/platteOben.dxf
400.0 x 300.0 mm
