StefanD2/Diplomarbeit_Hovercraft/Inventor/Lenker/Skizzen/PlatteMitteOben_1-2stk.dxf

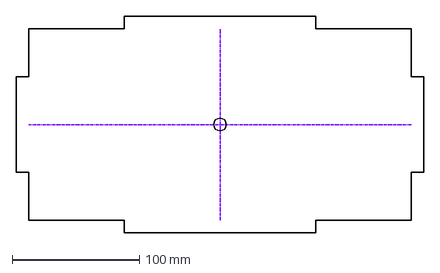
[picture p104: CAD file, 2021-01-02]
Inventor/Lenker/Skizzen/PlatteMitteOben_1-2stk.dxf
320.0 x 170.0 mm
