StefanD2/Diplomarbeit_Hovercraft/Inventor/Lenker/stl/PotiHalterungUnten.stl

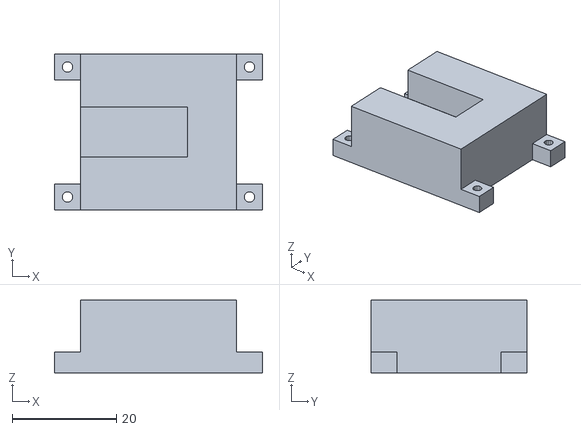
[picture p105: CAD file, 2021-01-02]
Inventor/Lenker/stl/PotiHalterungUnten.stl
40.0 x 30.0 x 14.0
