StefanD2/Diplomarbeit_Hovercraft/Inventor/SkizzenExportLightBurn/HolzServoHalterHochLang.dxf

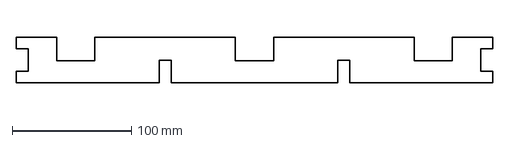
[picture p106: CAD file, 2021-01-02]
Inventor/SkizzenExportLightBurn/HolzServoHalterHochLang.dxf
400.0 x 38.5 mm
