StefanD2/Diplomarbeit_Hovercraft/Inventor/hintererAufbau/SkizzenTemp/SkizzePlatteInnenEins.dxf

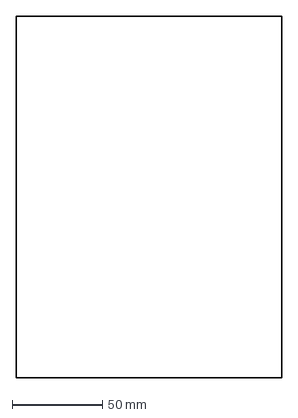
[picture p107: CAD file, 2021-02-12]
Inventor/hintererAufbau/SkizzenTemp/SkizzePlatteInnenEins.dxf
147.2 x 200.0 mm
