StefanD2/Diplomarbeit_Hovercraft/Inventor/Lenker/Skizzen/PlatteSeite_2-2stk.dxf

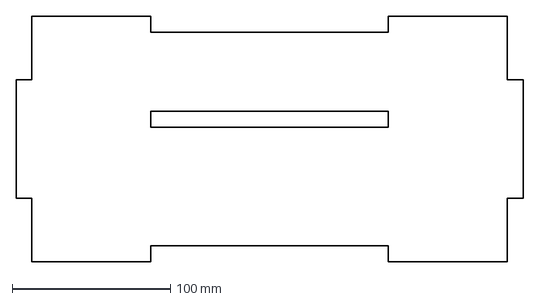
[picture p108: CAD file, 2021-01-02]
Inventor/Lenker/Skizzen/PlatteSeite_2-2stk.dxf
320.0 x 155.0 mm
