StefanD2/Diplomarbeit_Hovercraft/Inventor/SkizzenExportLightBurn/HolzServoHalterHinten.dxf

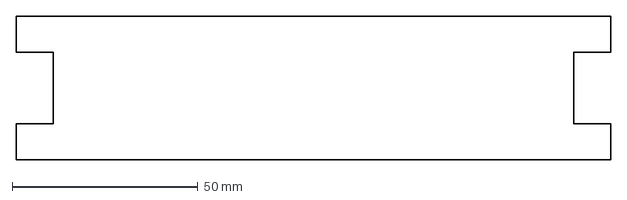
[picture p109: CAD file, 2021-01-02]
Inventor/SkizzenExportLightBurn/HolzServoHalterHinten.dxf
160.0 x 38.5 mm
