StefanD2/Diplomarbeit_Hovercraft/Inventor/hintererAufbau/SkizzenTemp/großeHolzplatteGesamtDing.dxf

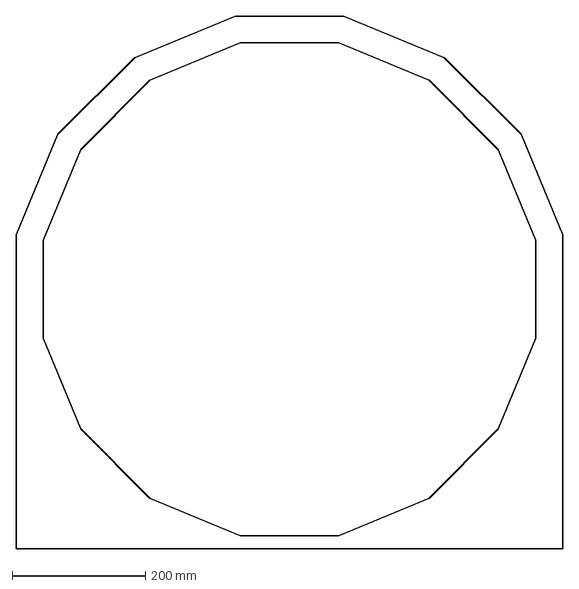
[picture p110: CAD file, 2021-02-12]
Inventor/hintererAufbau/SkizzenTemp/großeHolzplatteGesamtDing.dxf
820.0 x 800.0 mm
