StefanD2/Diplomarbeit_Hovercraft/Inventor/SkizzenExportLightBurn/HalterungServoHochSeitlich2.dxf

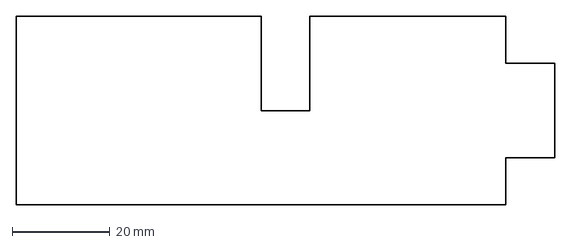
[picture p111: CAD file, 2021-01-02]
Inventor/SkizzenExportLightBurn/HalterungServoHochSeitlich2.dxf
110.0 x 38.5 mm
