StefanD2/Diplomarbeit_Hovercraft/Inventor/hintererAufbau/SkizzenTemp/aussenGrundflaeche.dxf

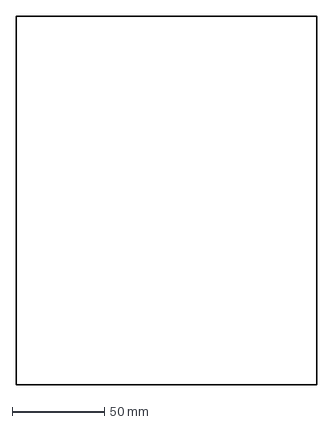
[picture p112: CAD file, 2021-02-12]
Inventor/hintererAufbau/SkizzenTemp/aussenGrundflaeche.dxf
163.1 x 200.0 mm
