StefanD2/Diplomarbeit_Hovercraft/(list of files, cad)

Other CAD files:
Inventor/hintererAufbau/Zeichnungen/HolzServoHalterMainPlatte1.dwg
Inventor/Lenker/Zeichnungen/Mount_Nextion_Display_Main.dwg
Inventor/Bodenplatte/GitterSkizze.dwg
Inventor/Bodenplatte/Zeichnung/40x60Staffel.dwg
Inventor/hintererAufbau/SkizzenTemp/gravurPlatte.dxf
Inventor/hintererAufbau/Zeichnungen/Fahnen_Halter_obenTeileServo.dwg
Inventor/Lenker/Zeichnungen/PlatteGrossLoch.dwg
Inventor/Zeichnungen/Zeichnung_Bodenplatte.dwg
Inventor/Bodenplatte/Zeichnung/HolzLatteLinks.dwg
Inventor/hintererAufbau/Zeichnungen/Fahnen_Halter_hauptteil.dwg
Inventor/Lenker/Zeichnungen/PlatteSeiteLang.dwg
Inventor/MotorhalterungLightBurn/Motorhalterung.dwg
Inventor/Bodenplatte/Zeichnung/Bodenplatte-Holz.dwg
Inventor/hintererAufbau/Zeichnungen/Fahnen_Halter_rechteck.dwg
Inventor/Lenker/Zeichnungen/Bodenplatte.dwg
Inventor/Bodenplatte/Zeichnung/Bodenplatte-XPS.dwg
Inventor/hintererAufbau/Zeichnungen/Spacer_Relay v2.dwg
Inventor/Lenker/Zeichnungen/AdapterLenker.dwg
Inventor/Bodenplatte/Zeichnung/MotorHalterung.dwg
Inventor/hintererAufbau/Zeichnungen/VerstaerkungHintenSchraeg.dwg
Inventor/Lenker/Zeichnungen/M4Gewindestange.dwg
Inventor/Bodenplatte/Zeichnung/HalterungMotorregler.dwg
Inventor/hintererAufbau/Zeichnungen/HalterungServosHochSeitlich.dwg
Inventor/Lenker/Zeichnungen/PlatteSeiteKurz.dwg
Inventor/Bodenplatte/Zeichnung/HolzLatteRechts.dwg
Inventor/hintererAufbau/Zeichnungen/KabelBoxDeckel.dwg
Inventor/Lenker/Zeichnungen/AdapterPoti2.dwg
Inventor/hintererAufbau/Zeichnungen/HolzServoHalterHochLang.dwg
Inventor/Lenker/Zeichnungen/Mount_Nextion_Display_Halter.dwg
Inventor/hintererAufbau/Zeichnungen/VerstaerkungUnten.dwg
Inventor/Lenker/Zeichnungen/Mount_Nextion_Display_Deckel.dwg
Inventor/hintererAufbau/Zeichnungen/VerstaerkungHintenUnten.dwg
Inventor/Lenker/Zeichnungen/PotiHalterungUnten.dwg
Inventor/hintererAufbau/Zeichnungen/VerstaerkungHintenMitte.dwg
Inventor/Lenker/Zeichnungen/StangeMitte.dwg
Inventor/hintererAufbau/Zeichnungen/KabelBoxPlatteLang.dwg
Inventor/Lenker/Zeichnungen/AdapterPoti1.dwg
Inventor/hintererAufbau/Zeichnungen/HolzServoHalterHinten.dwg
Inventor/hintererAufbau/Zeichnungen/HalterungServoHochSeitlich2.dwg
Inventor/hintererAufbau/Zeichnungen/KabelBoxPlatteKurz.dwg
Inventor/hintererAufbau/Zeichnungen/aussenOben.dwg
Inventor/hintererAufbau/Zeichnungen/PlatteAußenGross.dwg
Inventor/hintererAufbau/Zeichnungen/PlatteInnenEineSeite.dwg
Inventor/hintererAufbau/Zeichnungen/PlatteInnenzweiSeiten.dwg
Inventor/hintererAufbau/Zeichnungen/FahneHolz.dwg
Inventor/hintererAufbau/Zeichnungen/PlatteAussenEineSeite.dwg
Inventor/hintererAufbau/Zeichnungen/PlatteAussenZweiSeiten.dwg
Inventor/hintererAufbau/Zeichnungen/InnenUnten.dwg
Inventor/hintererAufbau/Zeichnungen/Hauptplatte.dwg
Inventor/3D-Druck/Adapter_Lenker v4.f3d
Inventor/3D-Druck/Adapter_Lenker v4.ipt
Inventor/3D-Druck/Fahnen_Halter v12.f3d
Inventor/3D-Druck/Fahnen_Halter v12.ipt
Inventor/3D-Druck/Fahnen_Halter_hauptteil.ipt
Inventor/3D-Druck/Fahnen_Halter_obenTeileServo.ipt
Inventor/3D-Druck/Fahnen_Halter_oben_v2 v20.f3d
Inventor/3D-Druck/Fahnen_Halter_oben_v2 v20.ipt
Inventor/3D-Druck/Fahnen_Halter_rechteck.ipt
Inventor/3D-Druck/Mount_Nextion_Display v32.f3d
Inventor/3D-Druck/Mount_Nextion_Display v32.ipt
Inventor/3D-Druck/Mount_Nextion_Display_Deckel.ipt
Inventor/3D-Druck/Mount_Nextion_Display_Halter.ipt
Inventor/3D-Druck/Mount_Nextion_Display_Main.ipt
Inventor/3D-Druck/Regler_Halter_Hinten v9.f3d
Inventor/3D-Druck/Regler_Halter_Hinten v9.ipt
Inventor/3D-Druck/Spacer_Relay v2.f3d
Inventor/3D-Druck/Spacer_Relay v2.ipt
Inventor/Aufbau.ipt
Inventor/Bauteil1.ipt
Inventor/Bodenplatte/40x60Staffel.ipt
Inventor/Bodenplatte/Bodenplatte-Holz.ipt
Inventor/Bodenplatte/Bodenplatte.iam
Inventor/Bodenplatte/Gitter.ipt
Inventor/Bodenplatte/HalterungMotorregler.ipt
Inventor/Bodenplatte/HolzLatteLinks.ipt
Inventor/Bodenplatte/HolzPlatterechts.ipt
Inventor/Bodenplatte/MotorHalterung.ipt
Inventor/Bodenplatte/XPS.ipt
Inventor/BodenplatteXPS.ipt
Inventor/FahenVerbindung_maybe.ipt
Inventor/FahneHolz.ipt
Inventor/Fahnen_Halter v8.ipt
Inventor/Fahnen_Halter v8_1.ipt
Inventor/Fahnenhalter.ipt
Inventor/FahnenhalterTeiloben.ipt
Inventor/GitterUnten.ipt
Inventor/Lenker/AdapterPoti2.ipt
Inventor/Lenker/Lenkung.iam
Inventor/Lenker/M4Gewindestange.ipt
Inventor/Lenker/ONLY_Inventor_inv1.ipt
Inventor/Lenker/Platte1.ipt
Inventor/Lenker/Platte2-Seite.ipt
Inventor/Lenker/Platte3-Seite.ipt
Inventor/Lenker/Platte4.ipt
Inventor/Lenker/Poti-RK09712_0-L15.ipt
Inventor/Lenker/PotiHalterungUnten.ipt
Inventor/Lenker/Stange1Mitte.ipt
Inventor/Lenker/StangePotiAdapter1.ipt
Inventor/Lenker/model v1.ipt
Inventor/Lenker/stl/KoplungLenkerOben.ipt
Inventor/Lenkung.ipt
Inventor/LenkungHinten.ipt
Inventor/LenkungHinten_mitte.ipt
Inventor/Lenkung_hinten_verbindung.ipt
Inventor/Lenkung_verbindung.ipt
Inventor/Lenkung_vorne.ipt
Inventor/Luftkissenboot.iam
Inventor/Motor.ipt
Inventor/MotorhalterungLightBurn/MotorhalterungV2.dwg
Inventor/Praesentation/Bodenplatte.ipn
Inventor/Praesentation/hintererAufbau.ipn
Inventor/Propeller.ipt
Inventor/PropellerBohrungenVorlageLightBurn/PropellerBohrungen.dwg
Inventor/Schlauchoot.ipt
Inventor/Servo.ipt
Inventor/Winkelverbinder-70x70x50.ipt
Inventor/XPS-Hinten.ipt
Inventor/hintererAufbau/FahneHolz.ipt
Inventor/hintererAufbau/HalterungServoHochSeitlich2.ipt
Inventor/hintererAufbau/HalterungServosHochSeitlich.ipt
Inventor/hintererAufbau/Hauptplatte.ipt
Inventor/hintererAufbau/HolzServoHalterHinten.ipt
Inventor/hintererAufbau/HolzServoHalterHochLang.ipt
Inventor/hintererAufbau/HolzServoHalterMainPlatte1.ipt
Inventor/hintererAufbau/InnenUnten.ipt
Inventor/hintererAufbau/InventorOnlyInvisibleSchanierl.ipt
Inventor/hintererAufbau/KabelBoxDeckel.ipt
Inventor/hintererAufbau/KabelBoxPlatteKurz.ipt
Inventor/hintererAufbau/KabelBoxPlatteLang.ipt
Inventor/hintererAufbau/PlatteAussenEineSeite.ipt
Inventor/hintererAufbau/PlatteAussenZweiSeiten.ipt
Inventor/hintererAufbau/PlatteAußenGross.ipt
Inventor/hintererAufbau/PlatteInnenEineSeite.ipt
Inventor/hintererAufbau/PlatteInnenzweiSeiten.ipt
Inventor/hintererAufbau/VerstaerkungHintenMitte.ipt
Inventor/hintererAufbau/VerstaerkungHintenSchraeg.ipt
Inventor/hintererAufbau/VerstaerkungHintenUnten.ipt
Inventor/hintererAufbau/VerstaerkungUnten.ipt
Inventor/hintererAufbau/aussenOben.ipt
Inventor/hintererAufbau/hintererAufbau.iam
