StefanD2/Diplomarbeit_Hovercraft/Doku/Textparts/Stoeger/Anleitung/Anleitung.tex

\begin{enumerate}
    \item Not-Aus--Schalter entriegeln
    \item Starttaster gedrückt halten, bis man das Klicken des Hauptrelais hört
    \item Fahrspaß genießen:
    \begin{itemize}
        \item rechter Daumengashebel: Auftrieb
        \item linker Daumengashebel: Vorschub
    \end{itemize}
    \item Verzögerungsvorgang: Vorschub abdrehen und Reibung durch Verringerung des Auftriebs erhöhen
    \item Not-Aus--Schalter drücken, um das Hovercraft ganz abzuschalten
\end{enumerate}
