StefanD2/Diplomarbeit_Hovercraft/Doku/Textparts/Eilmsteiner/Boardelektronik/bilder/platformio_installation_cmd.png

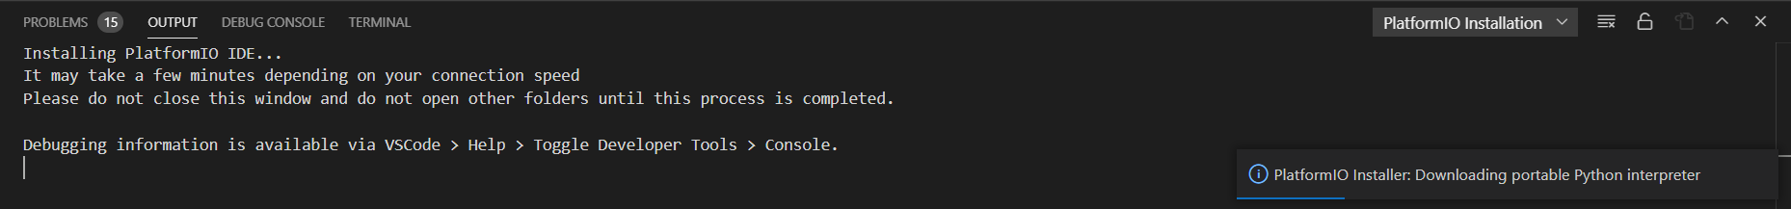
Doku/Textparts/Eilmsteiner/Boardelektronik/bilder/platformio_installation_cmd.png
