StefanD2/Diplomarbeit_Hovercraft/Inventor/hintererAufbau/png/Einzelteile/Hauptplatte.png

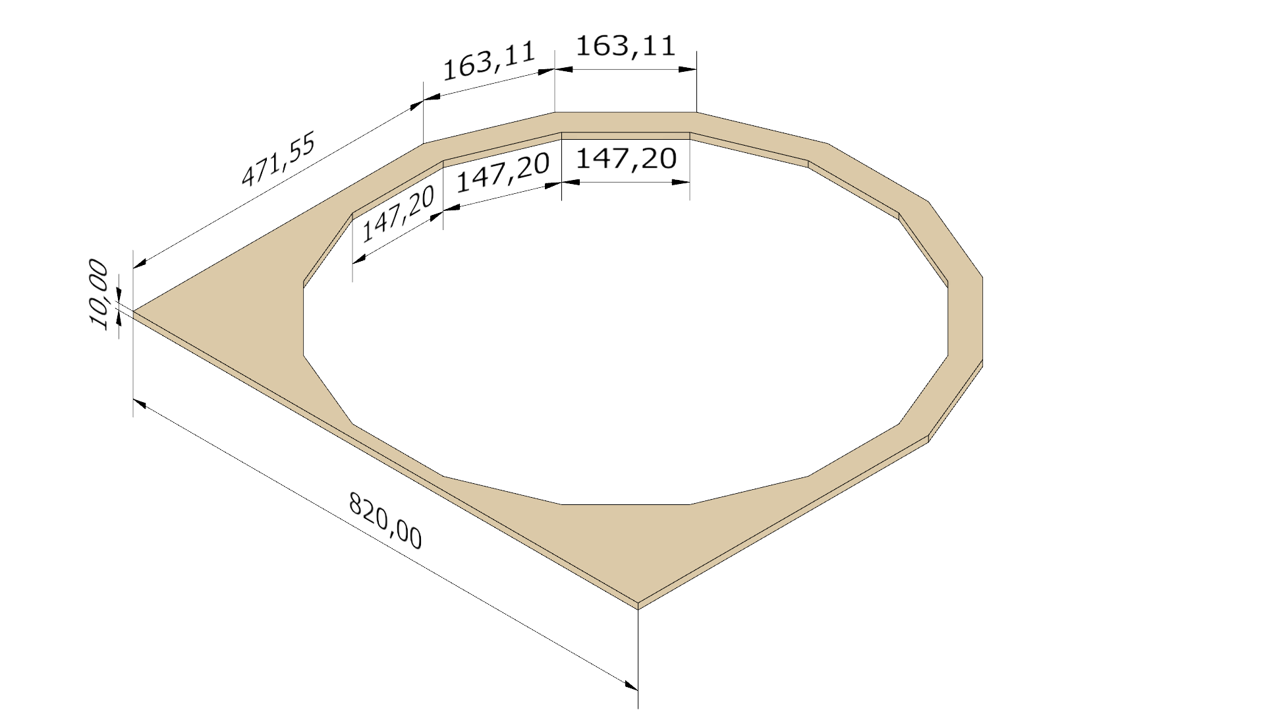
Inventor/hintererAufbau/png/Einzelteile/Hauptplatte.png
