StefanD2/Diplomarbeit_Hovercraft/Inventor/hintererAufbau/png/hintererAufbau.png

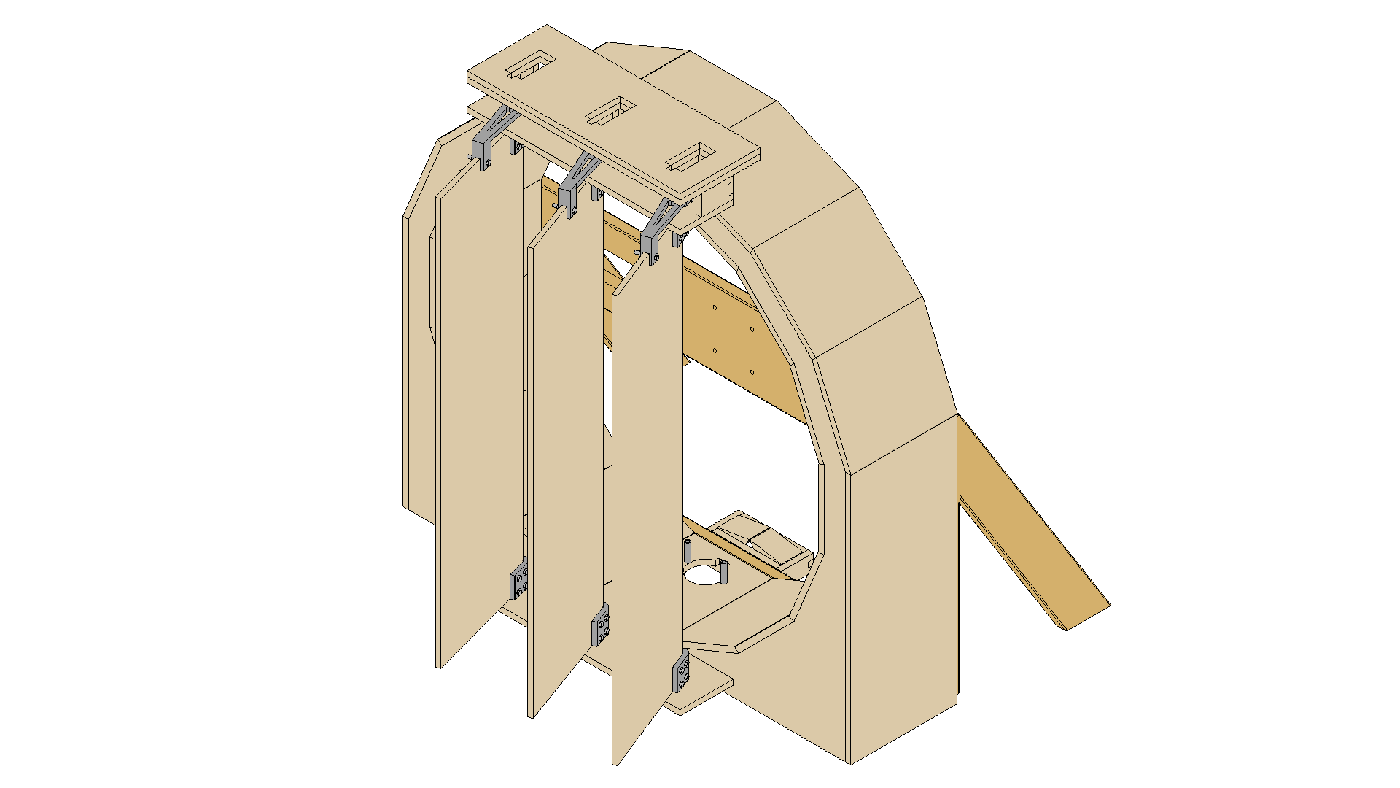
Inventor/hintererAufbau/png/hintererAufbau.png
