StefanD2/Diplomarbeit_Hovercraft/Inventor/hintererAufbau/png/hintererAufbau_hauptansicht.png

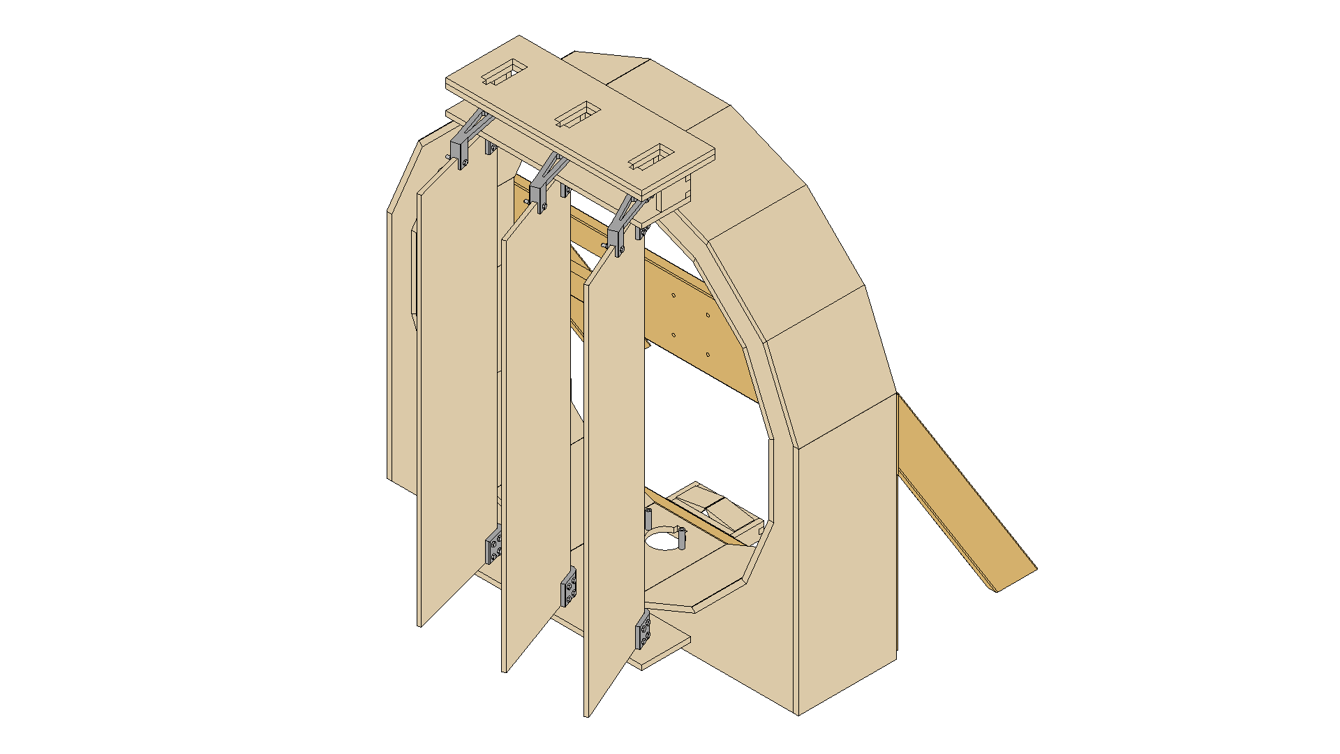
Inventor/hintererAufbau/png/hintererAufbau_hauptansicht.png
