StefanD2/Diplomarbeit_Hovercraft/Inventor/hintererAufbau/png/hintererAufbau_hinten.png

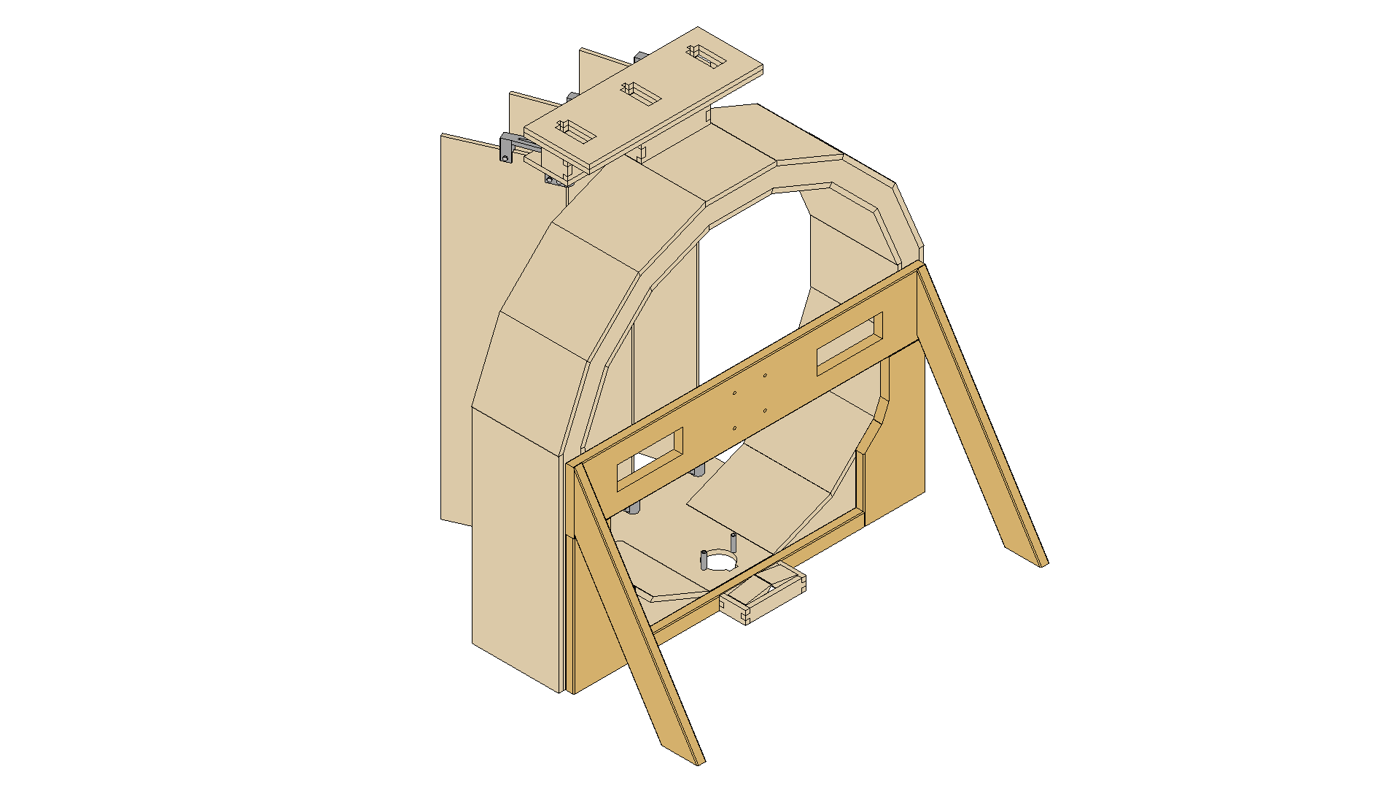
Inventor/hintererAufbau/png/hintererAufbau_hinten.png
