StefanD2/Diplomarbeit_Hovercraft/Inventor/hintererAufbau/png/hintererAufbau_hintenOben.png

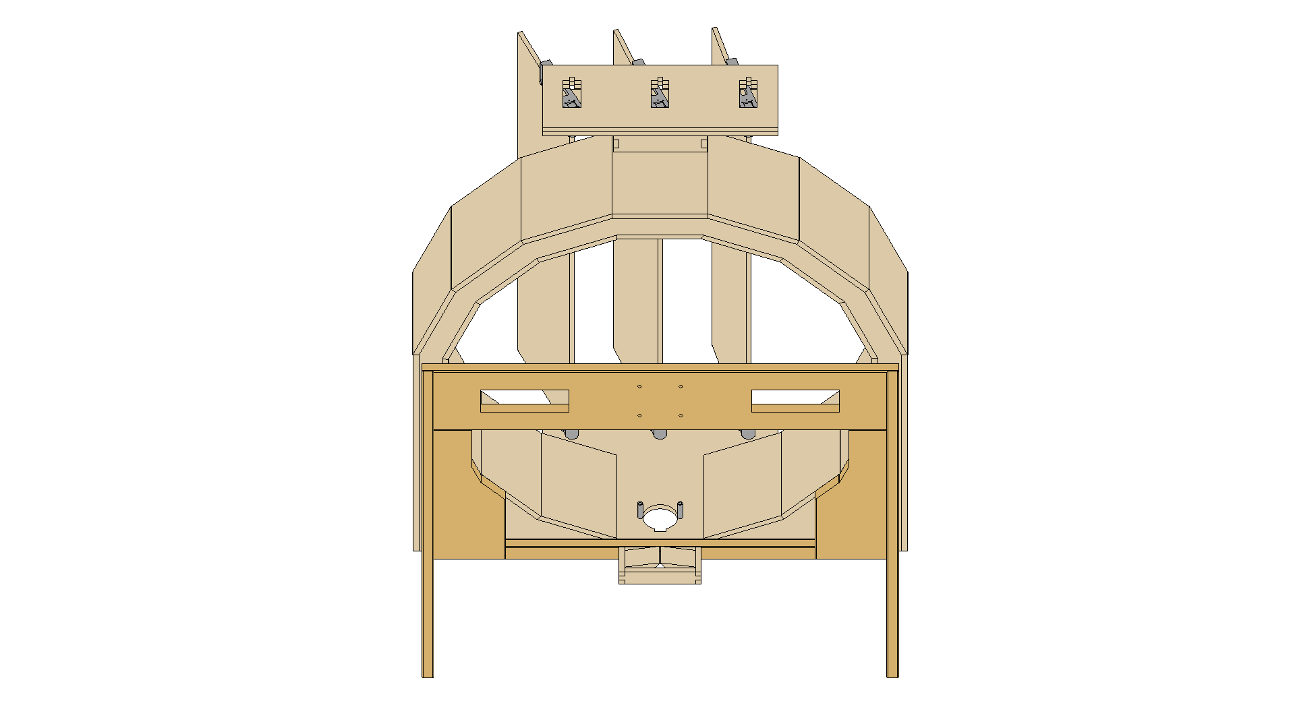
Inventor/hintererAufbau/png/hintererAufbau_hintenOben.png
