StefanD2/Diplomarbeit_Hovercraft/Inventor/hintererAufbau/Zeichnungen/Spacer_Relay v2.pdf

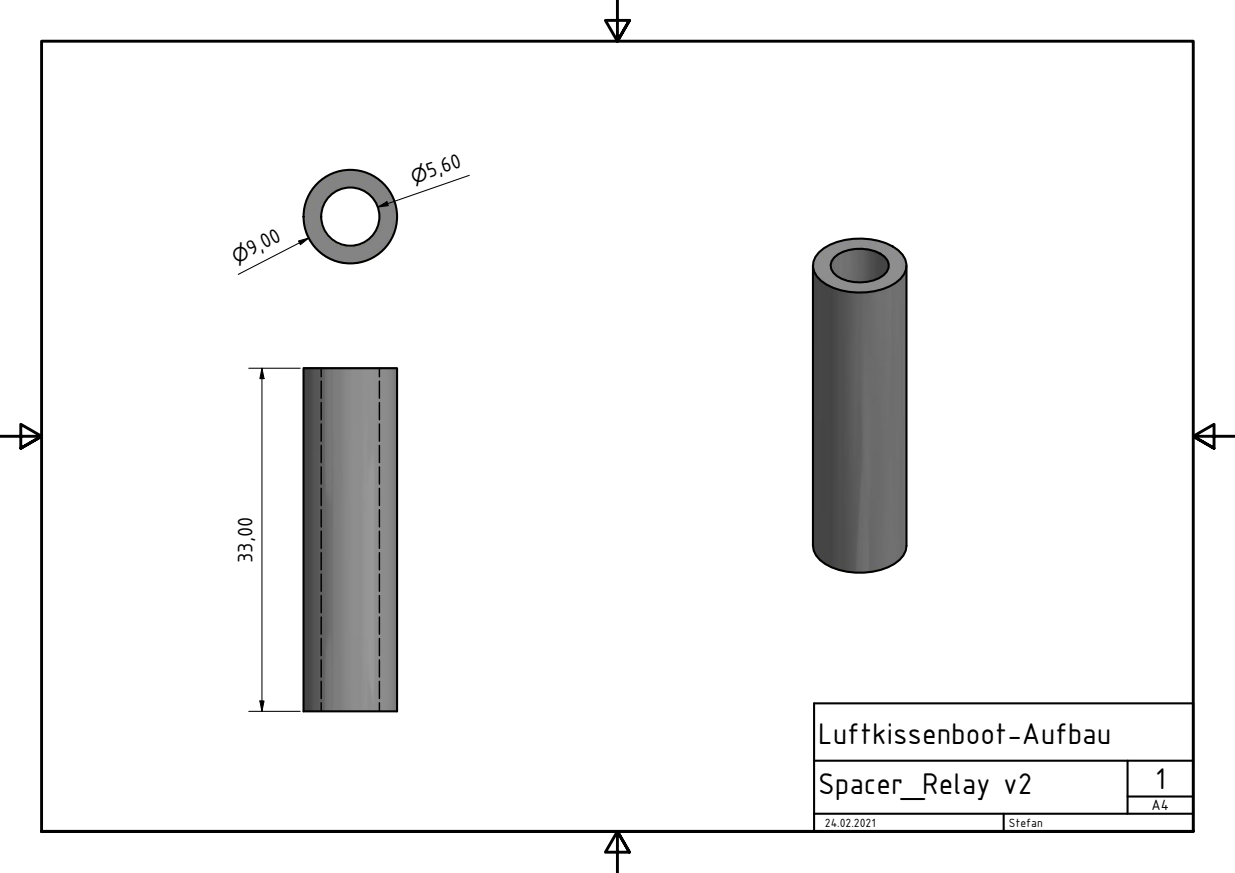
[picture p123: page 1]
Spacer_Relay v2
