StefanD2/Diplomarbeit_Hovercraft/Inventor/hintererAufbau/Zeichnungen/Fahnen_Halter_hauptteil.pdf

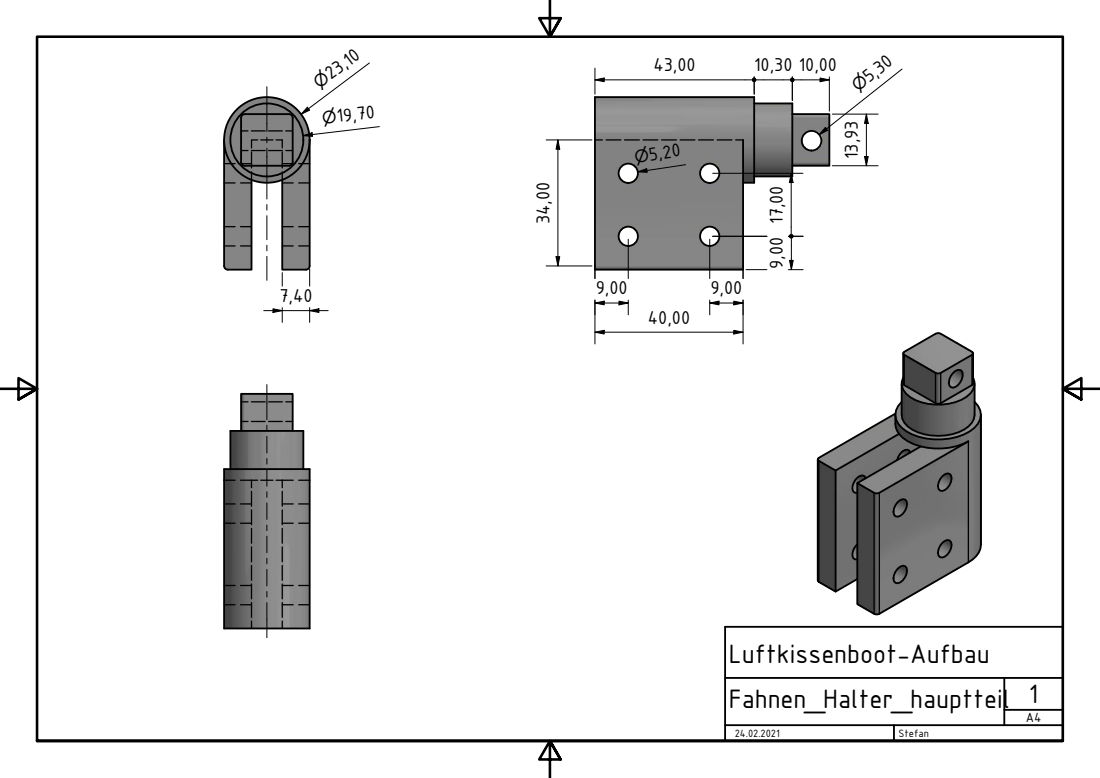
[picture p124: page 1]
