StefanD2/Diplomarbeit_Hovercraft/Inventor/hintererAufbau/Zeichnungen/Fahnen_Halter_obenTeileServo.pdf

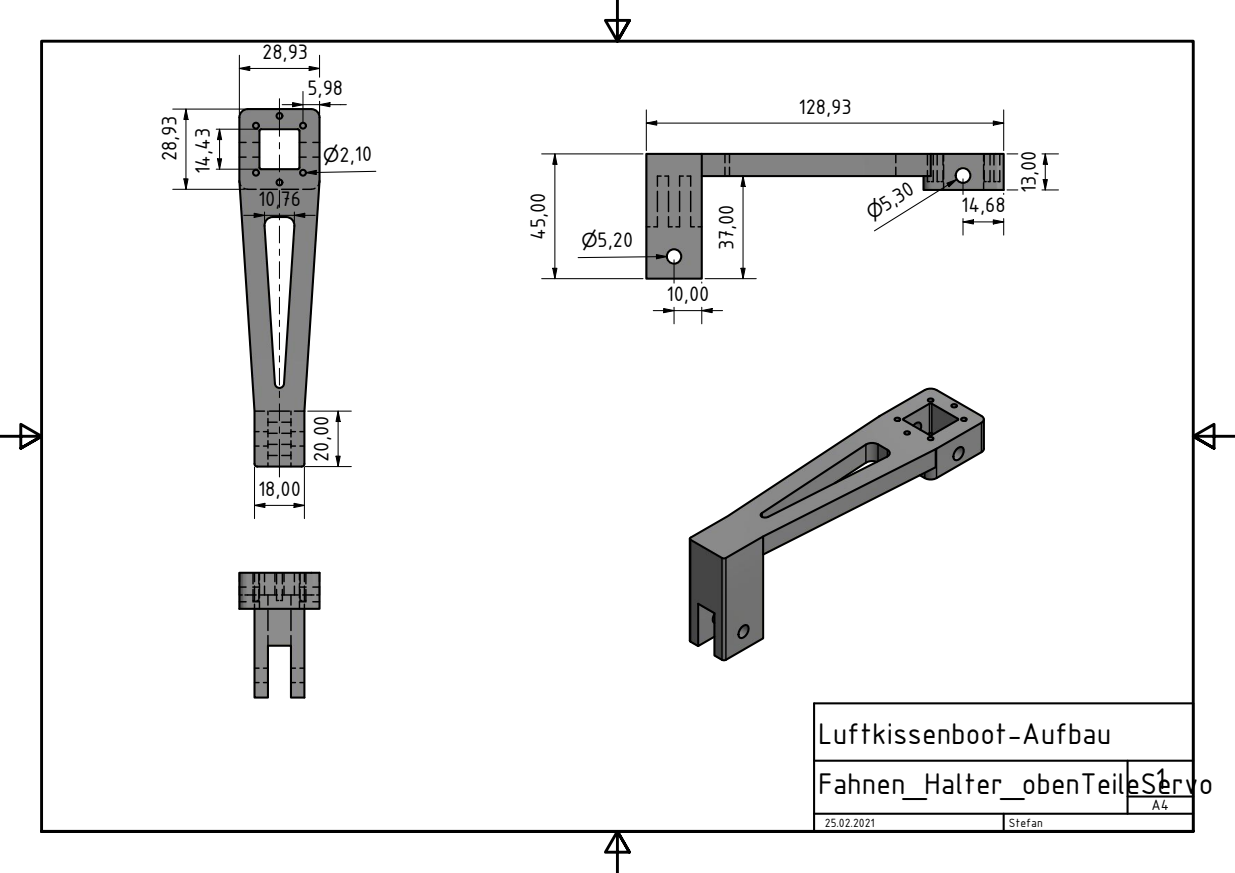
[picture p125: page 1]
