StefanD2/Diplomarbeit_Hovercraft/Inventor/hintererAufbau/Zeichnungen/Fahnen_Halter_rechteck.pdf

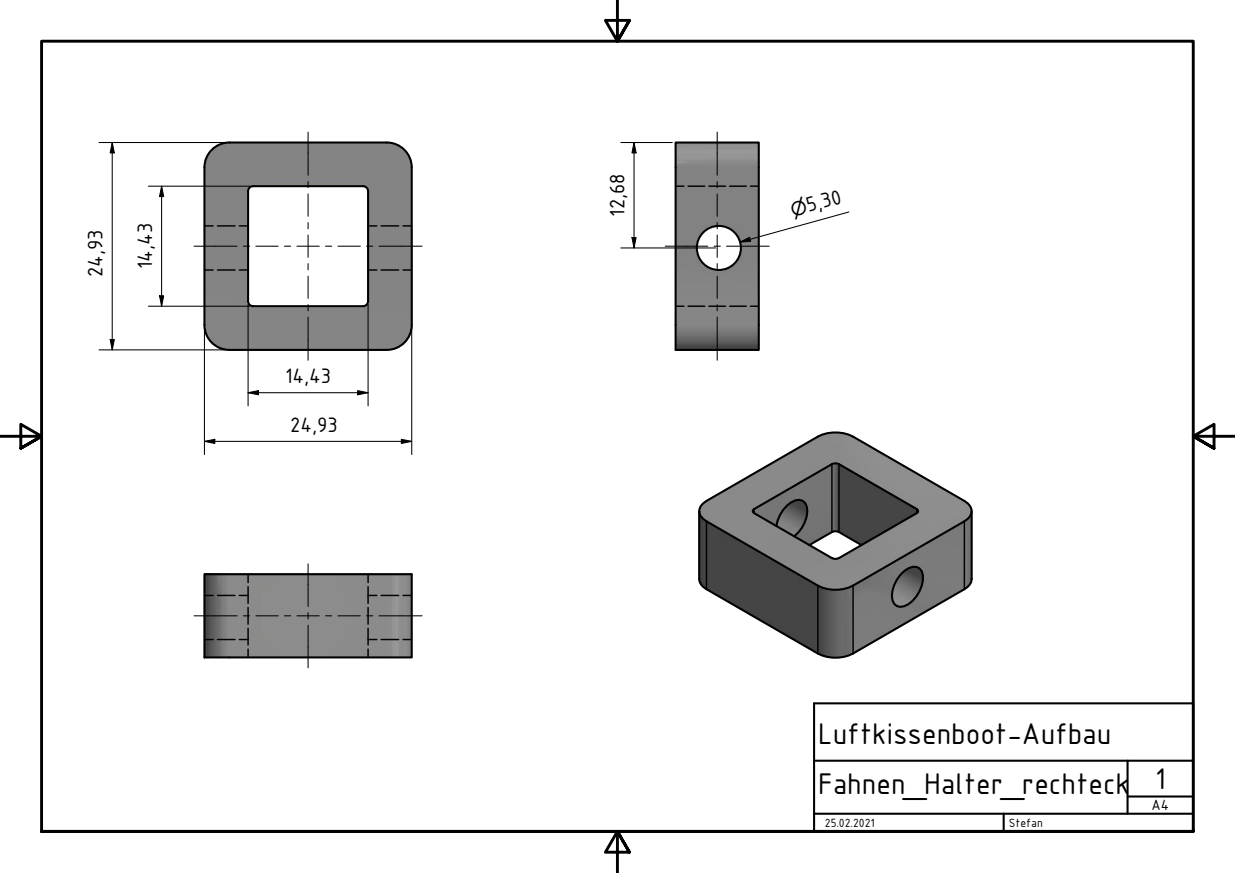
[picture p126: page 1]
