StefanD2/Diplomarbeit_Hovercraft/Inventor/hintererAufbau/Zeichnungen/HalterungServoHochSeitlich2.pdf

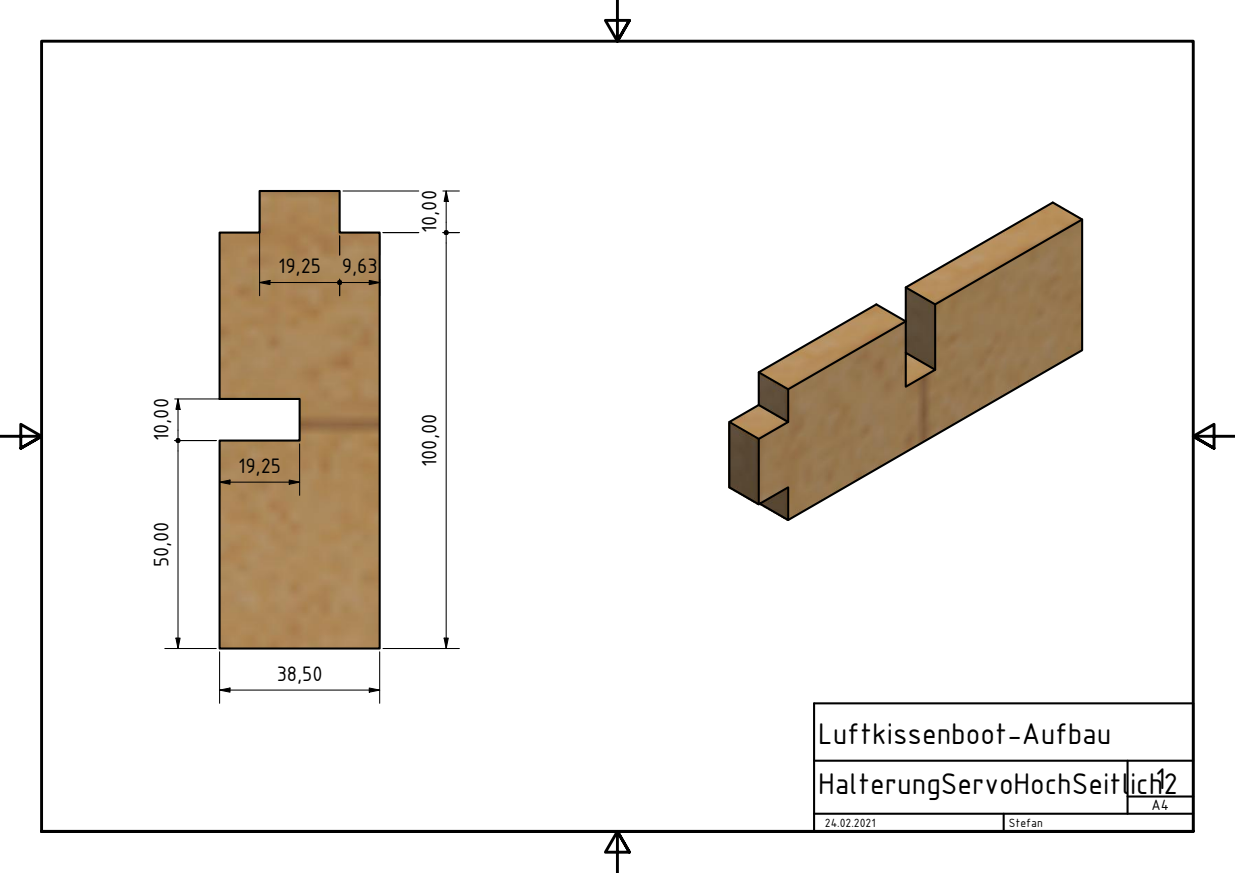
[picture p127: page 1]
