StefanD2/Diplomarbeit_Hovercraft/Inventor/hintererAufbau/Zeichnungen/HalterungServosHochSeitlich.pdf

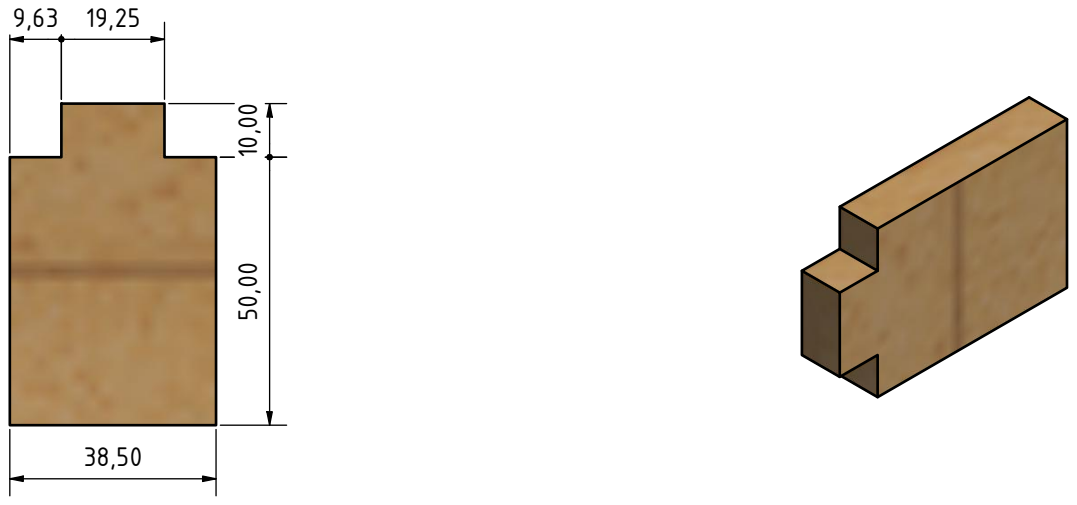
[picture p128: page 1]
