StefanD2/Diplomarbeit_Hovercraft/Inventor/hintererAufbau/Zeichnungen/HolzServoHalterHinten.pdf

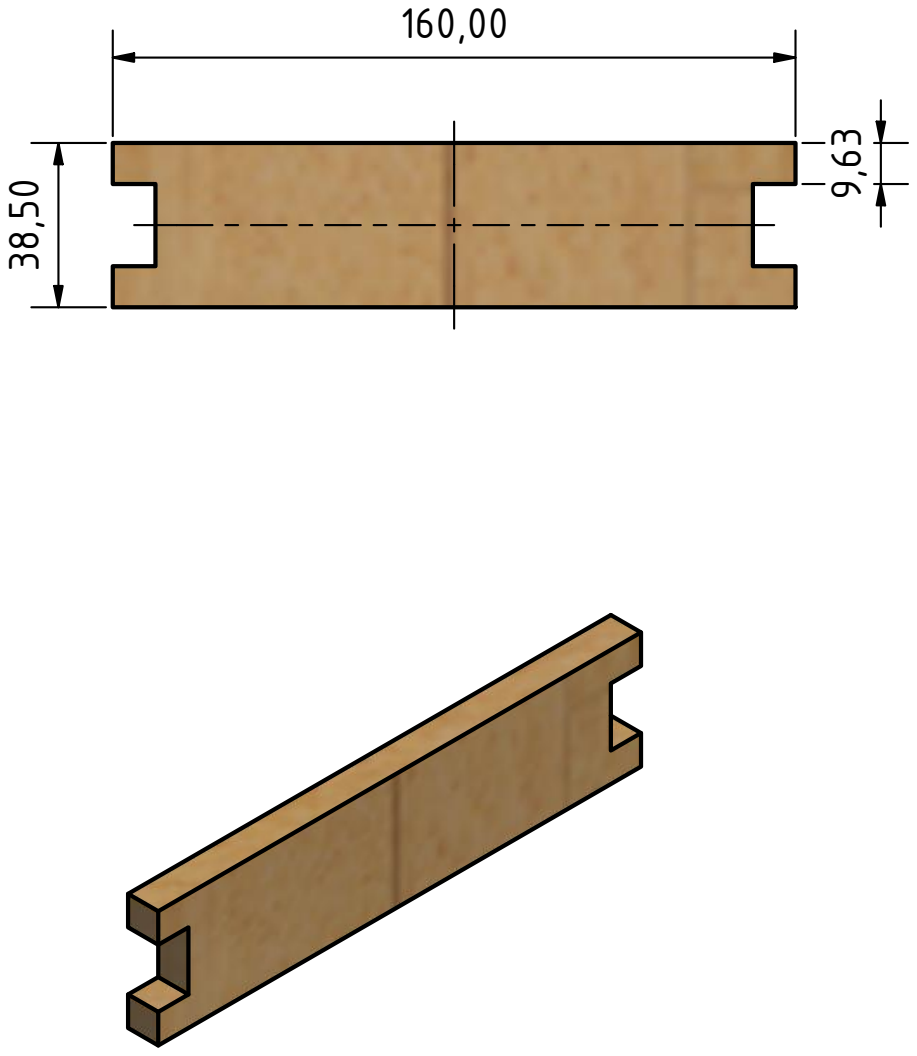
[picture p129: page 1]
