StefanD2/Diplomarbeit_Hovercraft/Inventor/hintererAufbau/Zeichnungen/HolzServoHalterHochLang.pdf

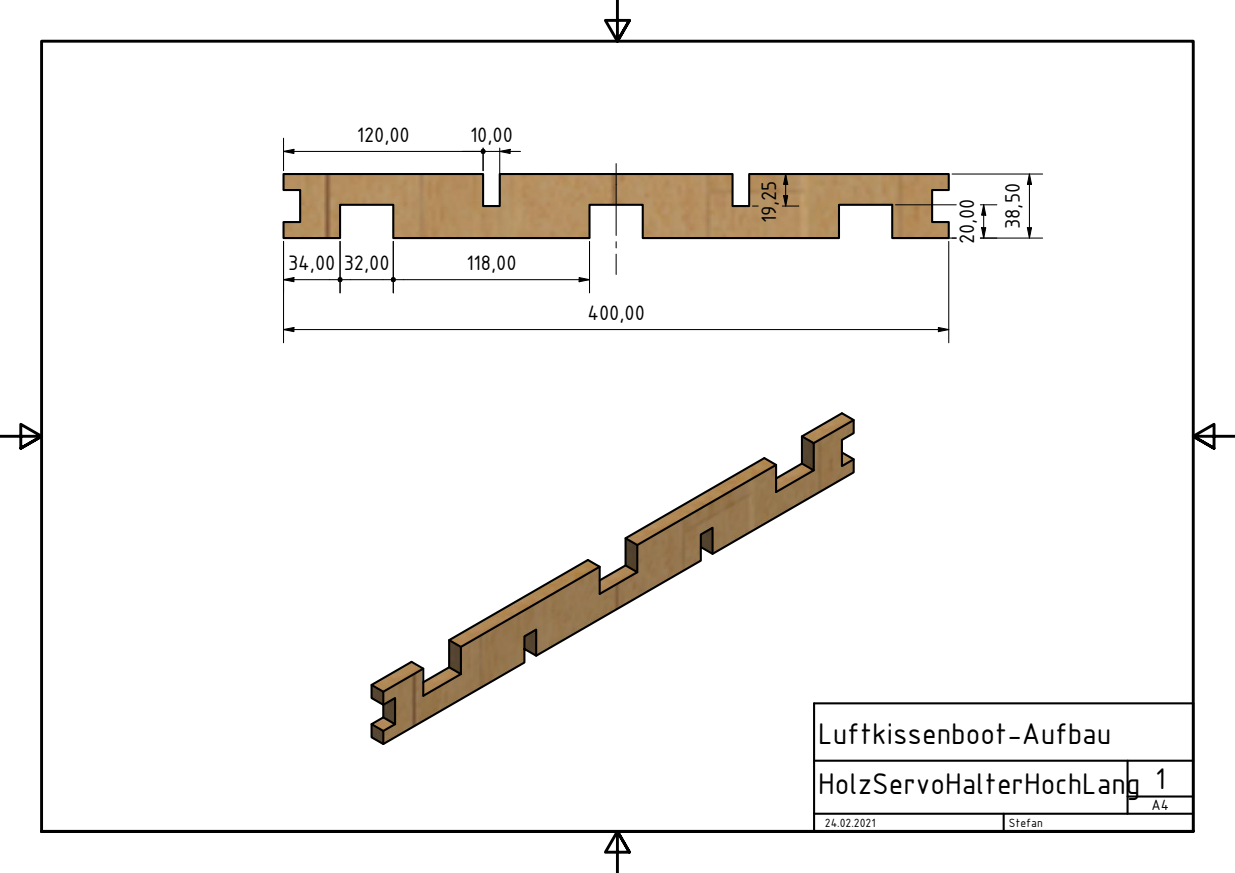
[picture p130: page 1]
