StefanD2/Diplomarbeit_Hovercraft/Inventor/hintererAufbau/Zeichnungen/HolzServoHalterMainPlatte1.pdf

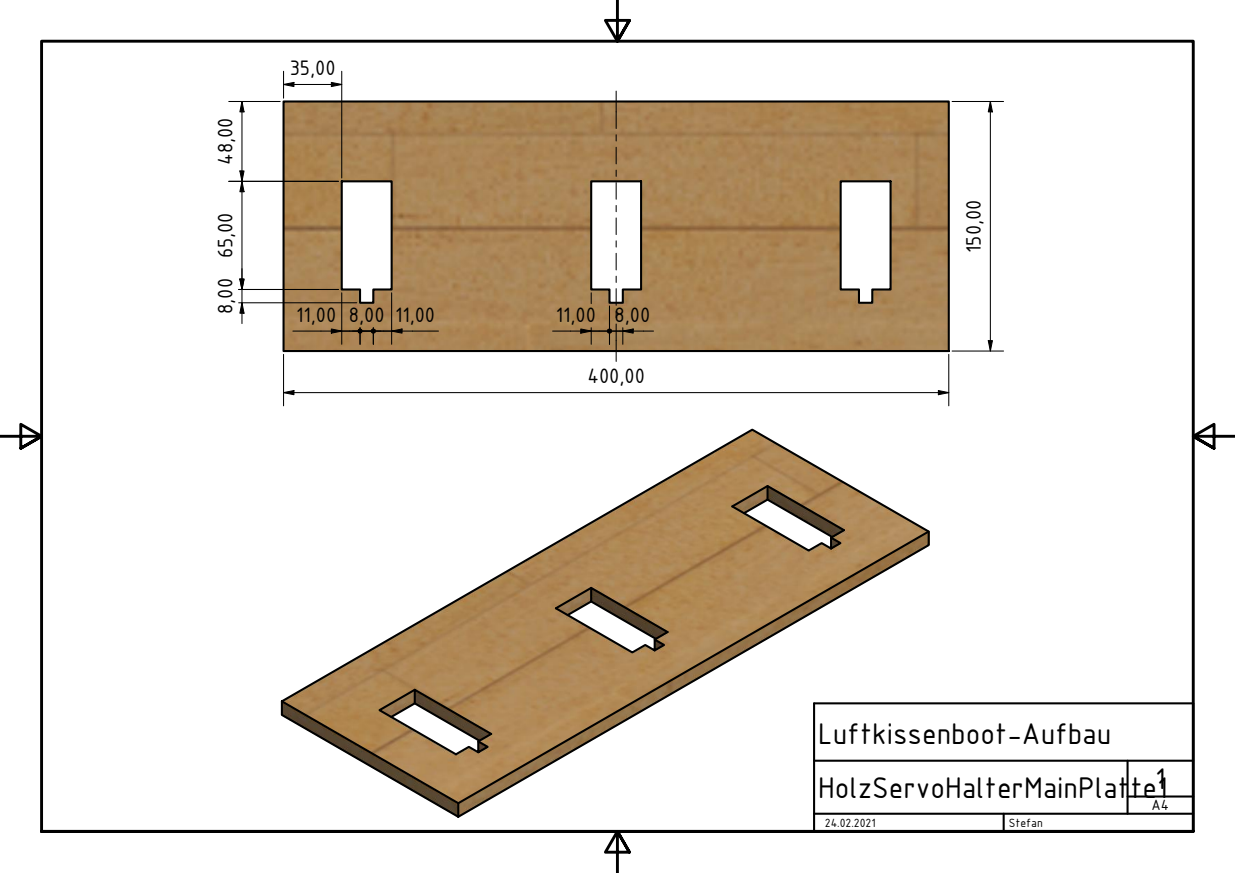
[picture p131: page 1]
