StefanD2/Diplomarbeit_Hovercraft/Inventor/hintererAufbau/Zeichnungen/KabelBoxDeckel.pdf

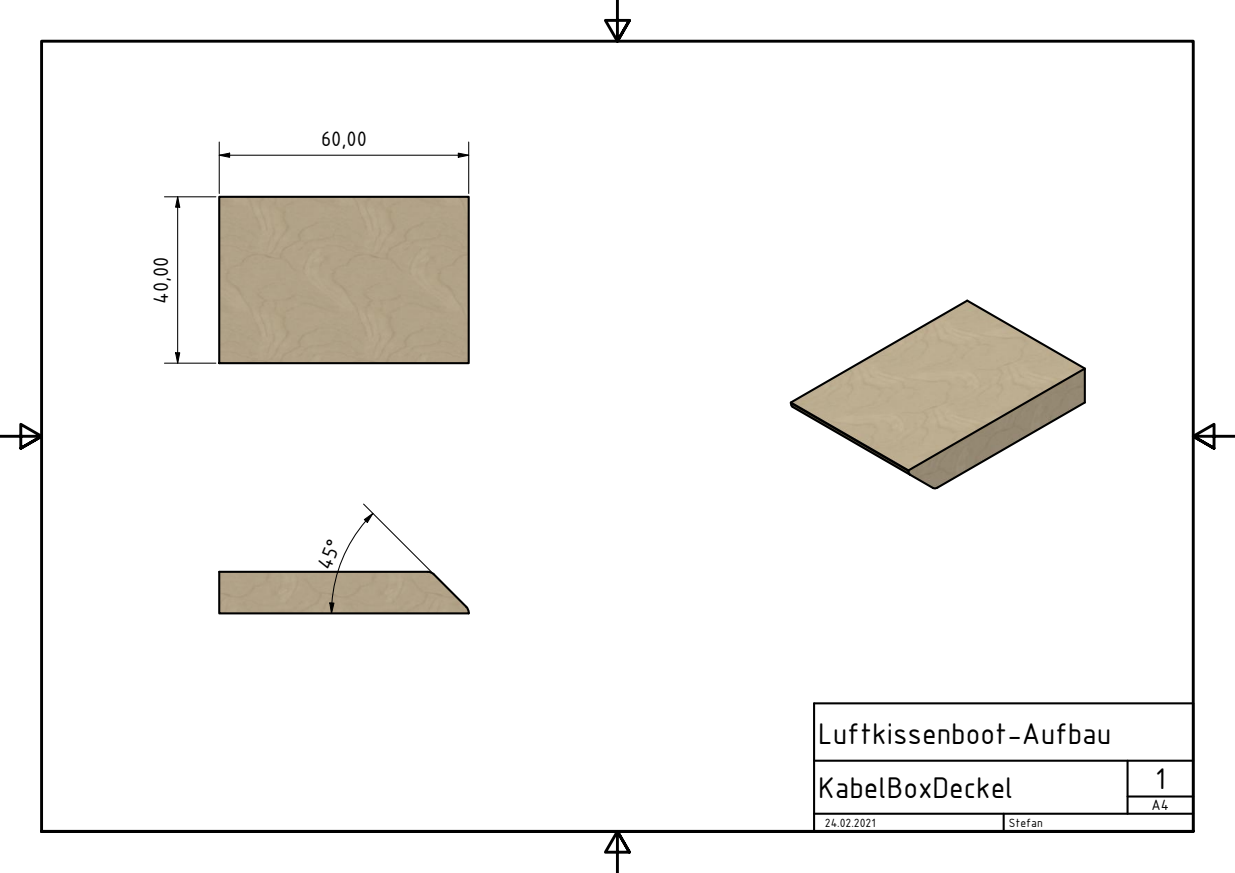
[picture p132: page 1]
