StefanD2/Diplomarbeit_Hovercraft/Inventor/hintererAufbau/Zeichnungen/KabelBoxPlatteKurz.pdf

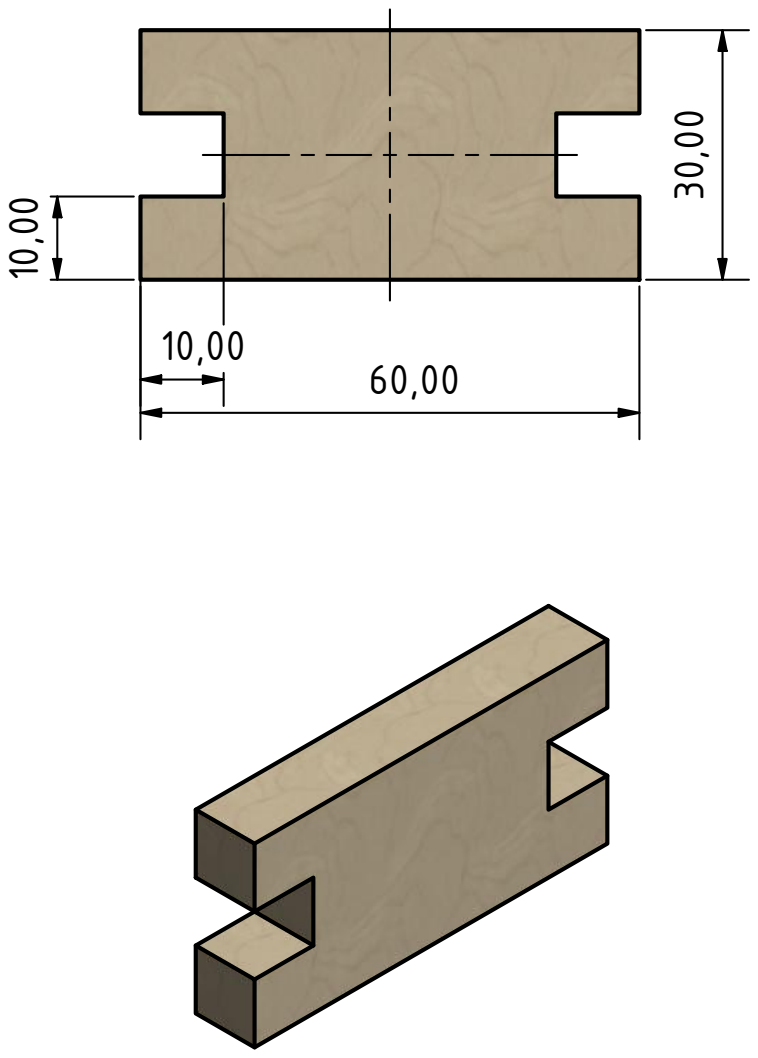
[picture p133: page 1]
