StefanD2/Diplomarbeit_Hovercraft/Inventor/hintererAufbau/Zeichnungen/KabelBoxPlatteLang.pdf

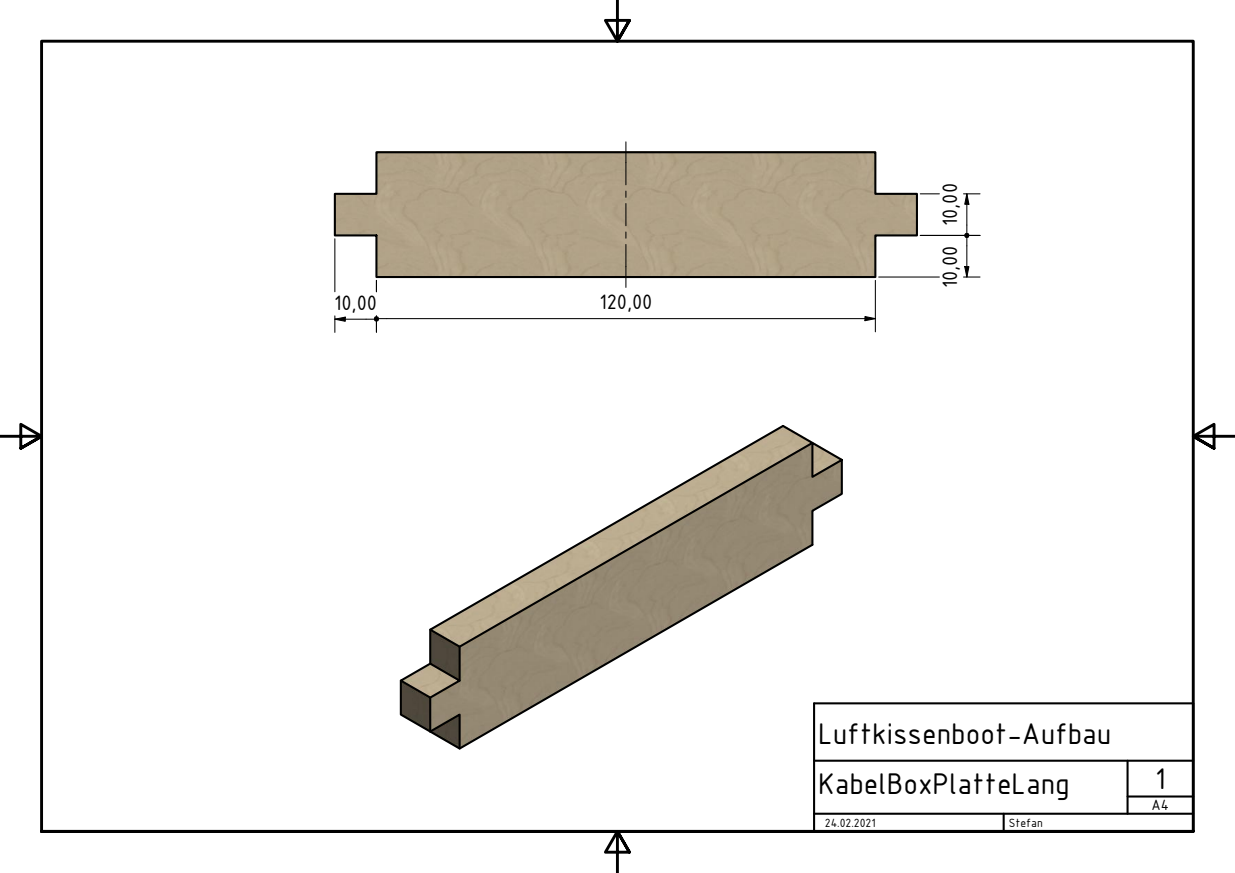
[picture p134: page 1]
