StefanD2/Diplomarbeit_Hovercraft/Inventor/hintererAufbau/Zeichnungen/VerstaerkungHintenMitte.pdf

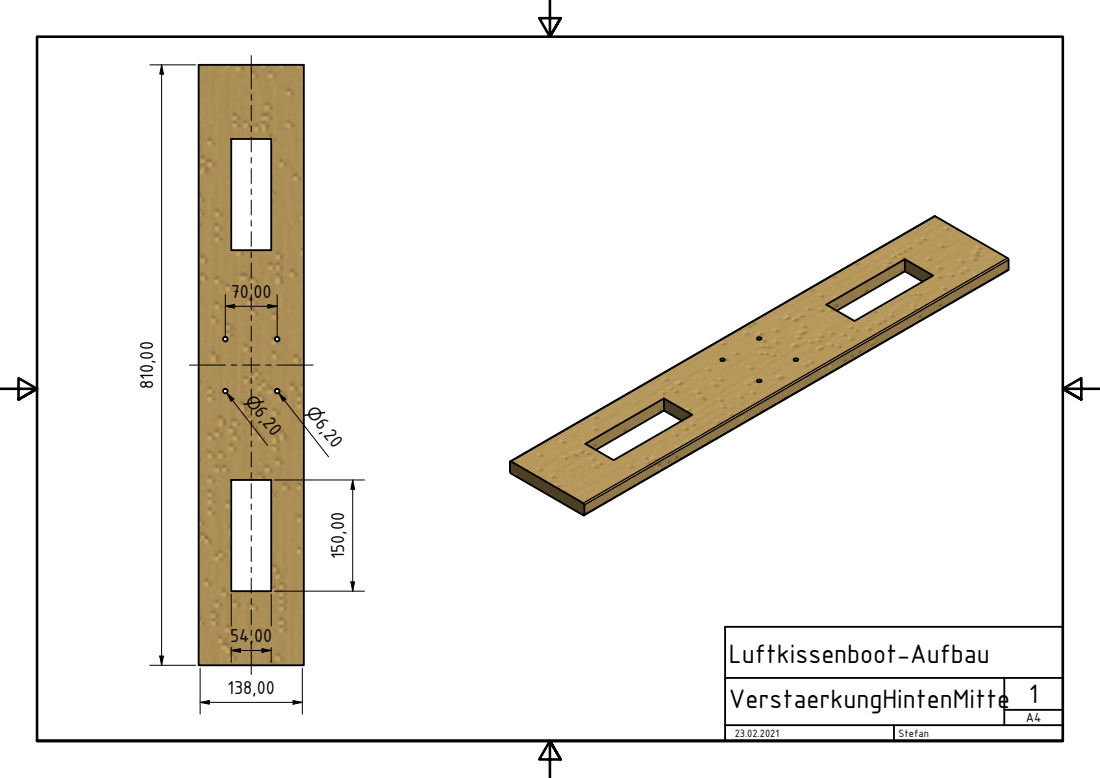
[picture p135: page 1]
