StefanD2/Diplomarbeit_Hovercraft/Inventor/hintererAufbau/Zeichnungen/VerstaerkungHintenSchraeg.pdf

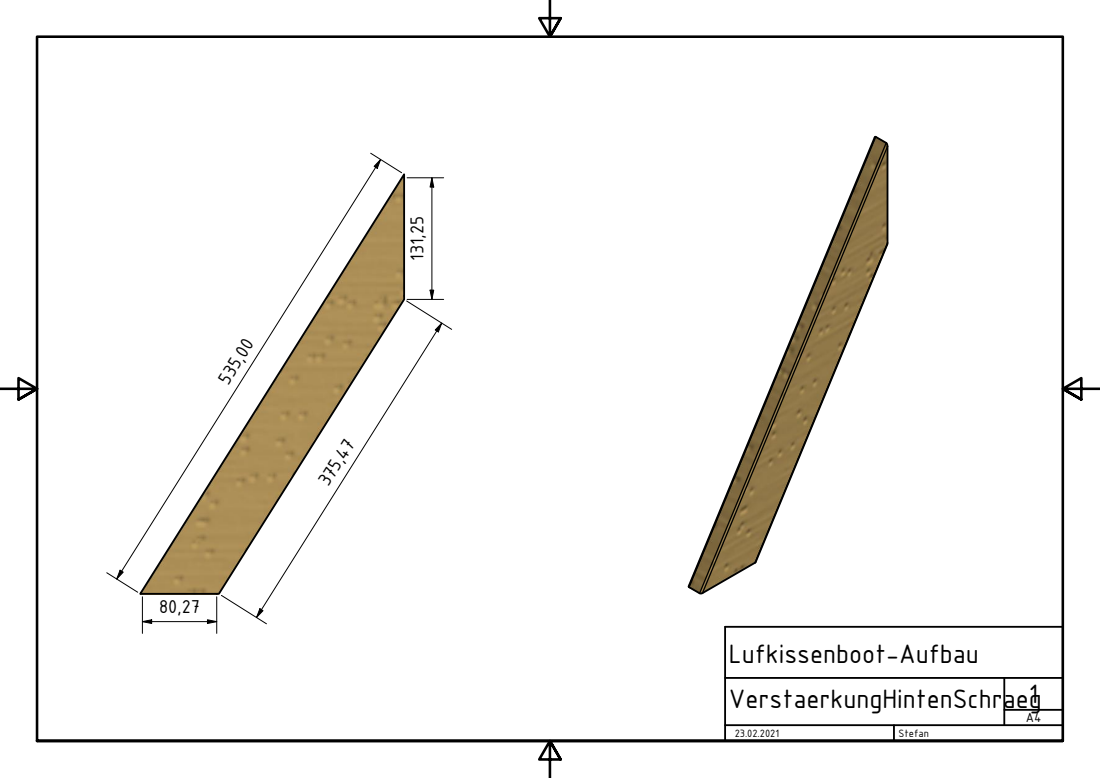
[picture p136: page 1]
