StefanD2/Diplomarbeit_Hovercraft/Inventor/hintererAufbau/Zeichnungen/VerstaerkungHintenUnten.pdf

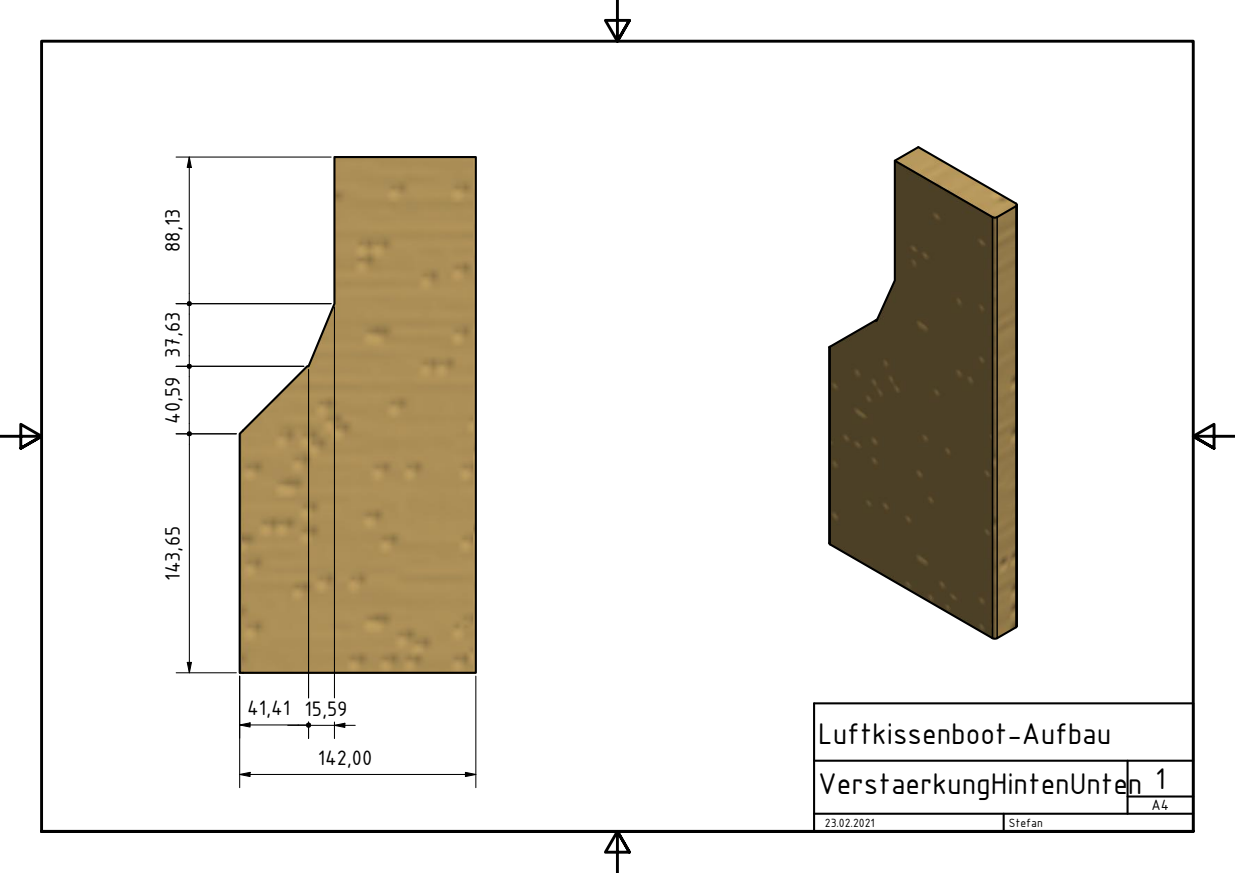
[picture p137: page 1]
