StefanD2/Diplomarbeit_Hovercraft/Inventor/hintererAufbau/Zeichnungen/VerstaerkungUnten.pdf

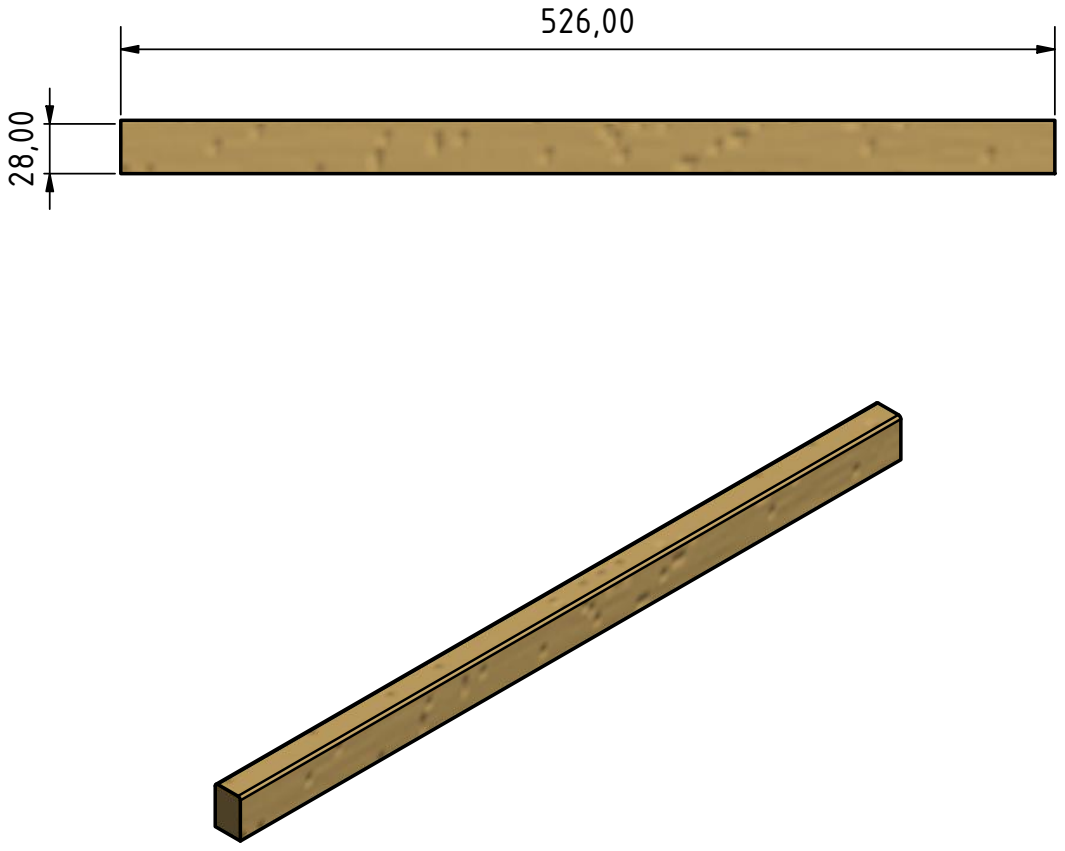
[picture p138: page 1]
