StefanD2/Diplomarbeit_Hovercraft/Inventor/hintererAufbau/Zeichnungen/aussenOben.pdf

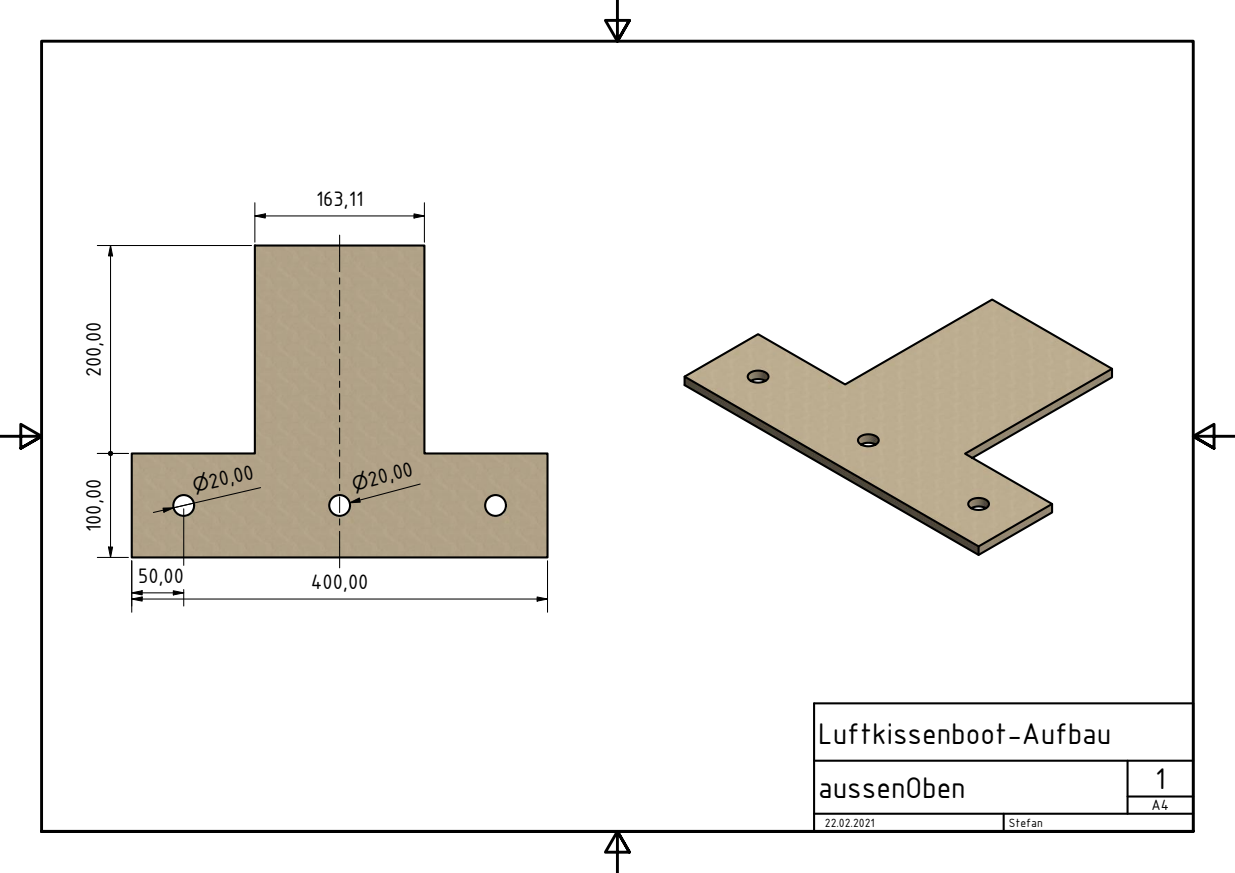
[picture p139: page 1]
