StefanD2/Diplomarbeit_Hovercraft/Inventor/hintererAufbau/Zeichnungen/FahneHolz.pdf

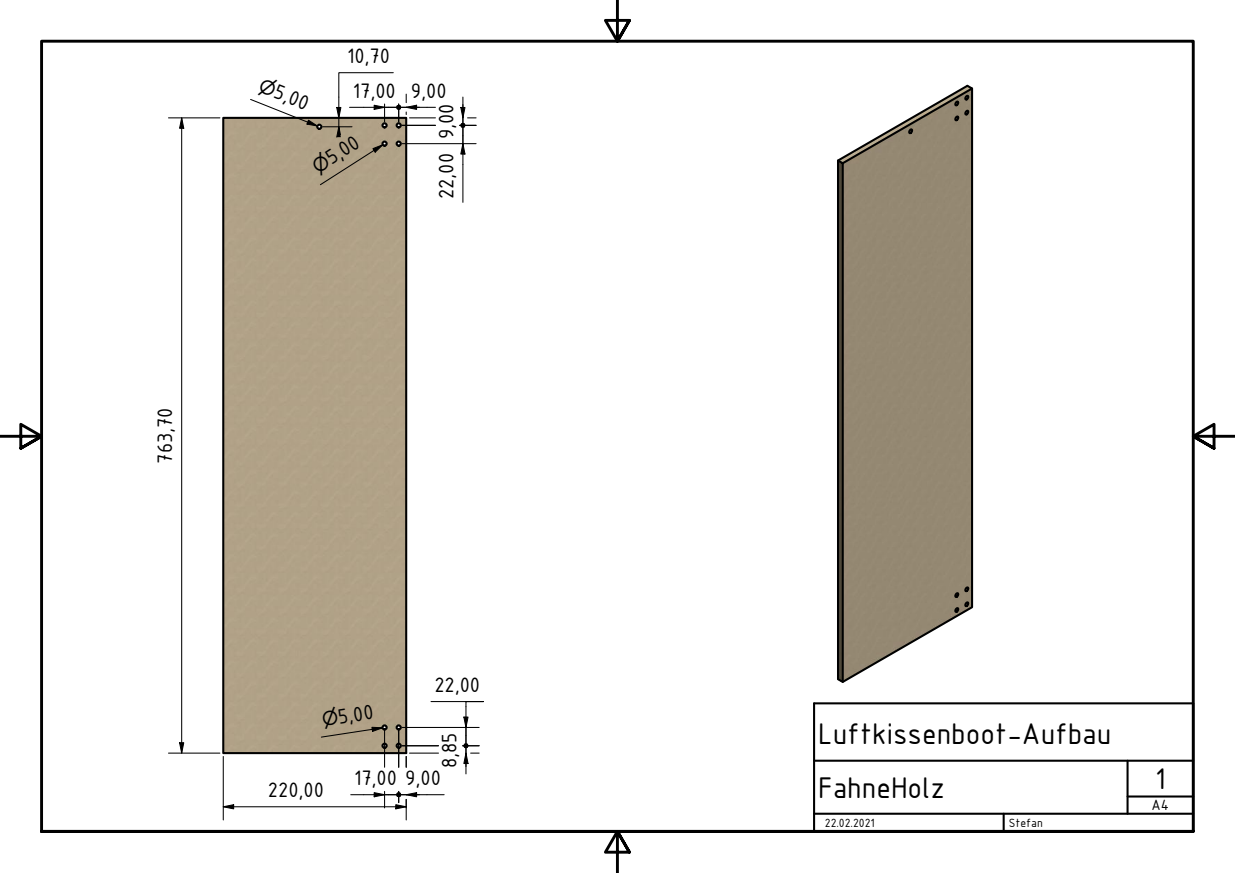
[picture p140: page 1]
