StefanD2/Diplomarbeit_Hovercraft/Inventor/hintererAufbau/Zeichnungen/InnenUnten.pdf

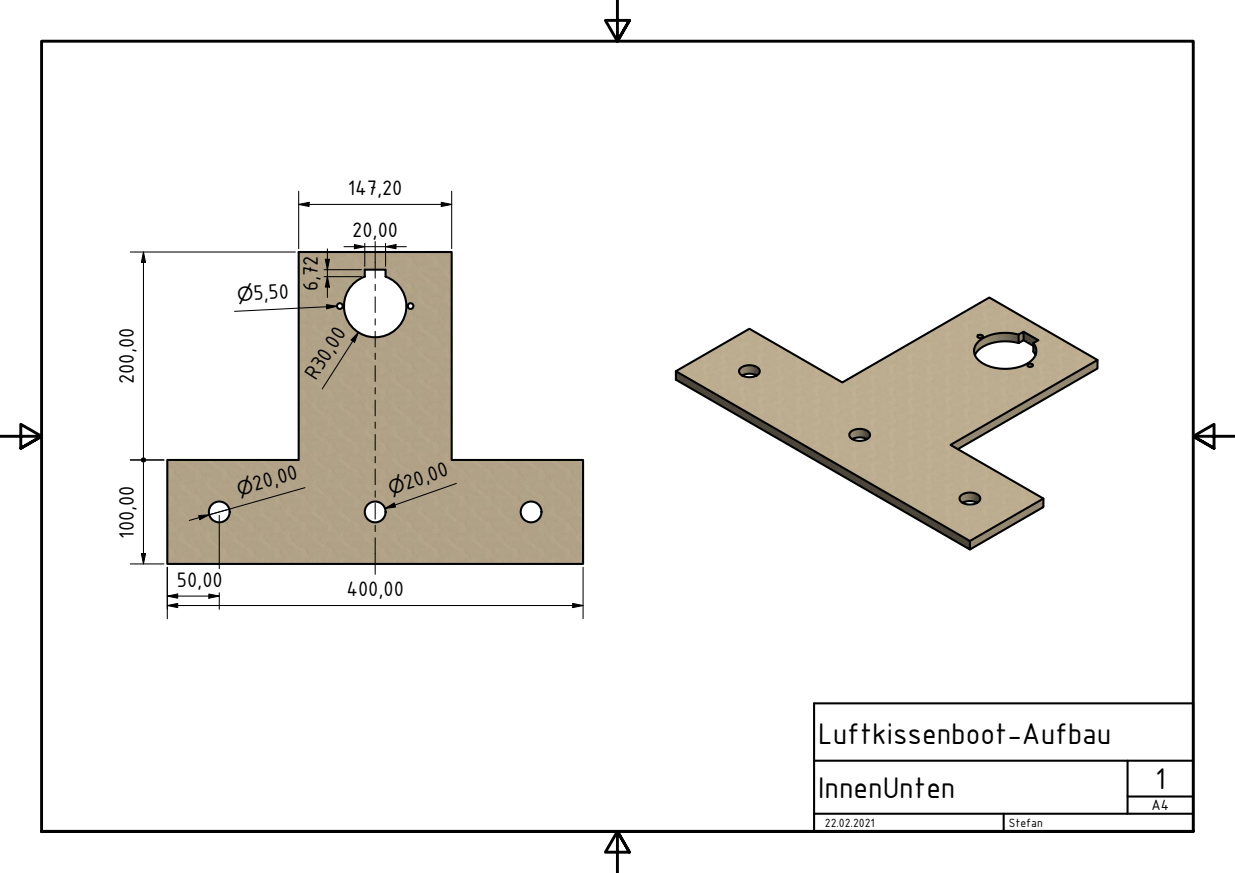
[picture p141: page 1]
