StefanD2/Diplomarbeit_Hovercraft/Inventor/hintererAufbau/Zeichnungen/PlatteAussenEineSeite.pdf

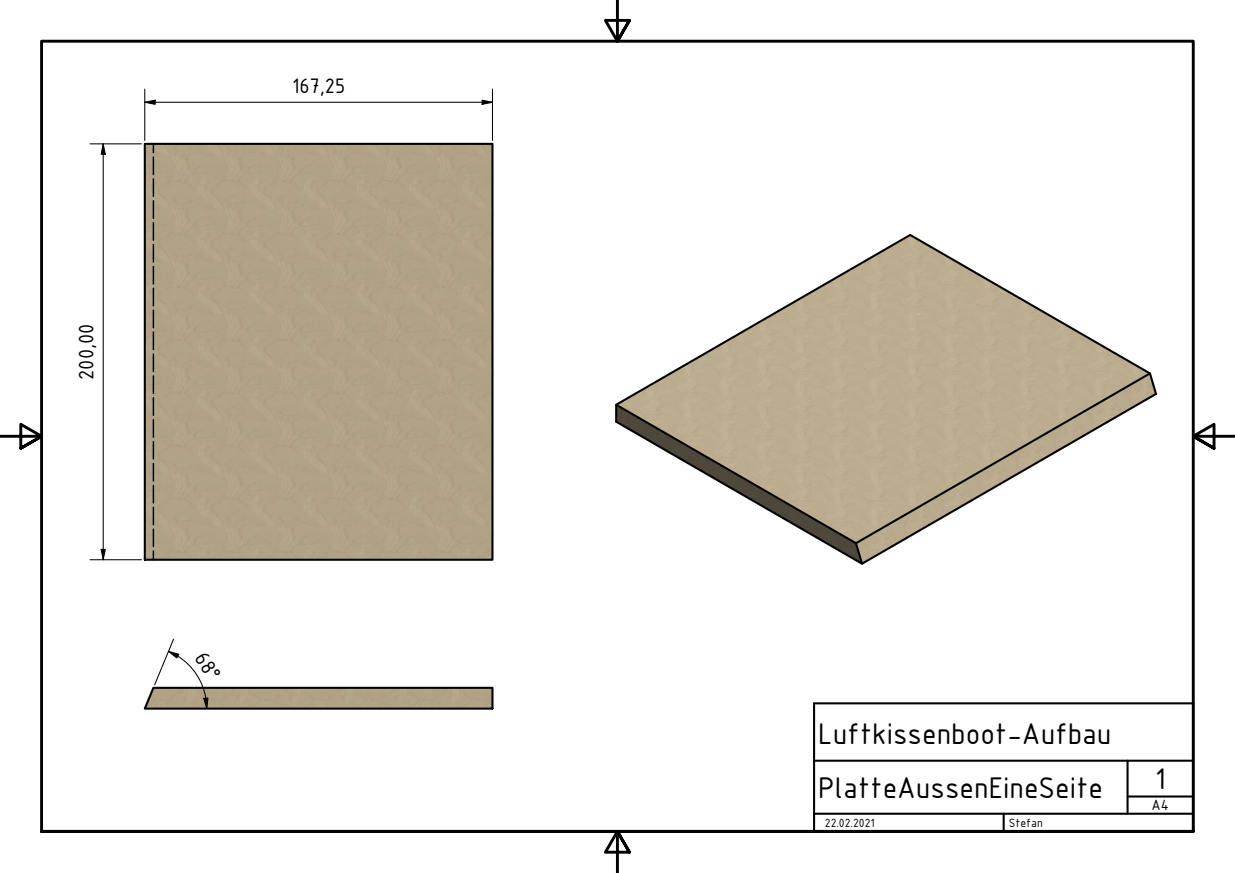
[picture p142: page 1]
