StefanD2/Diplomarbeit_Hovercraft/Inventor/hintererAufbau/Zeichnungen/PlatteAussenGross.pdf

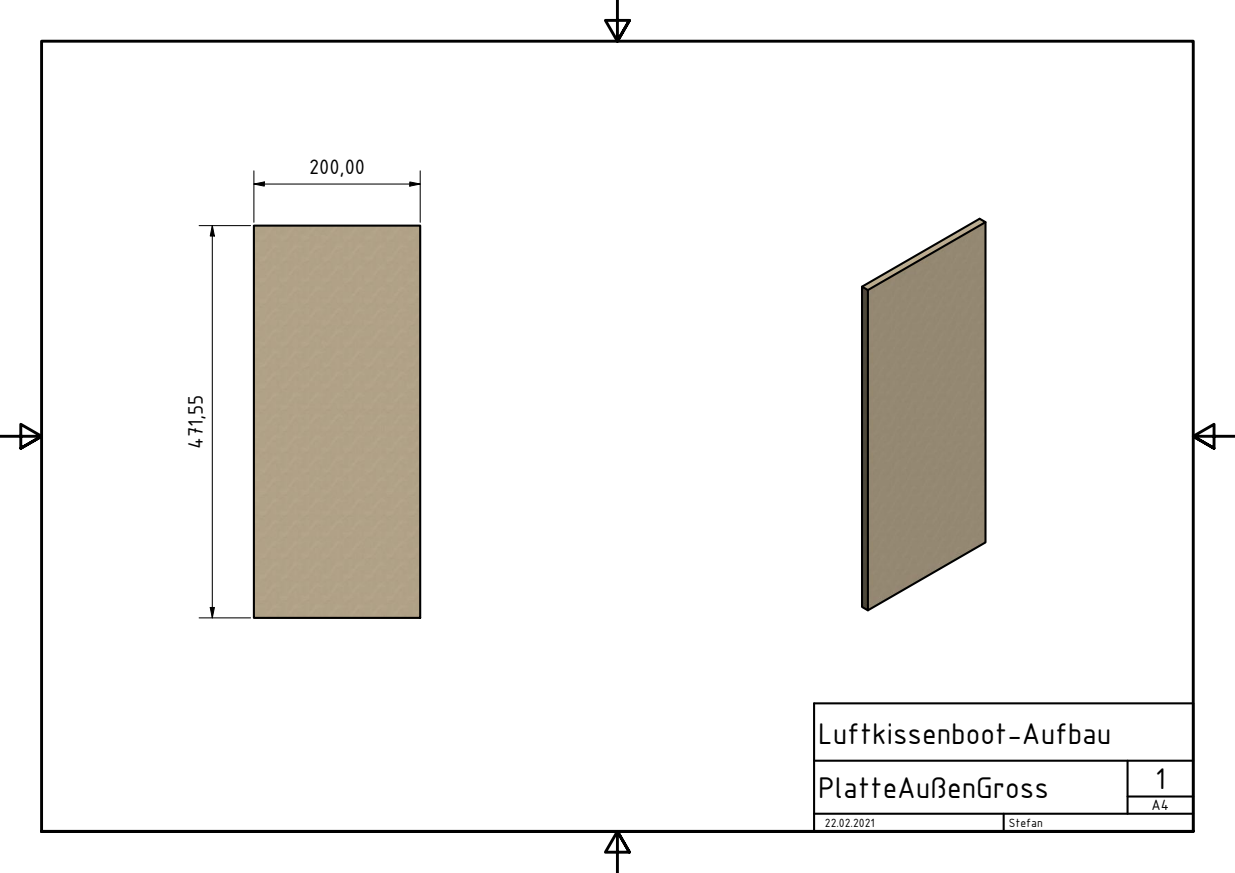
[picture p143: page 1]
