StefanD2/Diplomarbeit_Hovercraft/Inventor/hintererAufbau/Zeichnungen/PlatteAussenZweiSeiten.pdf

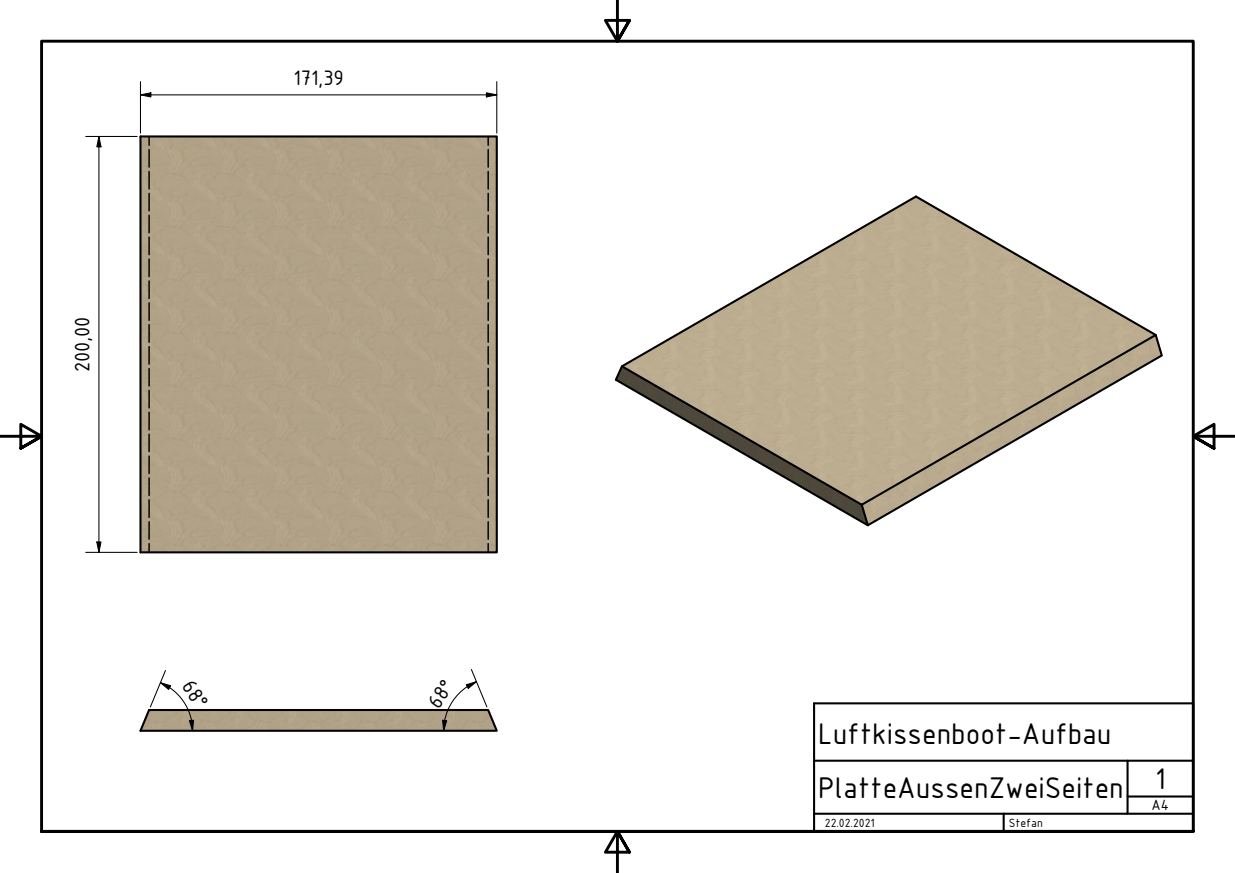
[picture p144: page 1]
