StefanD2/Diplomarbeit_Hovercraft/Inventor/hintererAufbau/Zeichnungen/PlatteInnenEineSeite.pdf

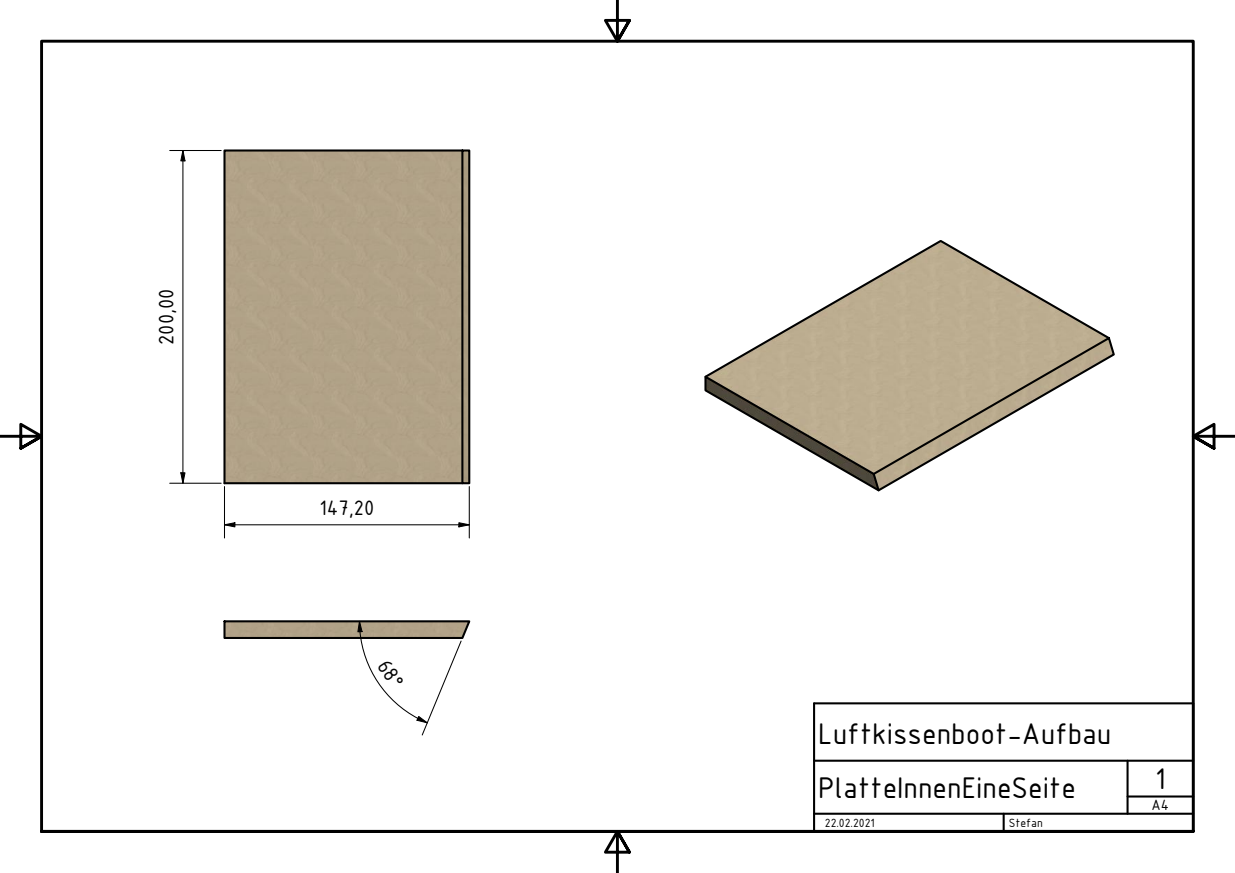
[picture p145: page 1]
