StefanD2/Diplomarbeit_Hovercraft/Inventor/hintererAufbau/Zeichnungen/PlatteInnenzweiSeiten.pdf

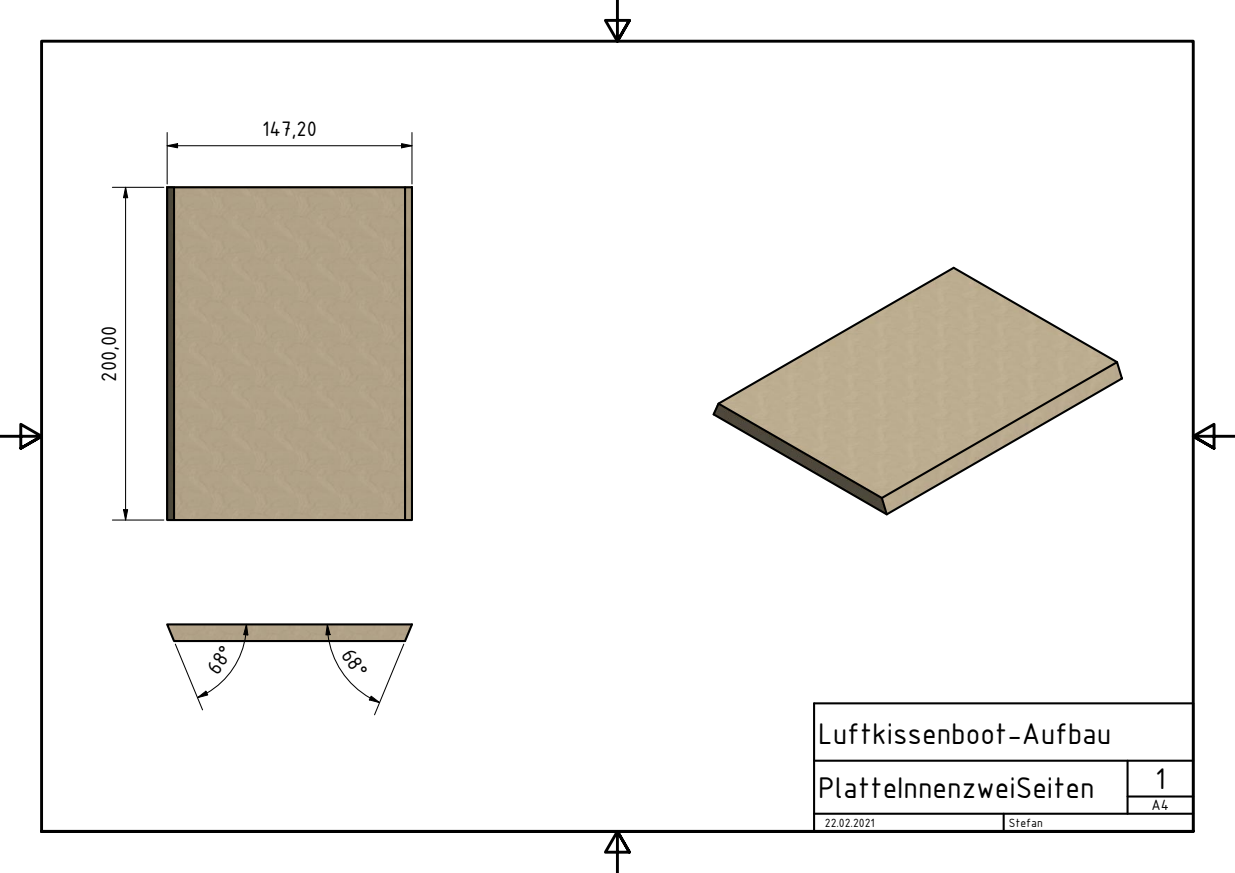
[picture p146: page 1]
