StefanD2/Diplomarbeit_Hovercraft/Inventor/hintererAufbau/Zeichnungen/Hauptplatte.pdf

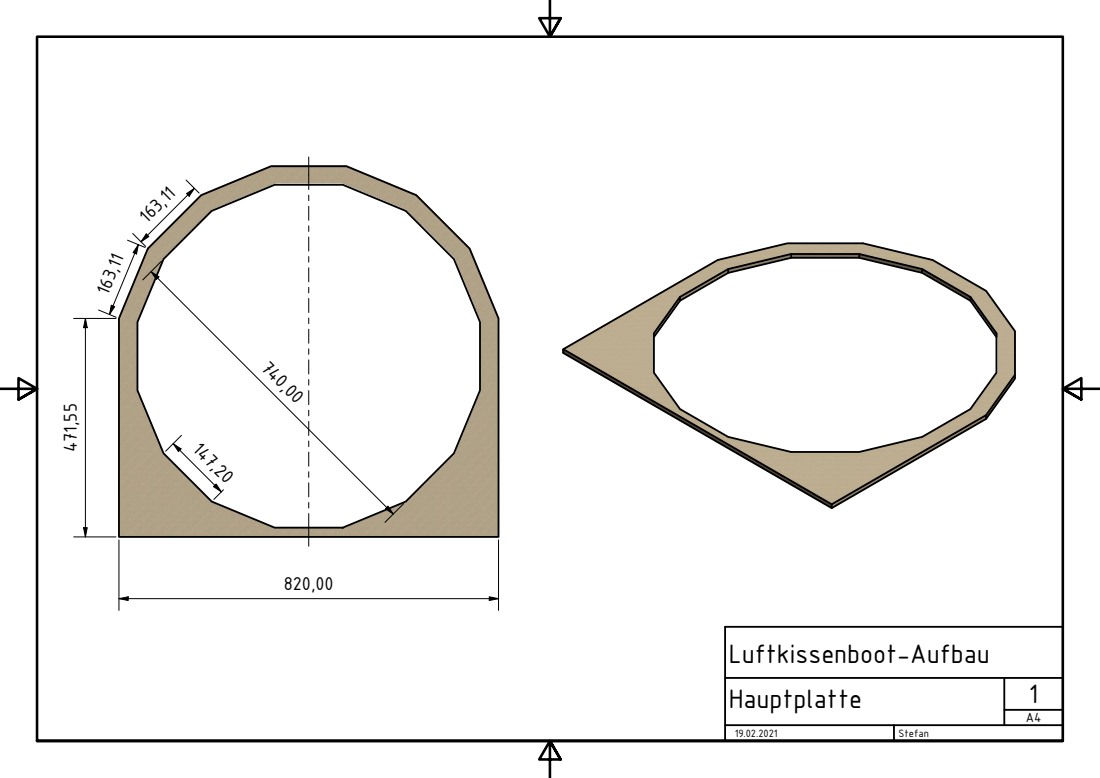
[picture p147: page 1]
