StefanD2/Diplomarbeit_Hovercraft/Inventor/Lenker/Zeichnungen/AdapterLenker.pdf

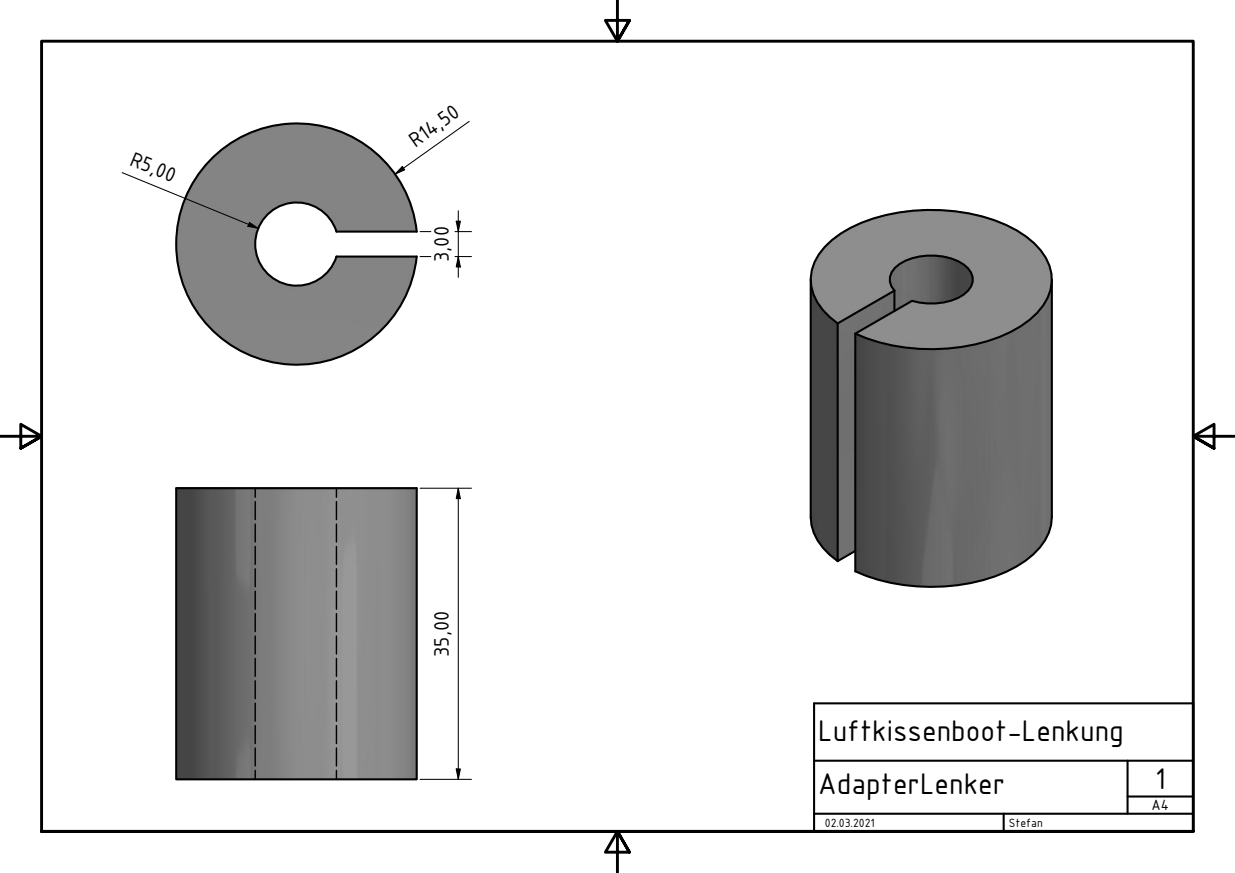
[picture p148: page 1]
