StefanD2/Diplomarbeit_Hovercraft/Inventor/Lenker/Zeichnungen/AdapterPoti1.pdf

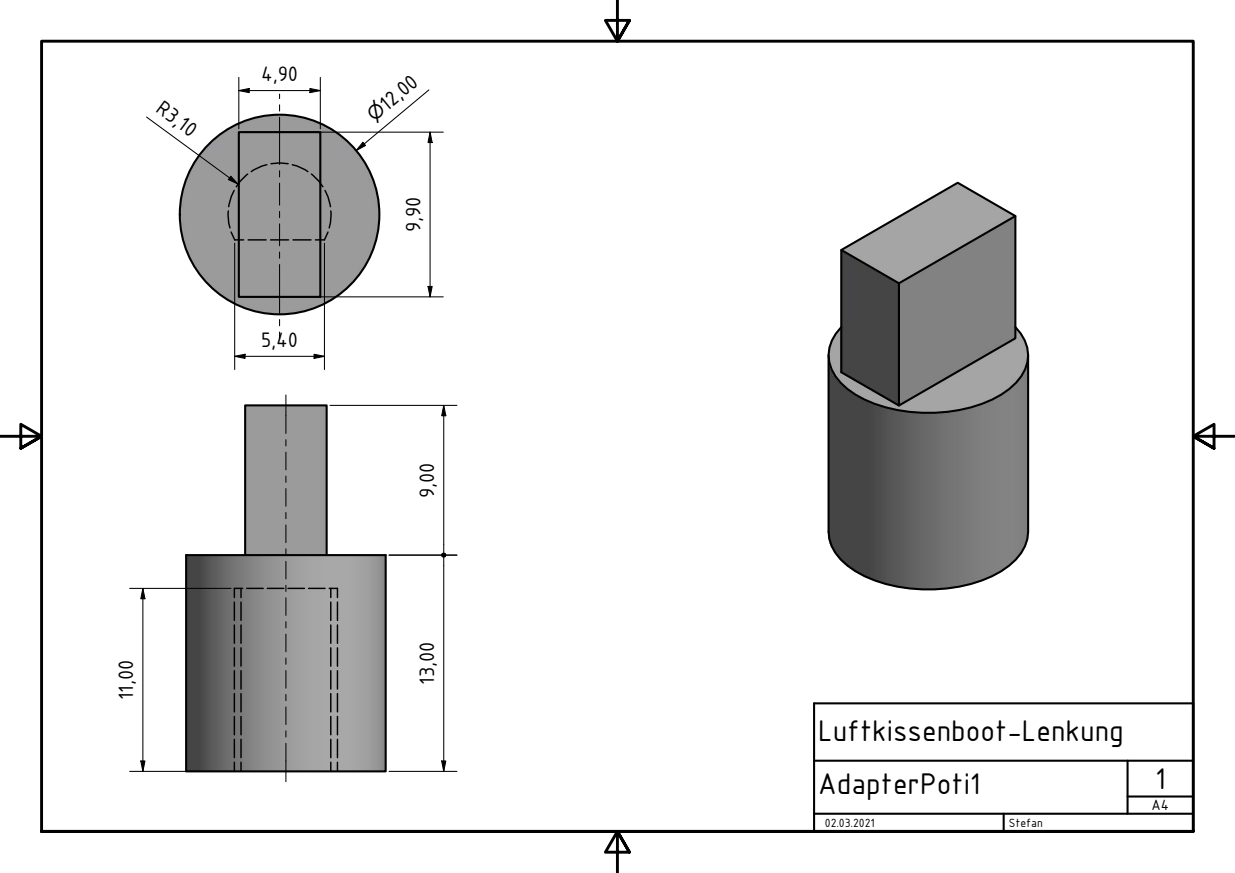
[picture p149: page 1]
