StefanD2/Diplomarbeit_Hovercraft/Inventor/Lenker/Zeichnungen/AdapterPoti2.pdf

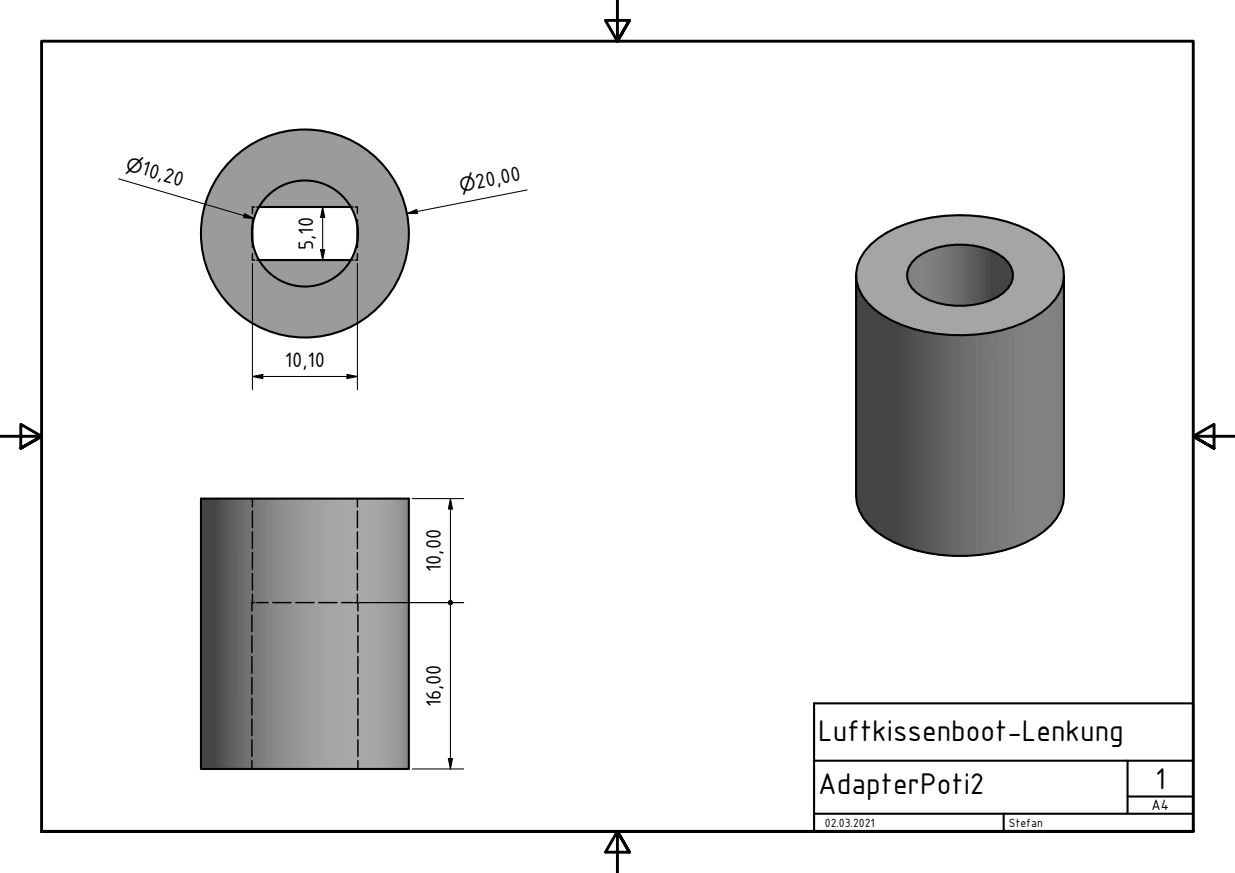
[picture p150: page 1]
