StefanD2/Diplomarbeit_Hovercraft/Inventor/Lenker/Zeichnungen/Bodenplatte.pdf

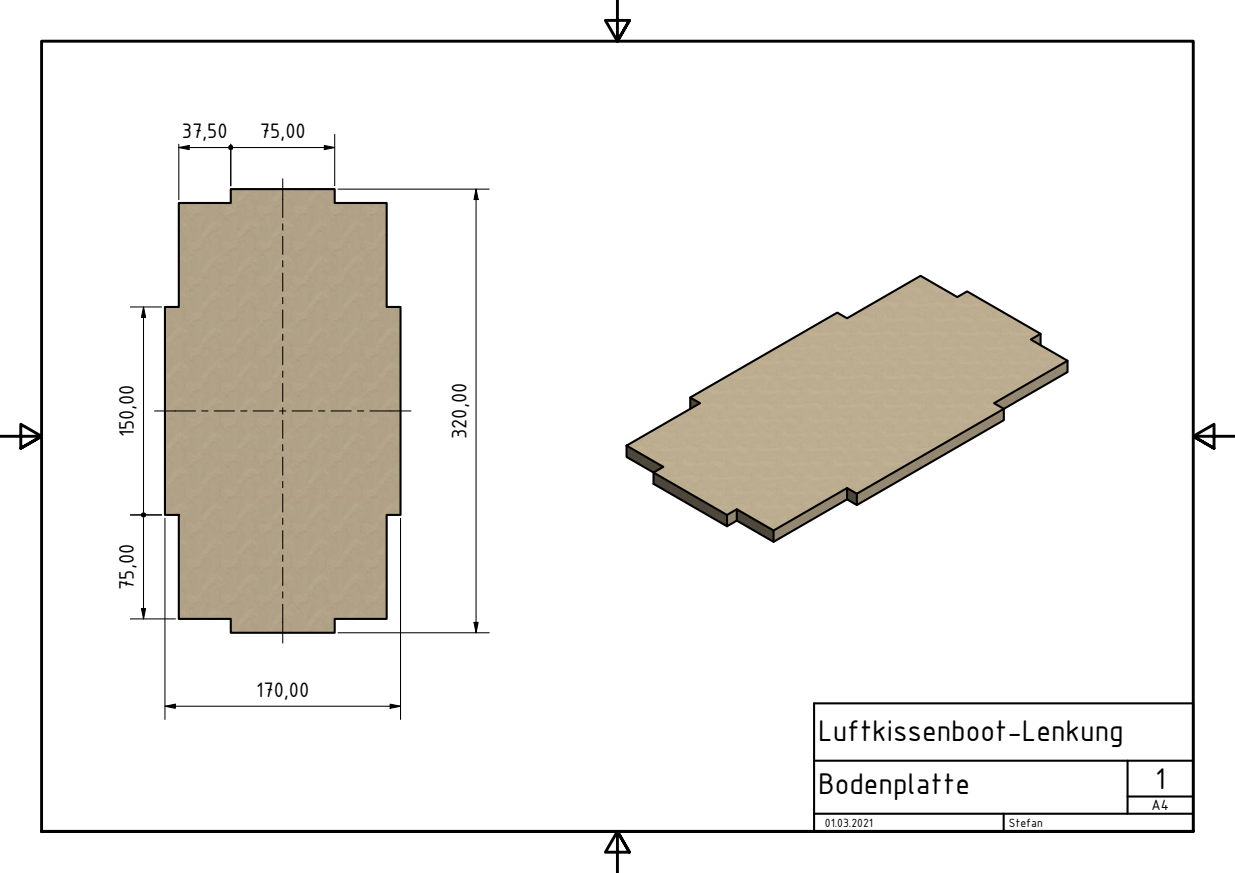
[picture p151: page 1]
