StefanD2/Diplomarbeit_Hovercraft/Inventor/Lenker/Zeichnungen/M4Gewindestange.pdf

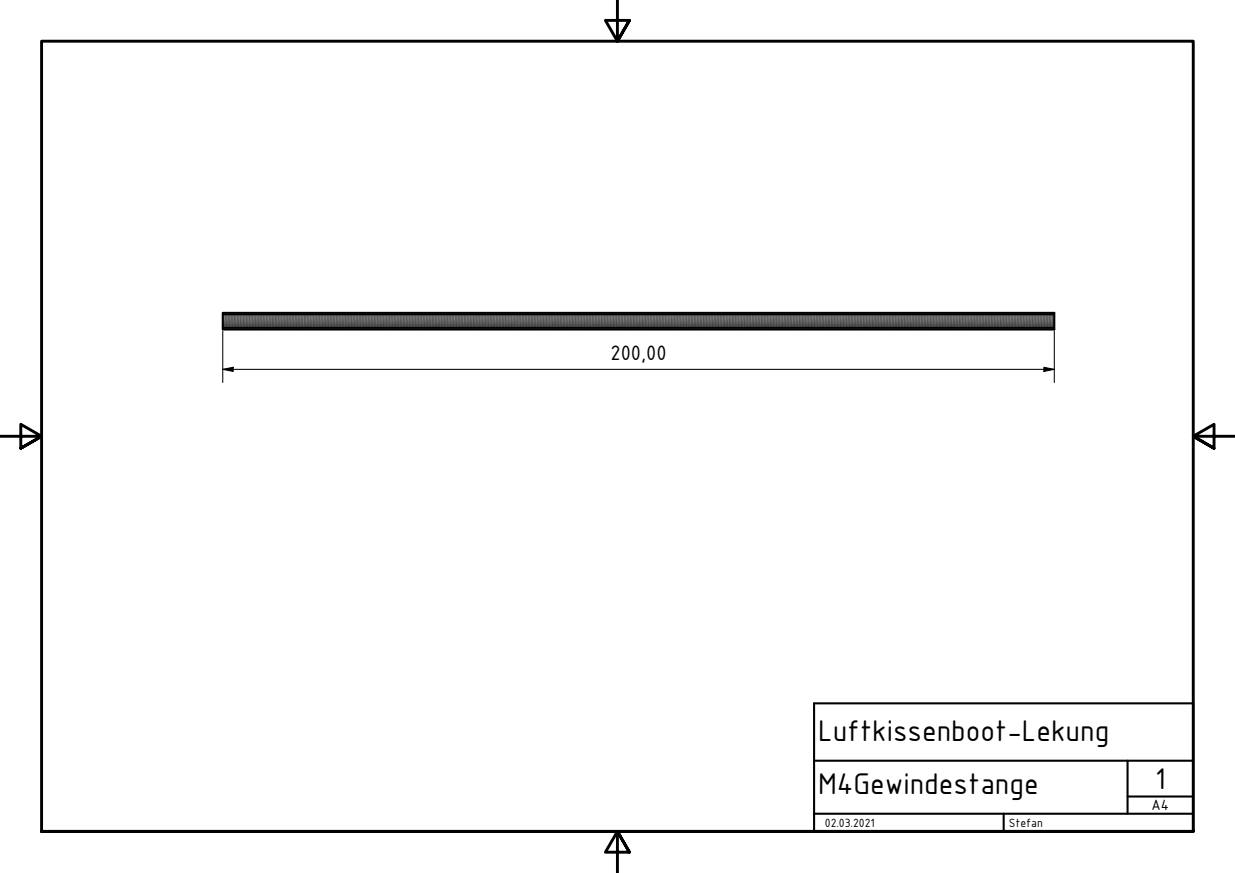
[picture p152: page 1]
