StefanD2/Diplomarbeit_Hovercraft/Inventor/Lenker/Zeichnungen/Mount_Nextion_Display_Deckel.pdf

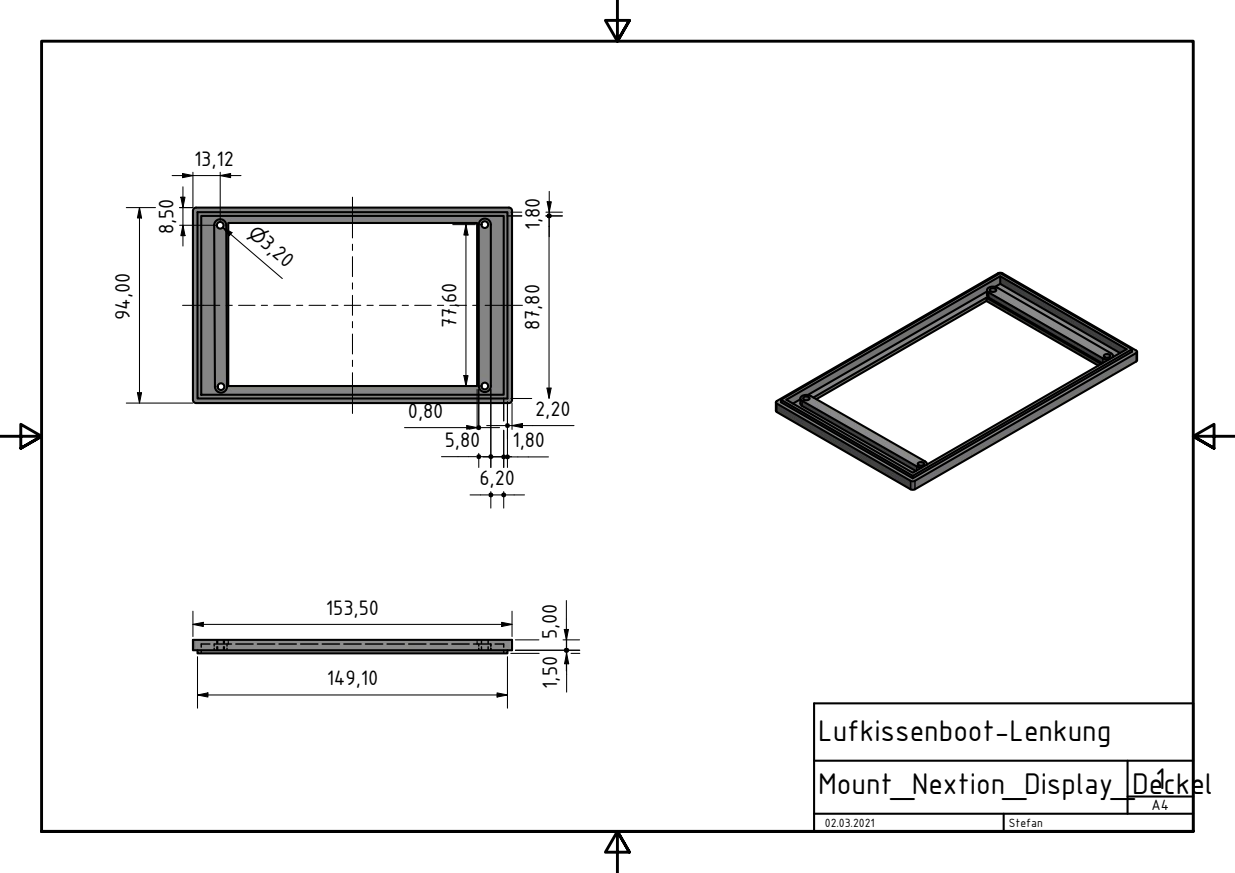
[picture p153: page 1]
