StefanD2/Diplomarbeit_Hovercraft/Inventor/Lenker/Zeichnungen/Mount_Nextion_Display_Halter.pdf

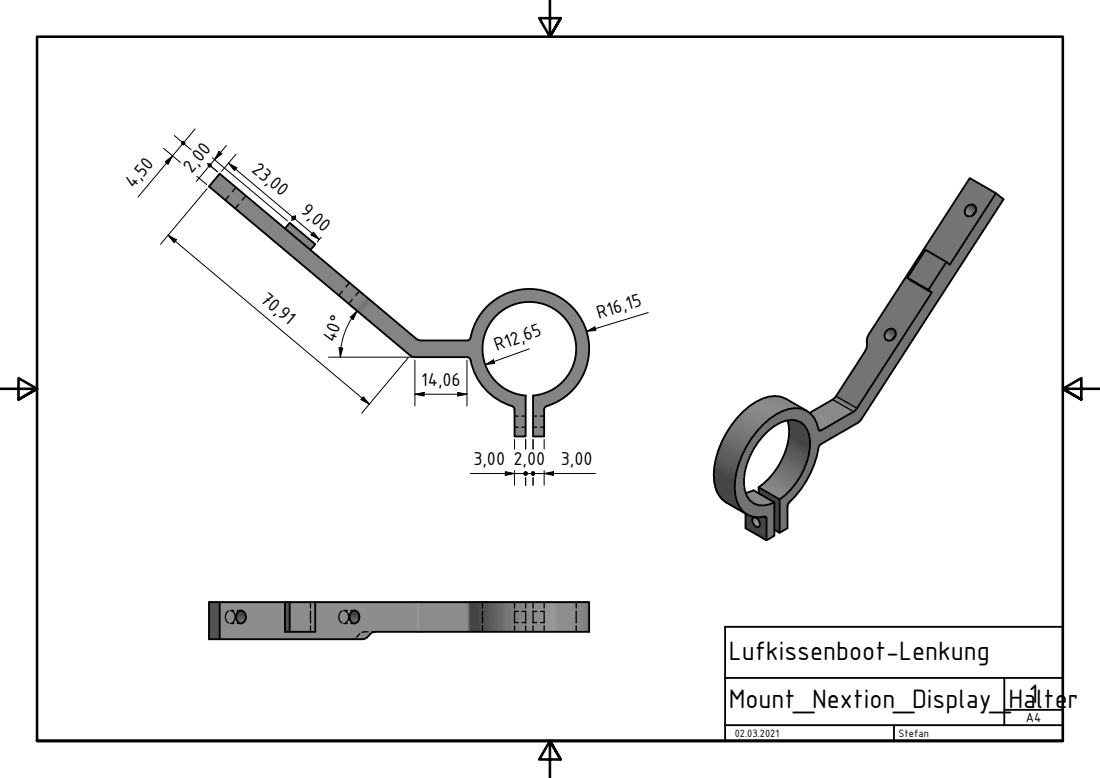
[picture p154: page 1]
