StefanD2/Diplomarbeit_Hovercraft/Inventor/Lenker/Zeichnungen/Mount_Nextion_Display_Main.pdf

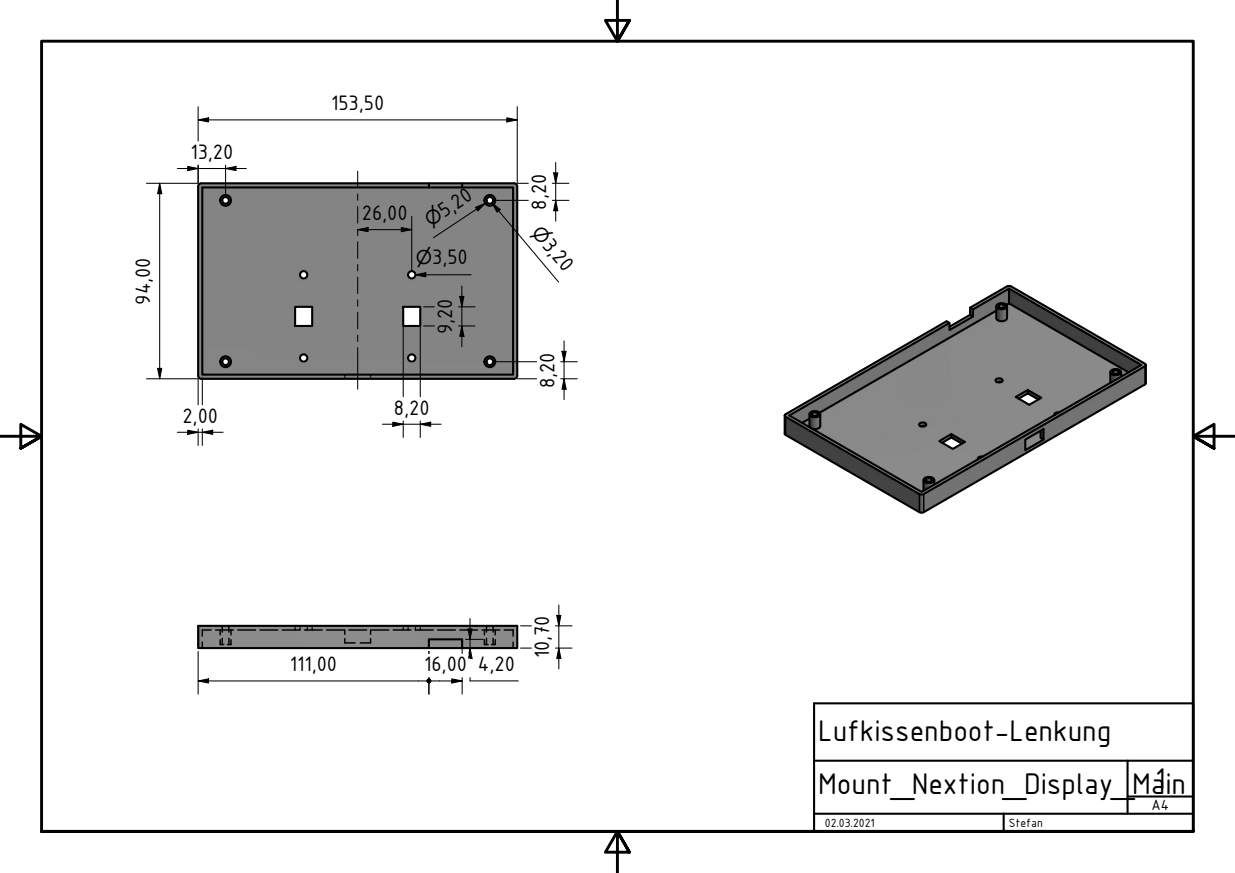
[picture p155: page 1]
