StefanD2/Diplomarbeit_Hovercraft/Inventor/Lenker/Zeichnungen/PlatteGrossLoch.pdf

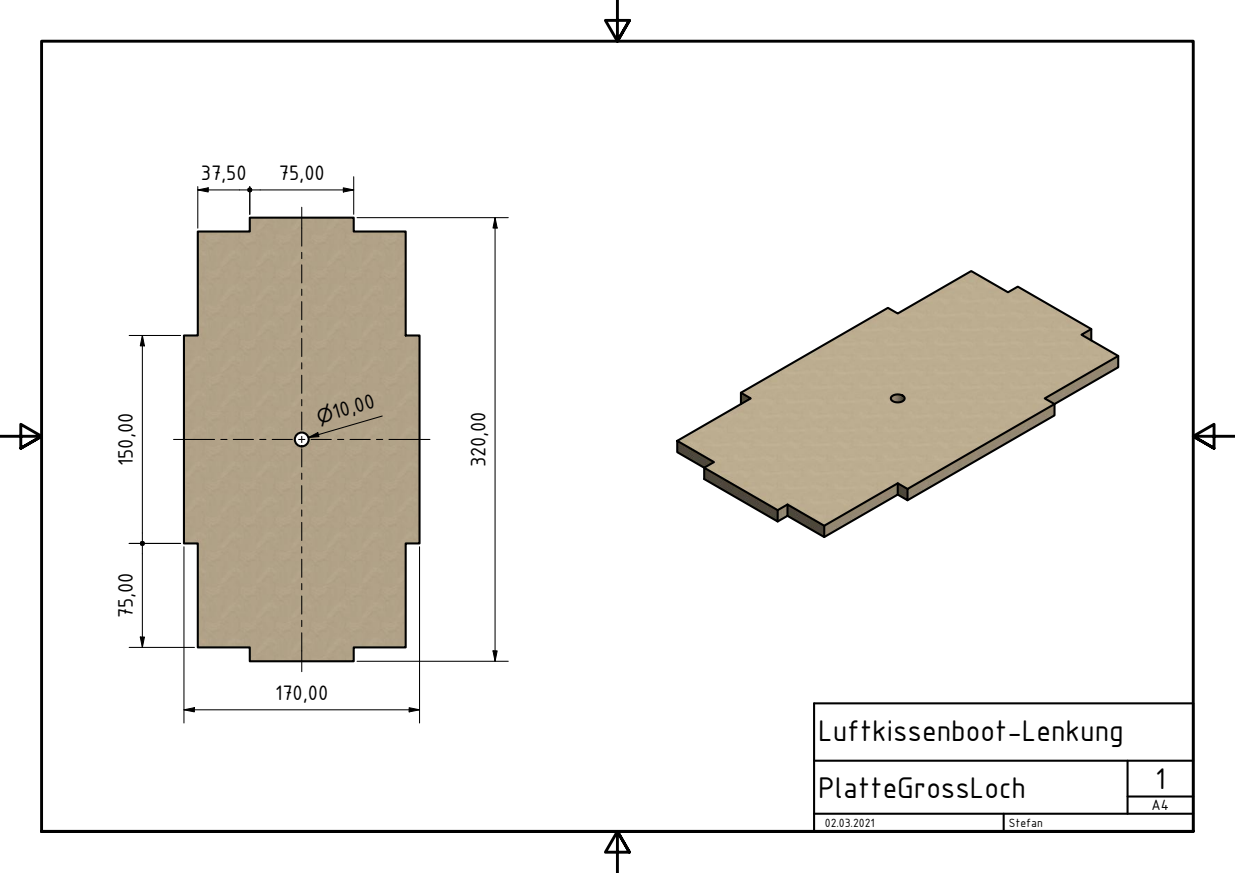
[picture p156: page 1]
