StefanD2/Diplomarbeit_Hovercraft/Inventor/Lenker/Zeichnungen/PlatteSeiteKurz.pdf

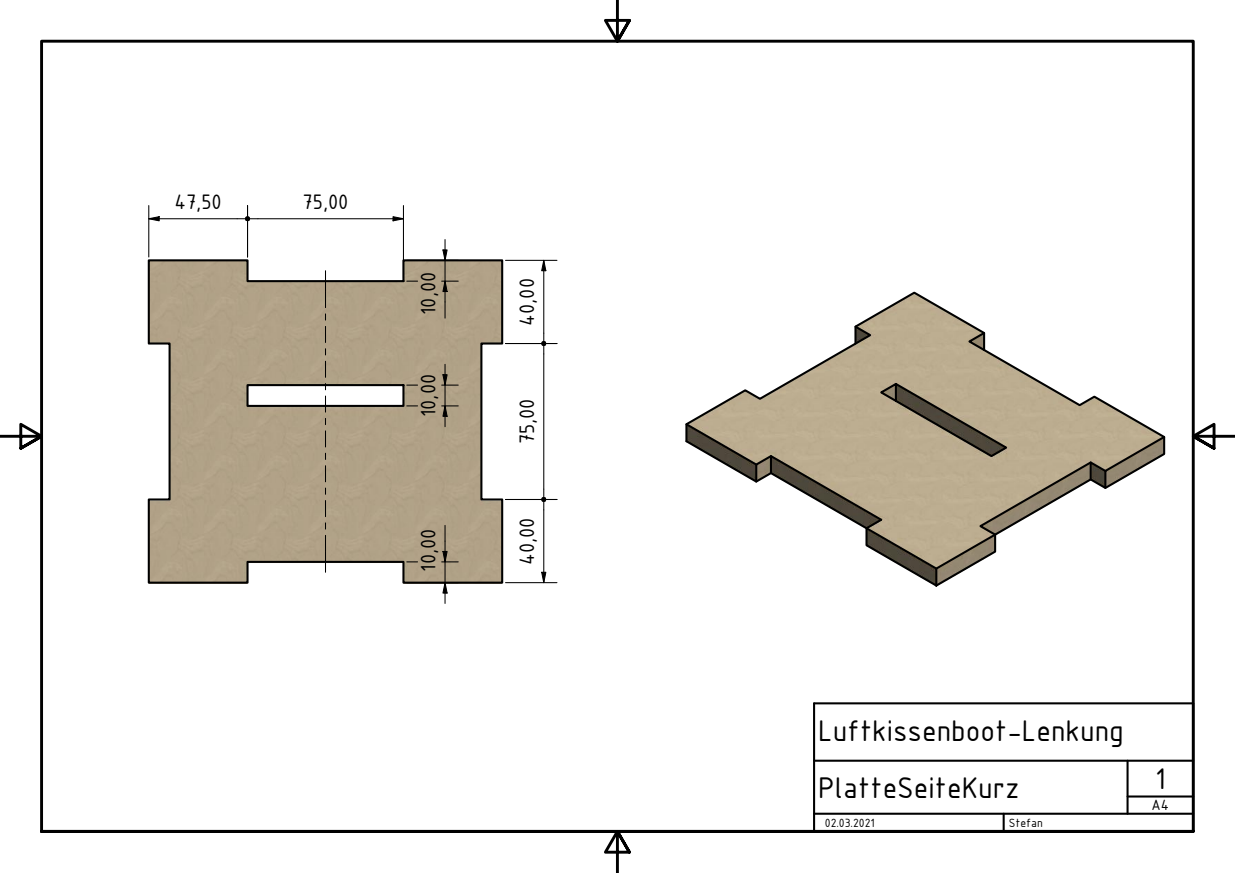
[picture p157: page 1]
