StefanD2/Diplomarbeit_Hovercraft/Inventor/Lenker/Zeichnungen/PlatteSeiteLang.pdf

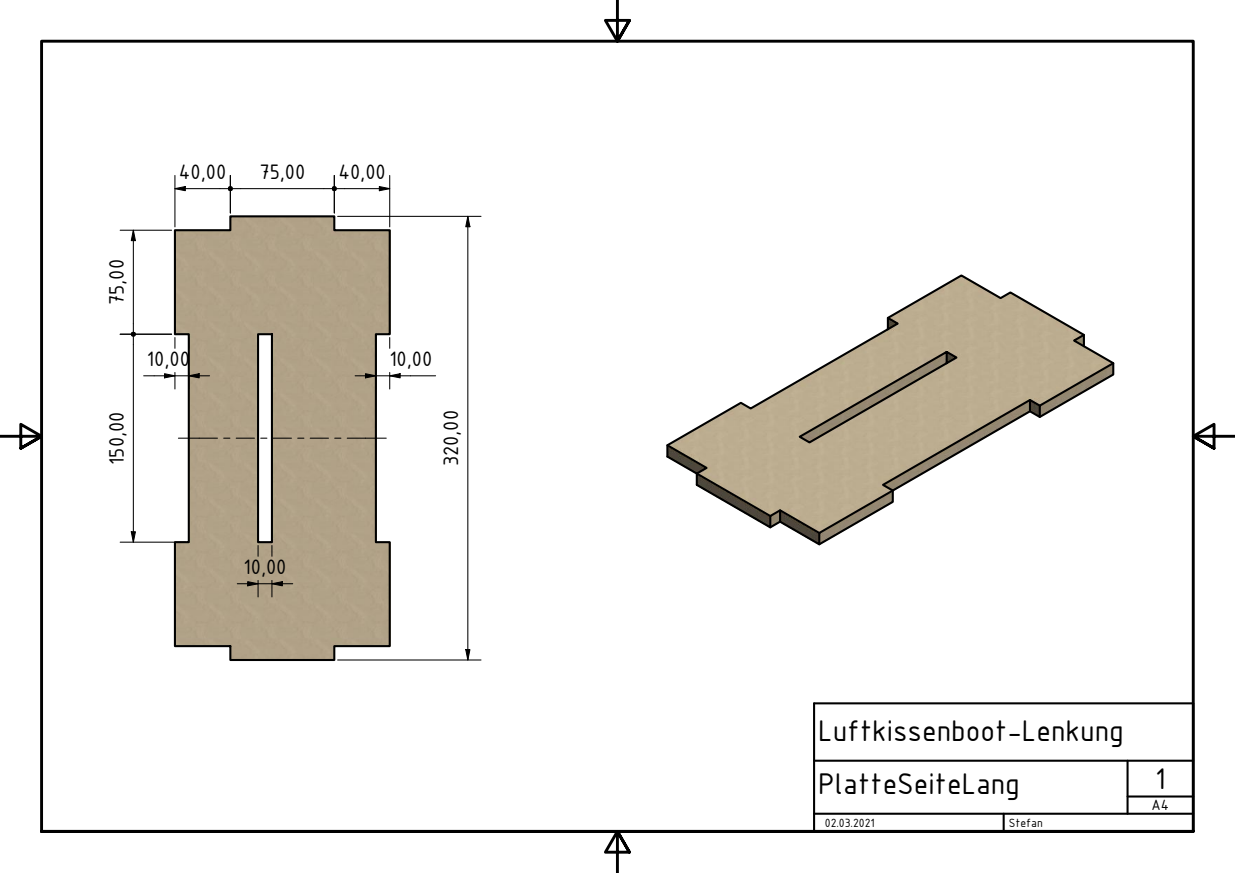
[picture p158: page 1]
