StefanD2/Diplomarbeit_Hovercraft/Inventor/Lenker/Zeichnungen/PotiHalterungUnten.pdf

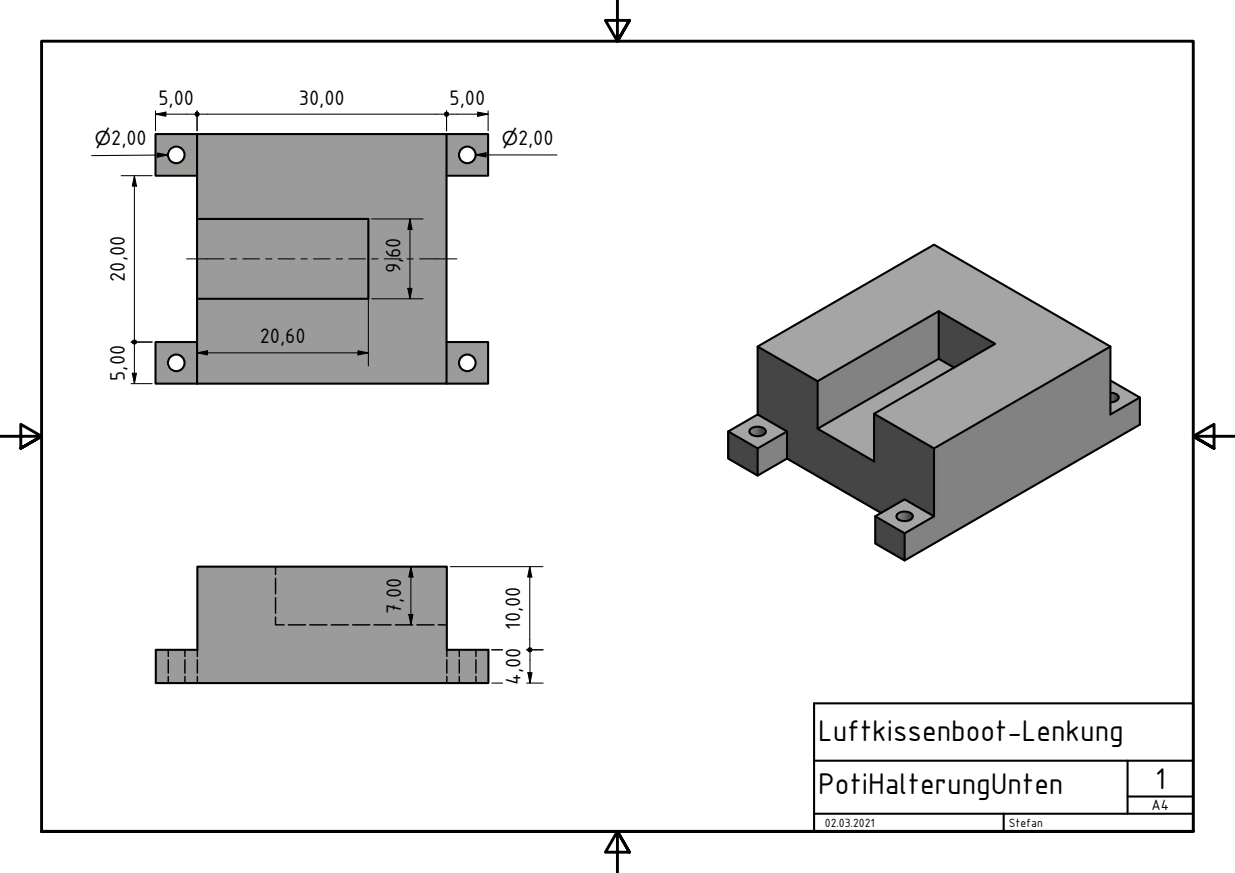
[picture p159: page 1]
