StefanD2/Diplomarbeit_Hovercraft/Inventor/Lenker/Zeichnungen/StangeMitte.pdf

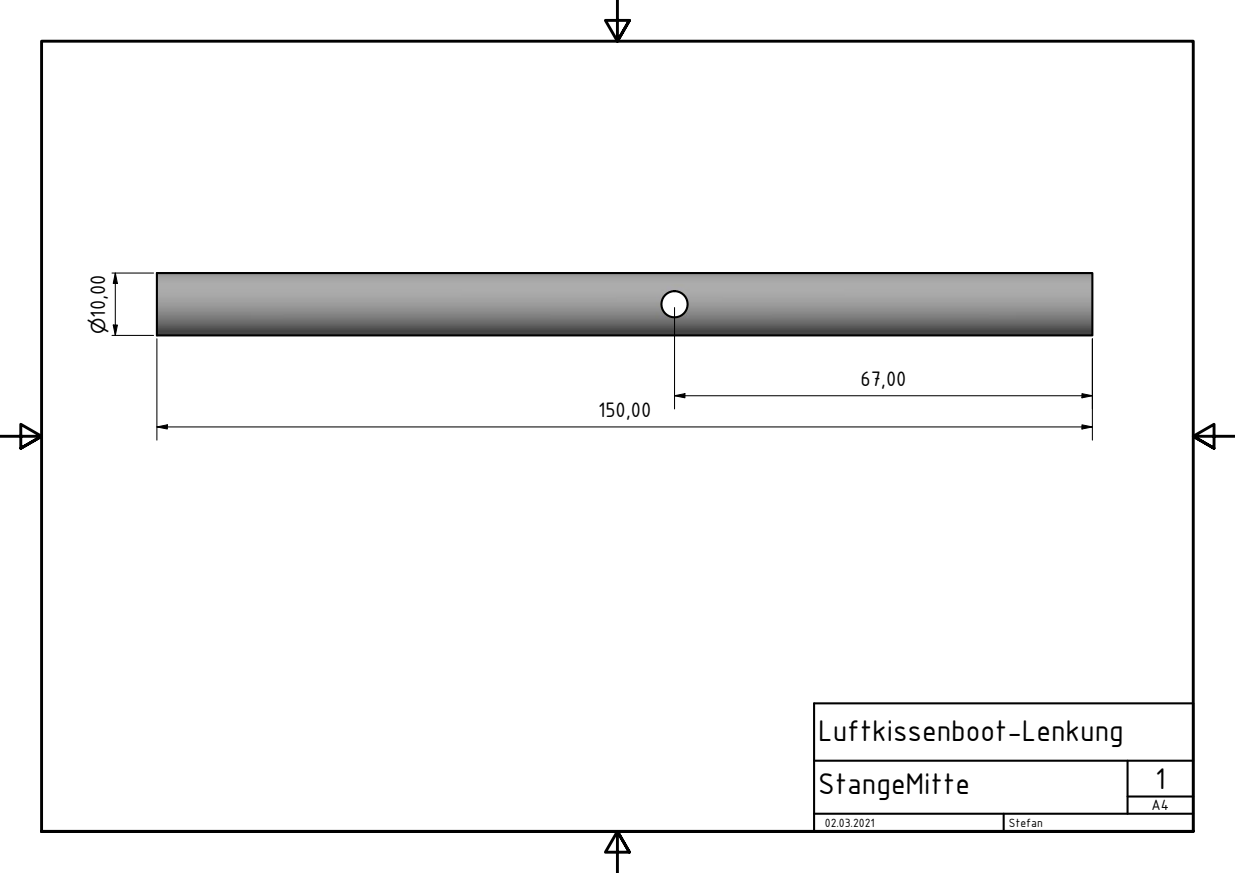
[picture p160: page 1]
