StefanD2/Diplomarbeit_Hovercraft/Inventor/Bodenplatte/Zeichnung/40x60Staffel.pdf

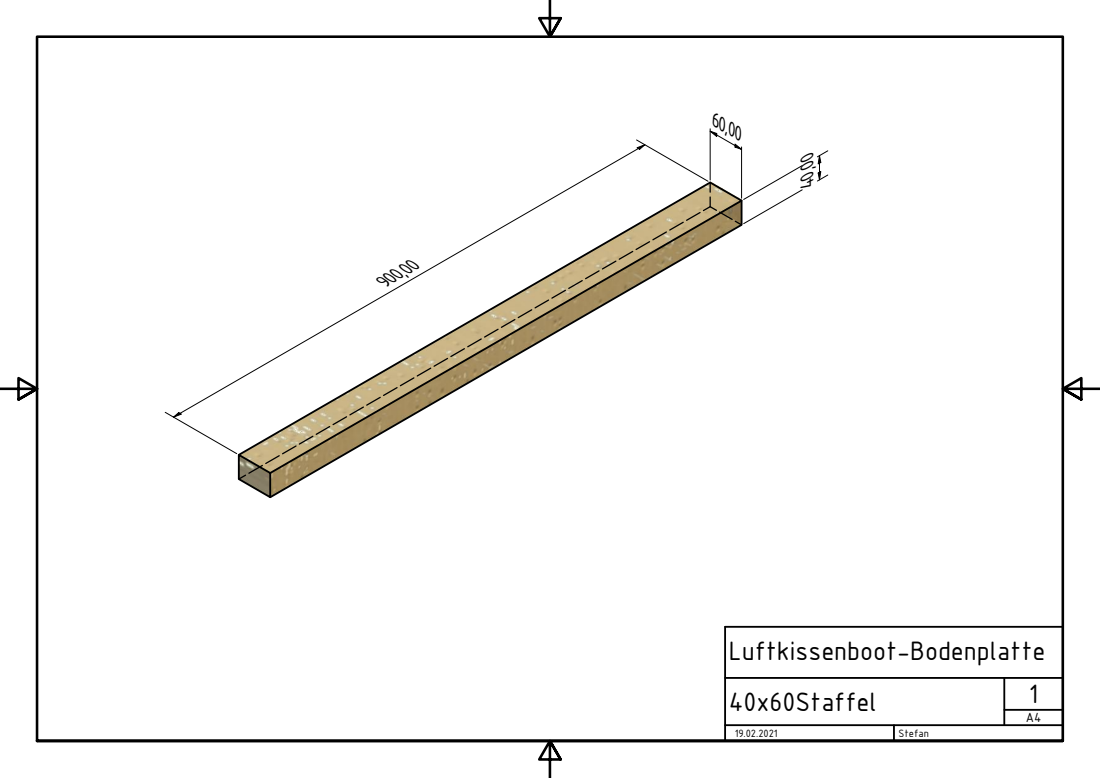
[picture p161: page 1]
