StefanD2/Diplomarbeit_Hovercraft/Inventor/Bodenplatte/Zeichnung/Bodenplatte-Holz.pdf

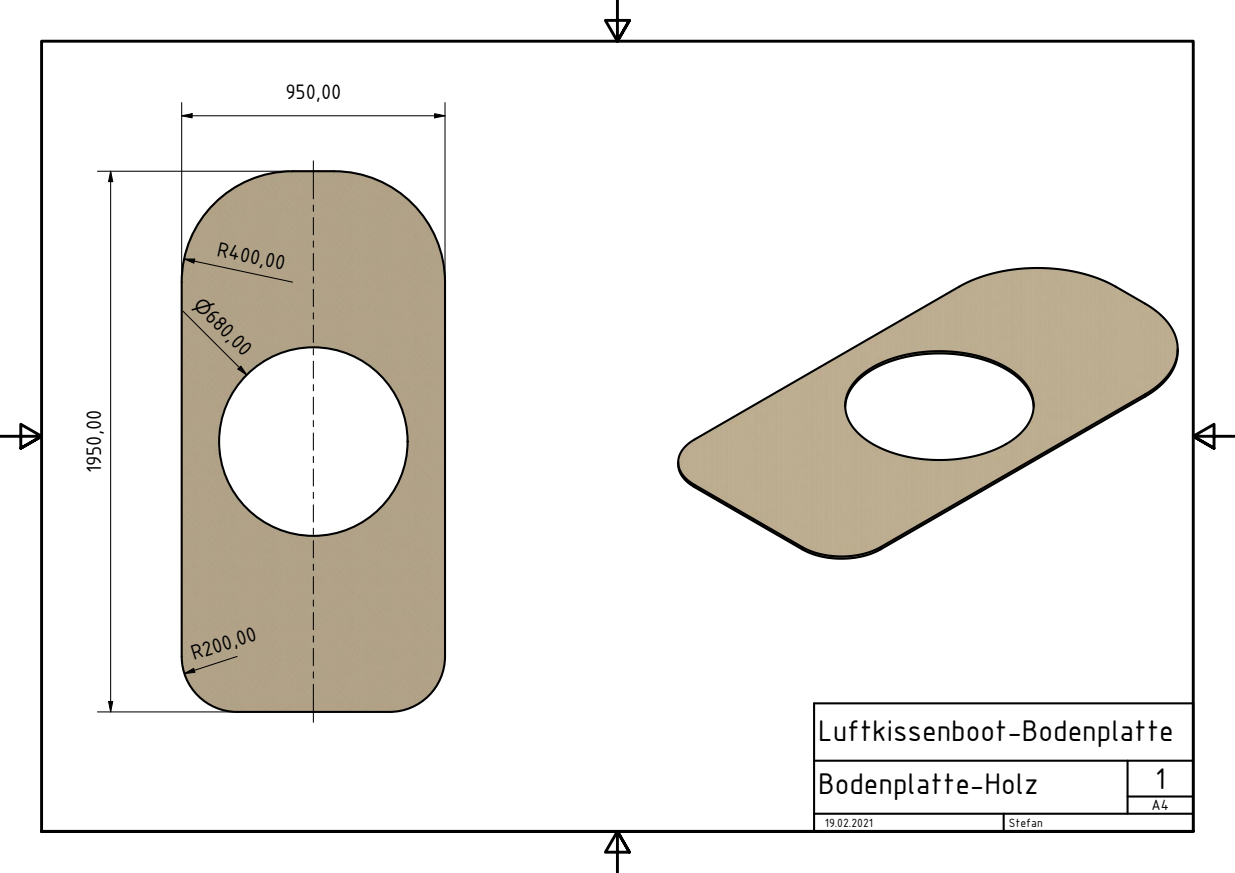
[picture p162: page 1]
