StefanD2/Diplomarbeit_Hovercraft/Inventor/Bodenplatte/Zeichnung/Bodenplatte-XPS.pdf

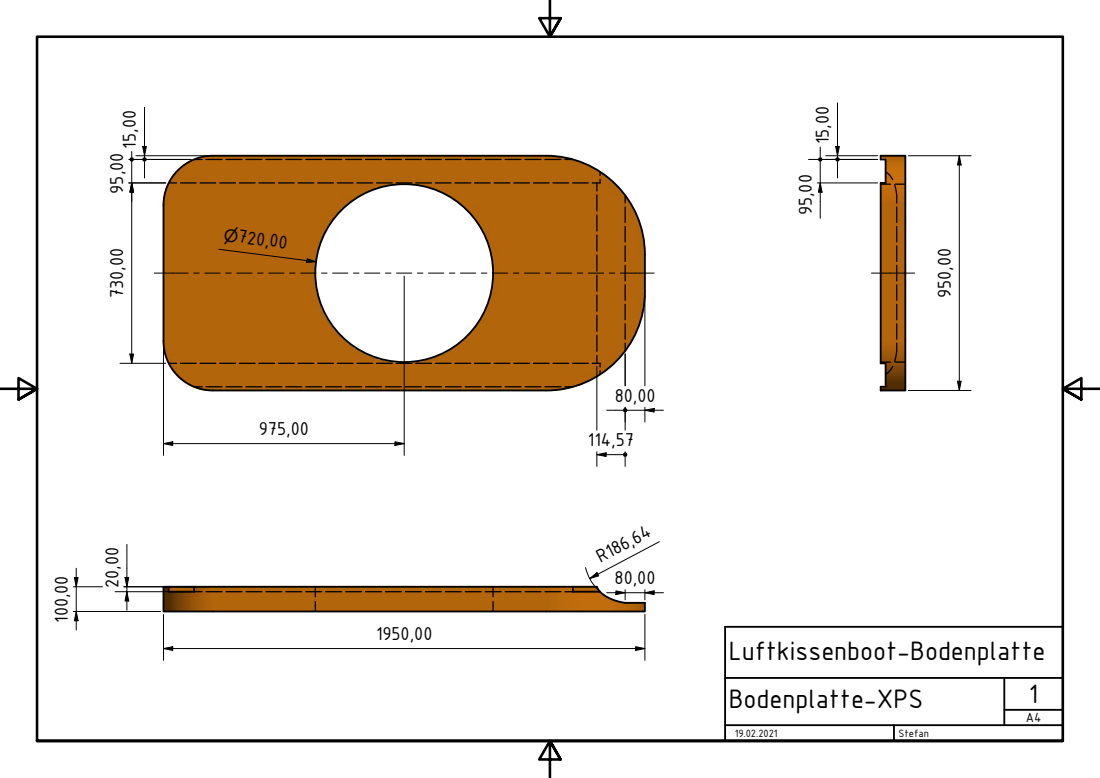
[picture p163: page 1]

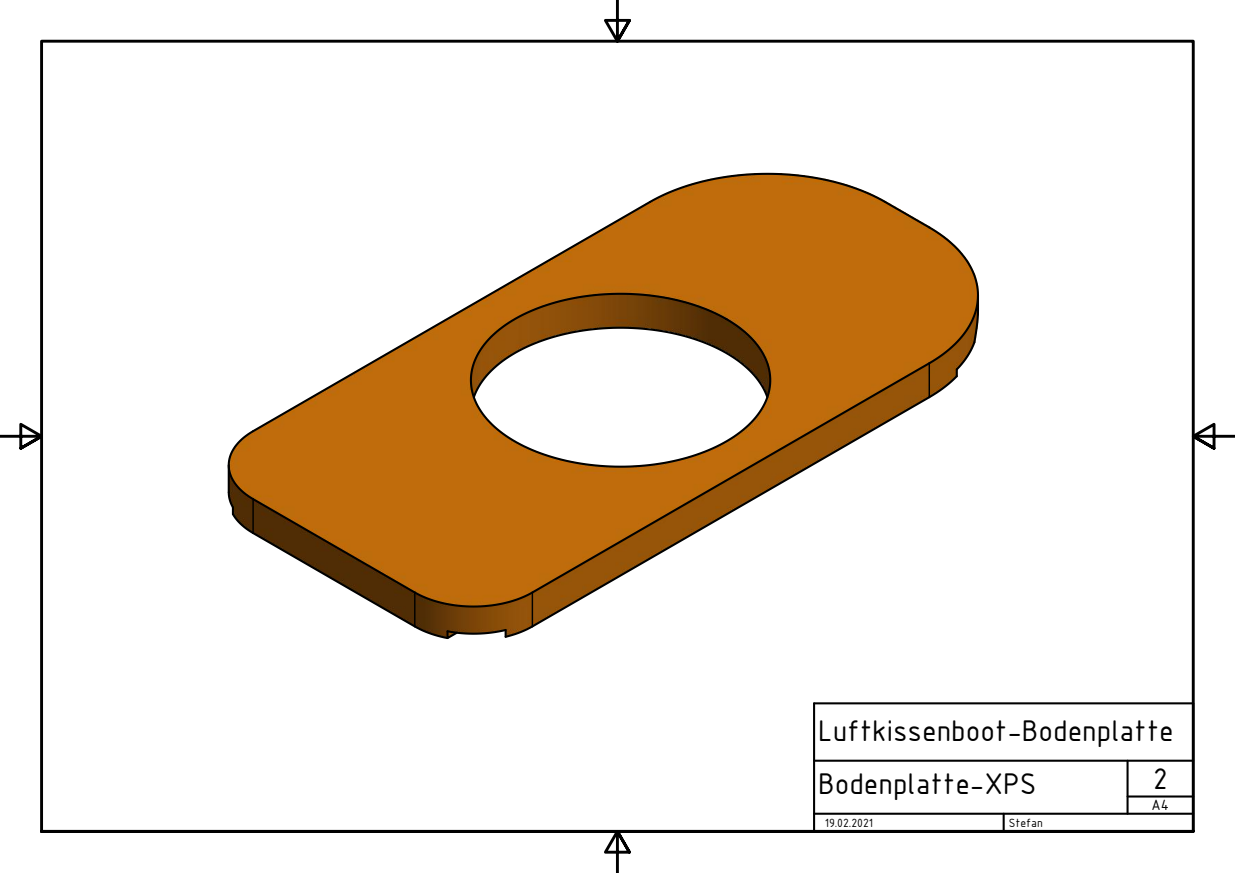
[picture p164: page 2]
