StefanD2/Diplomarbeit_Hovercraft/Inventor/Bodenplatte/Zeichnung/HalterungMotorregler.pdf

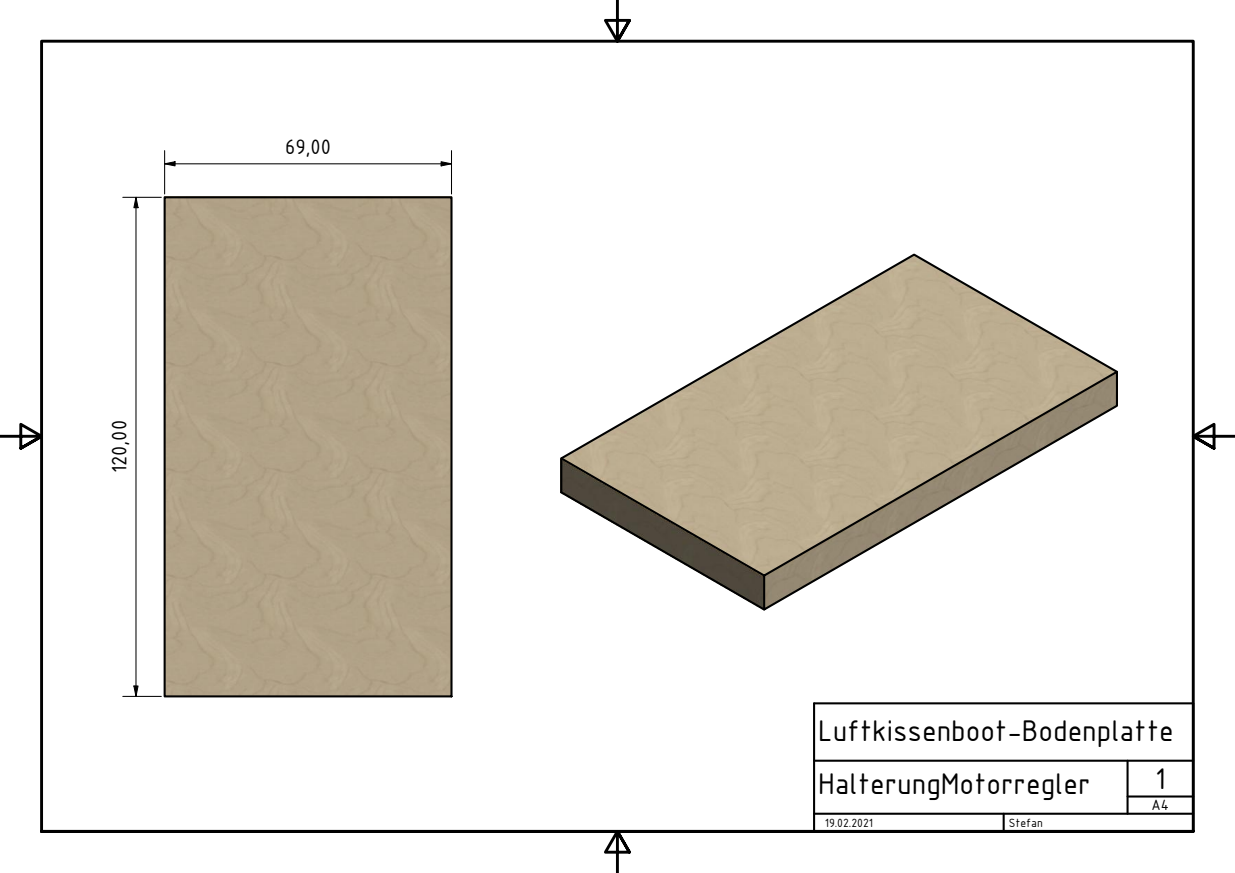
[picture p165: page 1]
