StefanD2/Diplomarbeit_Hovercraft/Inventor/Bodenplatte/Zeichnung/HolzLatteLinks.pdf

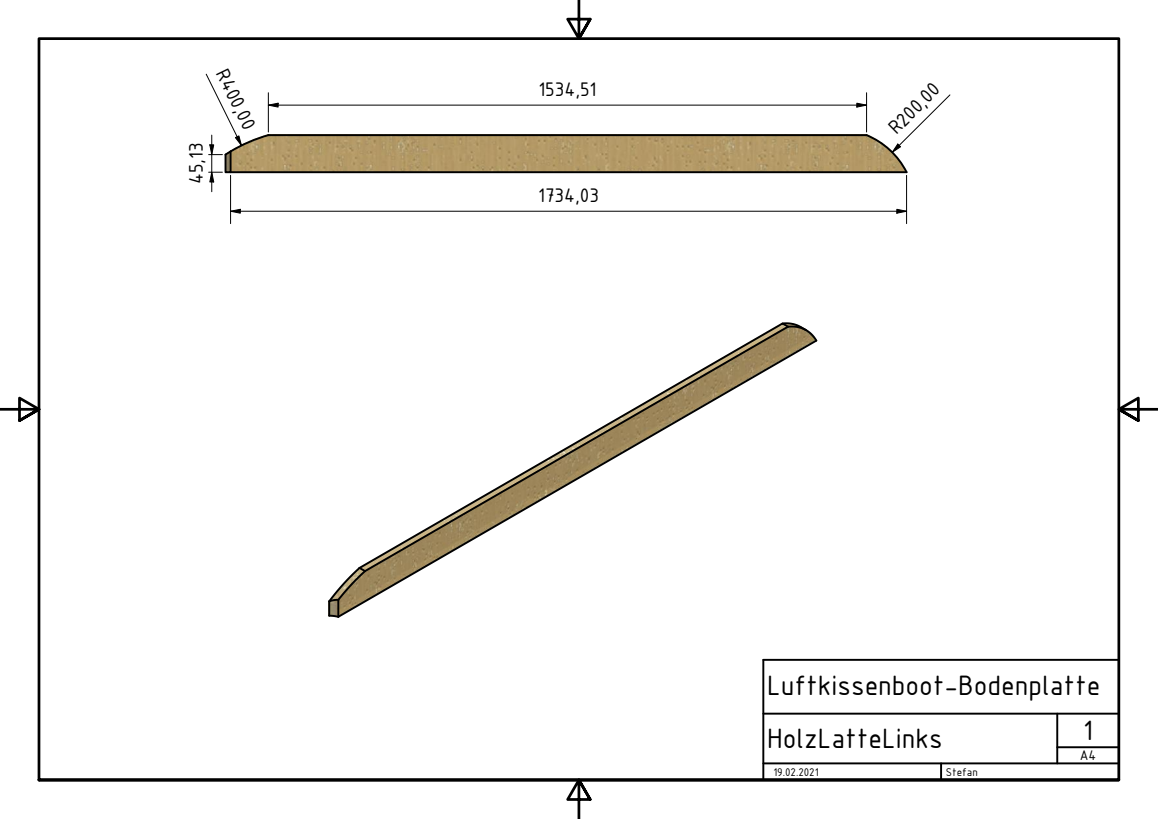
[picture p166: page 1]
