StefanD2/Diplomarbeit_Hovercraft/Inventor/Bodenplatte/Zeichnung/HolzLatteRechts.pdf

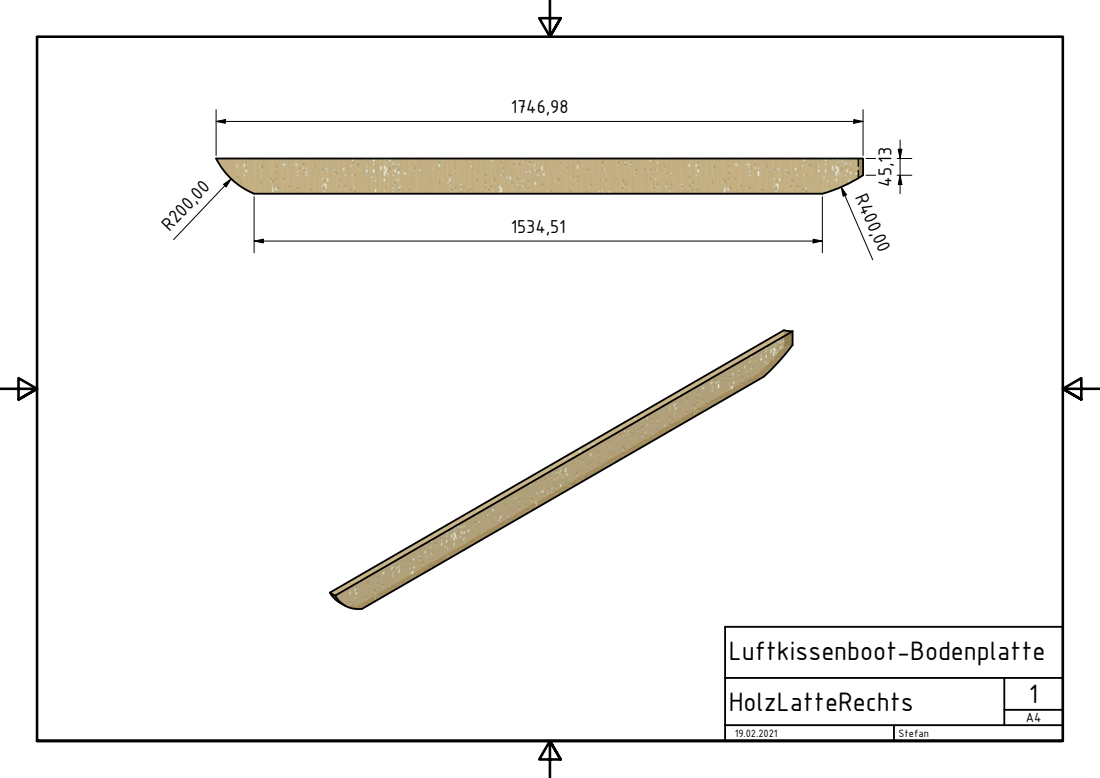
[picture p167: page 1]
