StefanD2/Diplomarbeit_Hovercraft/Inventor/Bodenplatte/Zeichnung/MotorHalterung.pdf

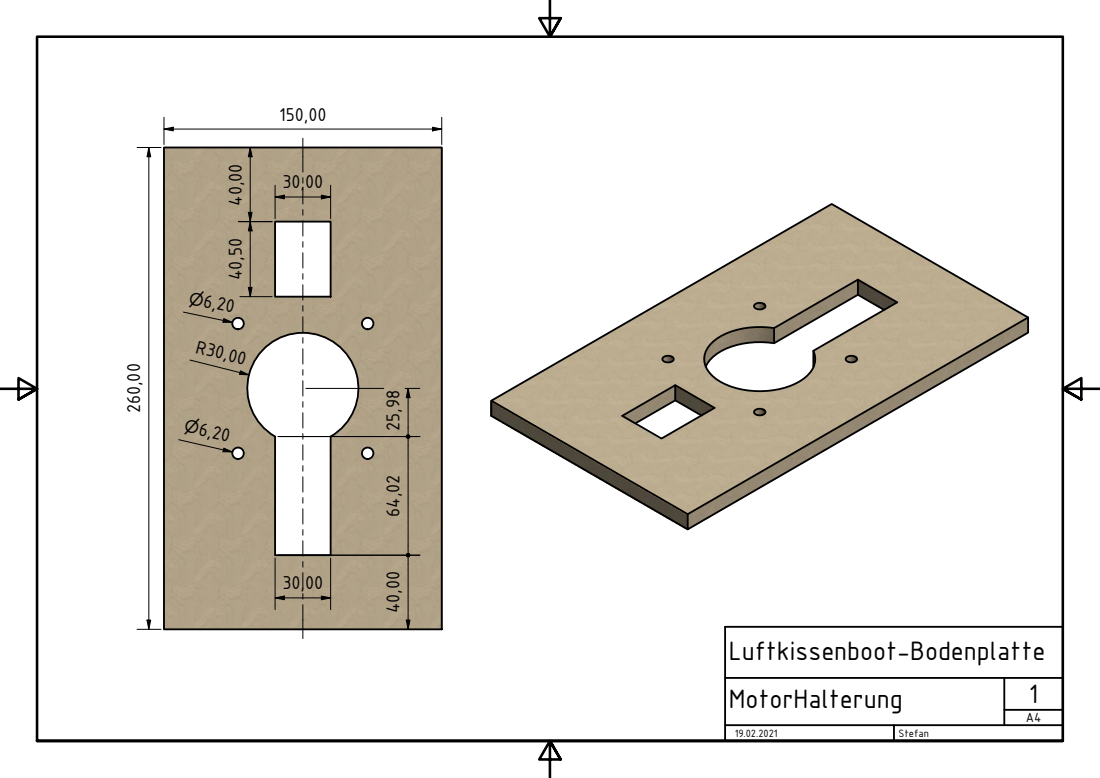
[picture p168: page 1]
