StefanD2/Diplomarbeit_Hovercraft/(list of files, drawings)

Other design files:
Proteus/ADC_Platine_Temperatursensoren.pdsprj
Proteus/GesamterPlan.pdsprj
Proteus/Lenker_Platine.pdsprj
Proteus/Platine_ADCS.pdsprj
Proteus/Platine_ADCS_old.pdsprj
Proteus/Platine_Regler_Hinten.pdsprj
Proteus/Platine_Regler_Hinten_2.pdsprj
Proteus/Platine_Regler_Hinten_3.pdsprj
Proteus/Platine_Relais.pdsprj
Proteus/Platine_Relais_V2.pdsprj
Proteus/Servo_Controller_Platine.pdsprj
Proteus/Zeitvergzögerung.pdsprj
