StefanD2/Diplomarbeit_Hovercraft/(commit log)

2020-05-11 PROTEUS IS ORSCH
    [Funktinsgenerator.pdsprj]
2020-07-29 17s to change, ca 32 to finisch doesn't get better, don't know why
    [main.cpp]
2020-10-26 GasRegelung über CANBUS + PWM Erzeugung funktionsfähig
2020-11-21 added HMI
    [CAN_BUS_IDs.xlsx]
2020-12-05 voltage over canbus running
2020-12-05 data transmission over canbus is working fixed some bugs in Jeti library
    [main.cpp]
2020-12-05 added CanBusDebugger
    [CAN_BUS_IDs.xlsx]
2020-12-05 changed canbusids made Regler_Controller easier to configure
    [CAN_BUS_IDs.xlsx]
2021-01-02 added inventor
    [AdapterPoti2.0008.ipt, AdapterPoti2.ipt, AdapterPoti2.stl, Aufbau.0075.ipt, Aufbau.ipt, Bauteil1.ipt, BodenplatteXPS.0001.ipt, BodenplatteXPS.ipt]
2021-01-02 added proteus and gitignore
    [GesamterPlan.pdsprj, Platine_ADCS.pdsprj]
2021-01-03 moved programs to folder
    [CAN_BUS_IDs.xlsx]
2021-01-03 kan plan
    [GesamterPlan.pdsprj, Platine_ADCS.pdsprj, Zeitvergzögerung_SimTet.pdsprj]
2021-01-03 platine für Regler Hinten Added
    [Platine_Regler_Hinten.pdsprj]
2021-01-03 merged last changes of Lenker-Controller moved Platine for Controller
    [Platine_Regler_Hinten.pdsprj]
2021-01-05 started doku added import package (to fix path errros in input) fixed chapter pages
    [Zeitvergzögerung.pdsprj, Zeitvergzögerung_SimTet.pdsprj]
2021-01-11 nix mehr wissen
    [GesamterPlan.pdsprj, Lenkung.0103.iam, Lenkung.0104.iam, Lenkung.iam, Luftkissenboot.0294.iam, Luftkissenboot.0298.iam, Luftkissenboot.iam, Zeitvergzögerung.pdsprj]
2021-01-14 bissl weitergrschrieben
    [Platine_ADCS.pdsprj]
2021-01-14 Danksagung und Einleitung
2021-01-15 new PCBs added
    [ADC_Platine_Temperatursensoren.pdsprj, Platine_Regler_Hinten.pdsprj, Platine_Regler_Hinten_2.pdsprj, Platine_Regler_Hinten_3.pdsprj, Servo_Controller_Platine.pdsprj]
2021-01-30 platinen modified
    [ADC_Platine_Temperatursensoren.pdsprj, Lenker_Platine.pdsprj, Platine_Regler_Hinten_3.pdsprj, Platine_Relais.pdsprj, Servo_Controller_Platine.pdsprj]
2021-02-01 added nextion library, Voltage Logger, HMI improved
    [CAN_BUS_IDs.xlsx, Servo_Controller_Platine.pdsprj, voltages_log.csv, voltages_log02.csv]
2021-02-02 started updating desing to single parts
    [Aufbau.0075.ipt, Aufbau.0076.ipt, Aufbau.ipt, Bodenplatte-Holz.0001.ipt, Bodenplatte-Holz.ipt, Bodenplatte.iam, GesamterPlan.pdsprj, Luftkissenboot.0300.iam]
2021-02-02 datalogger improved
    [voltages_log02.csv, voltages_log03.csv]
2021-02-02 Platine Zeitschaltung Relais neu gezeichnet (für Verwendung mit Halbleiterrealais für Bucks)
    [Platine_Relais_V2.pdsprj]
2021-02-02 added spannungsteiler, widerstandswerte angepasst
    [Platine_Relais_V2.pdsprj]
2021-02-02 widerstandswerte nochamal genändert
    [Platine_Relais_V2.pdsprj]
2021-02-05 Inventor Bodenplatte hoffentlich fertig
    [40x60Staffel.0001.ipt, 40x60Staffel.ipt, Bodenplatte-Holz.0001.ipt, Bodenplatte-Holz.0005.ipt, Bodenplatte-Holz.ipt, Bodenplatte.0029.iam, Bodenplatte.iam, HalterungMotorregler.ipt]
2021-02-07 new HMI+ doku weiter
    [CAN_BUS_IDs.xlsx]
2021-02-08 added Fotos für Boardelektronik
2021-02-08 sync of boardelektronik
2021-02-12 added Fusion 360 Exports
    [ADC_Platine_Temperatursensoren.pdsprj, Adapter_Lenker v4.ipt, Fahnen_Halter v12.f3d, Fahnen_Halter v12.ipt, Fahnen_Halter_oben_v2 v20.ipt, Mount_Nextion_Display v32.ipt, Regler_Halter_Hinten v9.ipt, Spacer_Relay v2.ipt]
2021-02-12 inventor weitergmacht
    [Aufbau.0076.ipt, Aufbau.0079.ipt, Aufbau.ipt, Bodenplatte-Holz.0007.ipt, Bodenplatte-Holz.0018.ipt, Bodenplatte-Holz.ipt, Bodenplatte.0043.iam, Bodenplatte.0047.iam]
2021-02-12 moved folder
    [Adapter_Lenker v4.ipt, Fahnen_Halter v12.f3d, Fahnen_Halter v12.ipt, Fahnen_Halter_oben_v2 v20.ipt, Mount_Nextion_Display v32.ipt, Regler_Halter_Hinten v9.ipt, Spacer_Relay v2.ipt]
2021-02-12 added fusion f3d files
    [Adapter_Lenker v4.f3d, Fahnen_Halter v12.f3d, Fahnen_Halter_oben_v2 v20.f3d, Mount_Nextion_Display v32.f3d, Regler_Halter_Hinten v9.f3d, Spacer_Relay v2.f3d]
2021-02-13 hinterer aufbau hoffentlich fertig
    [Bodenplatte.0047.iam, Bodenplatte.0049.iam, Bodenplatte.iam, FahneHolz.0009.ipt, FahneHolz.ipt, Fahnen_Halter v12.0001.ipt, Fahnen_Halter_hauptteil.0002.ipt, Fahnen_Halter_hauptteil.ipt]
2021-02-17 platine relais fixed new hmi Version
    [Platine_Relais_V2.pdsprj]
2021-02-17 automatisches wegdrehen der Motoren durch Software fix behoben
    [main.cpp]
2021-02-19 inventor skizzen bodenplatte fertig
    [Bodenplatte.0057.iam, Bodenplatte.0058.iam, Bodenplatte.iam, GesamterPlan.pdsprj, HolzLatteLinks.0001.ipt, HolzLatteLinks.0004.ipt, HolzLatteLinks.ipt, HolzPlatterechts.0001.ipt]
2021-02-19 Bodenplatte Skizzen getauscht, fertig
    [40x60Staffel.0003.ipt, 40x60Staffel.0004.dwg, 40x60Staffel.0004.ipt, 40x60Staffel.dwg, 40x60Staffel.ipt, Bodenplatte-Holz.0003.dwg, Bodenplatte-Holz.0003_1.dwg, Bodenplatte-Holz.0018.ipt]
2021-02-19 update and sync
    [Hauptplatte.0002.dwg, Hauptplatte.dwg, Luftkissenboot.0366.iam, Luftkissenboot.0367.iam, Luftkissenboot.iam]
2021-02-20 added JetiBox config to protocol
    [CAN_BUS_IDs.xlsx]
2021-02-22 Conrad-Fehlerbericht geschrieben, Invotr Zeichnungen weitergemacht
    [FahneHolz.0009.ipt, FahneHolz.0011.ipt, FahneHolz.0016.dwg, FahneHolz.dwg, FahneHolz.ipt, InnenUnten.0004.dwg, InnenUnten.dwg, PlatteAussenEineSeite.0001.dwg]
2021-02-24 hinter aufbau zeichnungen fertig
    [HalterungServoHochSeitlich2.0002.ipt, HalterungServoHochSeitlich2.0003.dwg, HalterungServoHochSeitlich2.dwg, HalterungServoHochSeitlich2.ipt, HalterungServosHochSeitlich.0003.dwg, HalterungServosHochSeitlich.dwg, HolzServoHalterHinten.0002.dwg, HolzServoHalterHinten.dwg]
2021-02-25 3d-druckparts hinten
    [Fahnen_Halter_hauptteil.0003.dwg, Fahnen_Halter_hauptteil.0013.dwg, Fahnen_Halter_hauptteil.dwg, Fahnen_Halter_obenTeileServo.0007.dwg, Fahnen_Halter_obenTeileServo.dwg, Fahnen_Halter_rechteck.0005.dwg, Fahnen_Halter_rechteck.dwg]
2021-02-27 added Proteus exports to Doku
    [ADC_Platine_Temperatursensoren.pdsprj, Lenker_Platine.pdsprj, Platine_ADCS_old.pdsprj, Platine_Regler_Hinten_3.pdsprj, Servo_Controller_Platine.pdsprj]
2021-02-27 added buck converter and power resistor pictures + precharge circuit board to doku
2021-03-02 sync und change linkcolor
    [Adapter_Lenker v4.0001.ipt, Adapter_Lenker v4.ipt, Bodenplatte.0004.dwg, Bodenplatte.dwg, Lenkung.0119.iam, Lenkung.0131.iam, Lenkung.iam, Platte1.0012.ipt]
2021-03-02 inventor moved
    [40x60Staffel.0004.dwg, 40x60Staffel.0004.ipt, 40x60Staffel.dwg, 40x60Staffel.ipt, AdapterPoti2.0008.ipt, AdapterPoti2.ipt, AdapterPoti2.stl, Adapter_Lenker v4.0001.ipt]
2021-03-02 inventor moved back (OldVersions deleted
    [40x60Staffel.dwg, 40x60Staffel.ipt, AdapterPoti2.ipt, AdapterPoti2.stl, Adapter_Lenker v4.f3d, Adapter_Lenker v4.ipt, Aufbau.ipt, Bauteil1.ipt]
2021-03-02 included sourcecode of all arduinos to doku
2021-03-02 Kosnt Leknung zeichnungen fertig
    [AdapterLenker.dwg, AdapterPoti1.dwg, AdapterPoti2.dwg, Lenkung.iam, M4Gewindestange.dwg, M4Gewindestange.ipt, Mount_Nextion_Display_Deckel.dwg, Mount_Nextion_Display_Deckel.ipt]
2021-03-02 Konstruktion bis auf bilder fertig
    [Lenkung.iam, hintererAufbau.iam]
2021-03-02 added comments to proteus exports
    [Lenker_Platine.pdsprj, Platine_Regler_Hinten_3.pdsprj]
2021-03-02 bilder includiert
    [Lenkung.iam, Stange1Mitte.ipt]
2021-03-02 bilder upload
    [Bodenplatte.iam, Lenkung.iam, Luftkissenboot.iam, Stange1Mitte.ipt, hintererAufbau.iam]
2021-03-03 schaltplan angefangen
    [GesamterPlan.pdsprj]
2021-03-04 fixed bugs in software
    [main.cpp]
2021-03-07 fixed slider always at top when entering page
    [main.cpp]
2021-03-09 added PCB-Layouts to protokoll
    [ADC_Platine_Temperatursensoren.pdsprj, Lenker_Platine.pdsprj, Platine_Regler_Hinten_3.pdsprj, Servo_Controller_Platine.pdsprj]
2021-03-13 relaisansteuerung aded circuit and pcb updates part lists
2021-03-15 Abstract und Zusammenfassung geschrieben
2021-03-15 fomartierung und so
2021-03-15 lstset versucht und gescheitert
2021-03-16 dieses und jenes
2021-03-16 changed whitebalance of charging pictures
2021-03-17 added servos to doku
2021-03-19 kurzfassungen + bilder die schirch san
2021-03-19 added massefläche to Zeitverzögerung
    [Platine_Relais_V2.pdsprj]
2021-03-21 tippfehler und so
2021-03-21 tippfehler und grammatik und so was meiner mutter halt aufgfallen ist
2021-03-23 propeller hinten added
2021-03-23 added Propeller und kleine Relais
2021-04-01 started with Ueberischt for Boardelektronik
2021-04-01 Uebersicht Boardelektronik added
2021-04-01 added siehe to Boardelektronik Uebersicht
2021-04-01 finished Boardelektronik Uebersicht
2021-04-02 Uebersicht Boardelektronik updated
